CIROH-Snow/snow_sensing/hardware/README.md

### Snow Sensing Hardware

This folder contains hardware designs and specifications for building snow sensing stations, including sensors, dataloggers, communication peripherals, power, and deployment hardware.

Specific guidance on soldering, wiring, and constructing the station can be found in their respective guide files in this folder. Any programming and software instructions are found in the "code" folder of the repository.

We recommend that you begin with our [Getting Started Guide](../docs/getting_started.md).
