CIROH-Snow/snow_sensing/code/mayfly_datalogger/README.md

# Mayfly Datalogger Code

This folder contains the Arduino sketches that will ultimately be uploaded to the Mayfly datalogger that is used for making and recording snow measurements. There are two types of snow stations that you can deploy: 

1. Stand-alone stations that do not telemeter their data: These stations simply make measurements and record those measurements to a microSD card attached to the Mayfly datalogger board.
2. Stations that have telemetry via either cellular or 900 MHz spread spectrum radio modules: These stations likewise record measurements to an attached microSD card but also send that data either over 900 MHz spread spectrum radio to another data logger that is connected to a Hydrologic Information System (HIS) or directly posts that data to a HIS if it has cellular service at the station.

Further instruction is found in each sub-folder based on the approach you are planning on taking with your snow station. Regardless of which approach you choose, you need to follow the hardward configuration steps below to prepare your Mayfly datalogger and sensors for data collection.

## Hardware needed to successfully program the Mayfly datalogger and sensors 

The following hardware components are needed to successfuly configure and program your Mayfly datalogger and sensors:

* Mayfly datalogger: [EnviroDIY Link](https://www.envirodiy.org/product/envirodiy-mayfly-data-logger/)
* CR1220 battery: [DigiKey Link](https://www.digikey.com/en/products/detail/panasonic-bsg/CR1220/269740?s=N4IgTCBcDaIA4AYDMSC0A7AJiAugXyA)
* USB to USB-C cable (make sure it has a data line on it and that it isn't just a charging cable): [Amazon Link](https://www.amazon.com/Anker-2-Pack-Premium-Samsung-Galaxy/dp/B07DD5YHMH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)
* Sparkfun Bee explorer board: [SparkFun Link](https://www.sparkfun.com/products/11812)
* USB to mini USB cable (or whatever the Sparkfun Bee expolorer board USB port is; likewise make sure it isn't just a charging cable but that it has data transfer capabillities): [Amazon Link](https://www.amazon.com/Amazon-Basics-Charging-Transfer-Gold-Plated/dp/B00NH11N5A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)
* EnviroDIY grove to 3.5 mm stereo jack converter: [EnviroDIY Link](https://www.envirodiy.org/product/envirodiy-grove-to-3-5mm-stereo-jack-pack-of-2/) 
* Grove cable: [DigiKey Link](https://www.digikey.com/en/products/detail/seeed-technology-co-ltd/110990031/5482557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)
* MicroSD card: [Amazon Link](https://www.amazon.com/PNY-Elite-X-microSDXC-Memory-3-Pack/dp/B08T6QSBPJ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)
* EnviroDIY microSD vertical card adapter (optional and comes with Mayfly datalogger purchase): [EnviroDIY Link](https://www.envirodiy.org/product/envirodiy-vertical-microsd-card-adapter-pack-of-5/)

## Datalogger and Sensor Hardware Configuration Steps

**IMPORTANT: You need to complete the following steps to configure the datalogger and sensor hardware before you edit and upload the Arduino Mayfly sketch found in this folder for logging data.** This guide also assumes that you have already completed the required soldering, wiring, and construction steps for setting up a station. If you have not done so already, you should consult our [guide for getting started](../../docs/getting_started.md).

### 1. Set the real-time clock (RTC) on the Mayfly datalogger

1. Insert your coin battery with the positive side up into the battery slot found on the right side of the board below the two white LiPo connectors.
2. Open the Arduino IDE and connect your Mayfly to your laptop.
3. Under the "File" tab, navigate to the sketch needed for adjusting the RTC (note that you may have to scroll down a little in the Examples dropdown to the "Examples from custom libraries" subsection): Examples > EnviroDIY_DS3231 > adjust
4. Line 11 is where you adjust the datetime, following the parameters described in the comments above the line. Make sure you set this to the UTC time. The final sketch we upload to the Mayfly will have a parameter for adjusting to your timezone.
5. Once you have that ready, turn on your Mayfly and upload the sketch.
6. Check that you properly adjusted the RTC by turning on your serial monitor in the Arduino IDE (setting the baud rate to whatever was set in the setup function on line 16).
7. From here, **DO NOT POWER DOWN YOUR MAYFLY**. It will reset your Mayfly's RTC back to whatever you originally had in the program when you power it backup and the Mayfly runs the setup function again.
8. Upload a different example sketch while your Mayfly is still running just so you do not have to worry about it again.
9. Navigate to Examples > EnvrioDIY_DS3231 > now
10. Upload the sketch
11. You may now power off and disconnect the Mayfly without it reseting the RTC

### 2. Record pyranometer and pyrgeometer calibration factors

Make sure you have the pyranometer and pyrgeometer calibration factors on-hand. You will need them when you adjust the Arduino code on your Mayfly after these steps are complete. These should have been provided by the sensor manufacturer.

### 3. Measure the height of the Maxbotix snow sensor

If you are using the Maxbotix snow depth sensor to measure snow depth, you will need to measure the distance between the sensor and bare ground so that the datalogger program can determine zero snow depth.

1. You can manually measure this, or you can use the "test_maxbotix" file found in snow_sensing > code > utilities > test_sensors. When used after the sensor has been installed but before any snow has fallen, this program will read out the sensor height (distance from ground surface to the sensor). You should get a height in millimeters, and write it down so you can add it to your data logging sketch you'll upload upon final deployment.
2. It is suggested that you manually measure the height of the sensor, as it loses accuracy without a snow surface to measure.

### 4. Set SDI-12 addresses of meter Teros 12 soil sensors

If you are using the Meter Teros 12 soil sensors, you will need to set their SDI-12 addresses within the sensors themselves. They operate on SDI-12 protocol which requires unique addresses for each sensor since all of the sensors are connected to the same SDI-12 bus on the Mayfly datalogger. Use the following steps to set the SDI-12 addresses. 

1. Take one of your sensors and connect it to a stereo-jack to grove terminal converter, the same converter that you will use for your station deployment
2. Connect the grove end to one of the Mayfly's SDI-12 ports using a grove cable. There are two ports on the board. It does not matter which one you connect it to.
3. Open the Arduino IDE, and navigate through the examples: File > Examples > SDI-12 > b_address_change
4. Turn on your Mayfly and upload the b_address_change sketch
5. Open your serial monitor and adjust its baud rate to match what is defined for SERIAL_BAUD near the beginning of the sketch
6. Follow the serial monitor's prompts for changing the addresses, giving it a singular character for the address (it can be a number, uppercase letter, or lowercase letter) and pressing enter to send the character to the Mayfly
7. Take a Sharpie and identify the sensor itself with the address so you know which sensor is which when you go to install
8. You may consider having the following setup: sensor 'a' for a depth of 2", sensor 'b' for a depth of 8", and sensor 'c' for a depth of 20"

### 5. Set the switched power jumper headers on the Mayfly datalogger

These steps are described in the hardware wiring guide in the hardware section of this repository, but are included again here for double checking before final programming. Follow these steps to ensure that the switched power jumpers are set correctly on the Mayfly datalogger:

1. At the top of each grove port on the Mayfly, there is a little, black header with four pins that identifies how much voltage is supplied over the switched power to that grove terminal.
2. The voltage supplied to each terminal is set by moving the jumper that connects one of the three outer pins to each headers' center pin.
3. Using a very fine, sturdy point, such as a very small flathead screwdriver, carefully make the following adjustments:
   * Above the D5-6 grove terminal, move the jumper to 5v.
   * Above one of the SDI-12 grove terminals (it does not matter which), move the jumper to 12v.
   * Above the other SDI-12 grove terminal, move the jumper to 3v (it may already be there by default).
   * Above the D10-11 grove terminal, move the jumper to 5v.
   * Above the Aux Analog grove terminals, move the jumper to 3v (it may already be there by default).

### 6. Attach the MicroSD card

There are two options for attaching the MicroSD card. You may use the socket found on the left-hand side, or you may also use the adapter that likely came with your purchase of the Mayfly datalogger. Simply insert the 8 prongs of this adapter into the 8-pin header above the SD socket, matching the white outline on the Mayfly. Insert the MicroSD card into the slot and push down until it clicks.

### 7. Program XBee Radio Modules (OPTIONAL)

**NOTE: You need only follow these steps if you are adding telemetry to your snow sensing station.**

If you will be using the XBee S3B modules to develop a network of stations, you need to program those modules. Use the following steps:

1. Download the XCTU software for interfacing with the XBee modules
   * Click on the link: https://www.digi.com/products/embedded-systems/digi-xbee/digi-xbee-tools/xctu
   * Click on the button: "Visit Support to Download XCTU"
   * Scroll down to "Product Resources"
   * Under "Resources and Utilities" select the XCTU link for your operating system and follow the instructions
2. You will want an explorer board from sparkfun in order to easily interface with XCTU (https://www.sparkfun.com/products/11812)
   a. Note that there are other explorer boards you can get, but make sure you can obtain the necessary cables for powering and using serial communication
3. Attach your XBee S3B to the explorer making sure to match the board's geometry to the white outlines on the explorer
4. Attach the board to your computer. If you get a different explorer board, note that you may need to supply power externally, such as with a barrel jack and wall plug.
5. Open the XCTU software
6. In the top left, select the button showing a module with a magnifying glass over it to discover the radio module
7. Select the port the radio is connected to
8. Press Next
9. Make sure the following settings are set:
   * Baud Rate: 9600
   * Data Bits: 8
   * Parity: None
   * Stop Bits: 1
   * Flow Control: None
10. Press Finish
11. A list of discovered devices should appear. If this does not work, hit cancel and try to add the radio module in the home page by selecting the button with the + sign and using the same parameters
12. Select your device and press "Add selected devices"
13. You should be taken back to the home page where your device is listed on the left
14. Click on the module from that list (it should highlight orange when selecting it), avoiding the buttons on the right side
15. This will open up all the radio settings.
16. Under MAC/PHY settings, set Network ID (ID) to something significant to you that all radios will be on. Note that if two radios' network IDs do not match, they will not be able to communicate.
17. Under MAC/PHY settings, set Unicast Mac Retries (RR) to F
18. Under Network settings, set Mesh Unicast Retries (MR) to 5
19. Under Addressing settings, set the Node Identifier (NI) to something meaningful such as the name of the station the module will be placed on
20. Under Addressing settings, make sure that the Transmit Options (TO) is set to C0 (DigiMesh)
21. Under Serial Interfacing options, set API Enable (AP) to API Mode Without Escapes
22. Under Sleep Commands, set Sleep Mode (SM) to Async. Pin Sleep
23. Save these changes by pressing the "Write" button at the top
24. Your XBee is programmed, so clear it from the list on the left by clicking the module's "X" button
25. Unplug the cable from your computer or explorer before removing the XBee from the explorer

### Creating and uploading the final Mayfly sketch for logging data

Once your station is constructed and you have completed the above steps, you are ready to make adjustments to the Arduino sketch you would like to use. You will start with the Arduino sketches we have provided, make minor modifications to fit your deployed station, and then upload your final sketch to your Mayfly datalogger to collect data.

**NOTE:** We recommend getting the sketch for the snow sensing3 station with no telemetry working before you move on to the station with telemetry.

Follow the instructions for each sketch before uploading.

* [Snow sensing station with no telemetry](no-telemetry/README.md)
* [Snow sensing station with telemetry](telemetry/README.md)

**NOTE:** The datalogger sketches with telemertry contain all of the code for measuring and logging data along with the code for telemetring the data to a HIS.
