CIROH-Snow/snow_sensing/code/arduino_libraries/EnviroDIY_SoftwareSerial_PCINT12/README.md

# SoftwaterSerialMod
A modified version of the Arduino built-in SoftwareSerial library to work with other libraries using pin change interrupts.  This version only uses PCINT1 and PCINT2.
