CIROH-Snow/snow_sensing/code/base_station/base_figures/tgrs_example.png

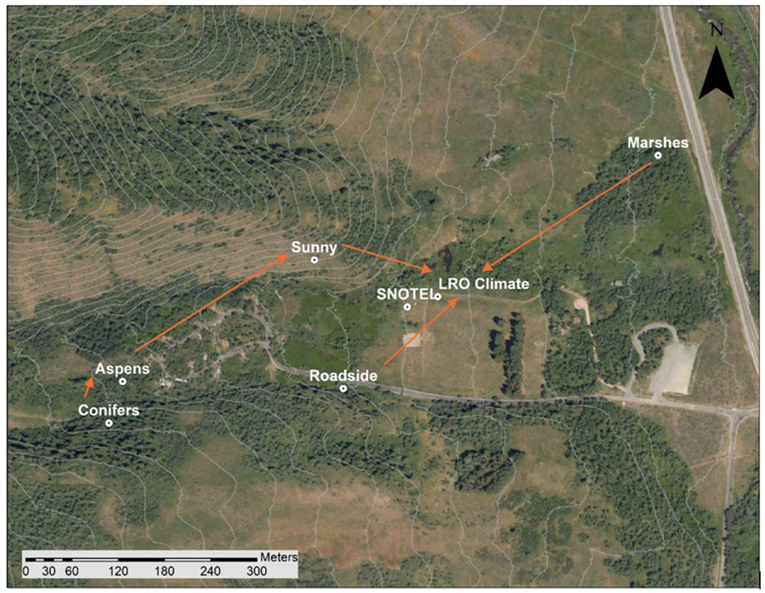
code/base_station/base_figures/tgrs_example.png
