CIROH-Snow/snow_sensing/hardware/hardware_spreadsheet_not_campbellsci.xlsx

Snow Sensing Node
Item | Number | Unit Cost | Total Cost |  | Notes
Datalogger and communication peripherals
EnviroDIY Mayfly data logger board | 1 | $120.00 | $120.00 | Link (https://www.envirodiy.org/product/envirodiy-mayfly-data-logger/)
CR1220 Coin cell battery | 1 | $1.12 | $1.12 | Link (https://www.digikey.com/en/products/detail/panasonic-bsg/CR1220/269740?s=N4IgTCBcDaIA4AYDMSC0A7AJiAugXyA) | For the real time clock on the Mayfly board
Grove cable connectors for connecting sensors (5 pack) | 2 | $3.50 | $7.00 | Link (https://www.digikey.com/en/products/detail/seeed-technology-co-ltd/110990031/5482557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) | Connectors for sensors. Four cables will be cut and splayed for conneting the Meter sensors
Grove screw terminal | 4 | $1.70 | $6.80 | Link (https://www.seeedstudio.com/Grove-Screw-Terminal.html) | Connect sensors to grove cables
Xbee Radio for datalogger communications | 1 | $79.00 | $79.00 | Link (https://www.amazon.com/gp/product/B07G1XQ1BS/ref=ppx_yo_dt_b_search_asin_title?ie=UTF8&psc=1) | 900 MHz - but other options available
Omnidirectional 900 MHz antenna | 1 | $3.99 | $3.99 | Link (https://www.data-alliance.net/antenna-824-960mhz-1710-1990mhz-3dbi-omnidirectional-dipole-w-sma-rp-sma-or-fme/) | These could be inadequate for distance/vegetation
3-port lever wire connectors (pack of 10) | 1 | $7.98 | $7.98 | Link (https://www.lowes.com/pd/IDEAL-Lever-Wire-Connectors-3-Ports-Clear-10-Pack/5014013101) | Sold in pack of 10
MicroSD card (pack of 2) | 1 | $6.23 | $6.23 | Link (https://www.amazon.com/SanDisk-2-Pack-microSDHC-Memory-2x32GB/dp/B08J4HJ98L?s=electronics) | 32 GB (Link is to a pack of 2 for $12.47)
EnvrioDIY grove to 3.5mm stereo jack | 3 | $7.00 | $21.00 | Link (https://www.envirodiy.org/product/envirodiy-grove-to-3-5mm-stereo-jack-pack-of-5/) | Provides stereo sensor connectors (Sold in packs of 5 for $35.00)
Compact wire splice connector quick terminal block | 2 | $2.87 | $5.74 | Link (https://www.amazon.com/GKEEMARS-Electrical-Connectors-Compact-Terminal/dp/B08Y5TGZR3) | Sold in packs of 8 for $22.98. Connects SDI-12 Meter sensors to singular port on Mayfly
Prototype PCB solderable breadboard | 1 | $1.70 | $1.70 | Link (https://www.amazon.com/gp/product/B07ZYNWJ1S/ref=ppx_yo_dt_b_asin_title_o02_s00?ie=UTF8&th=1) | For securing and connecting peripheral ADCs. Sold in packs of 5 for $8.49
Adafruit ADS1115 ADC | 2 | $14.95 | $29.90 | Link (https://www.adafruit.com/product/1085) | Necessary to expand Mayfly datalogger for taking differential measurements from all radiation sensors
6-pin PCB screw terminal block connector | 4 | $0.81 | $3.24 | Link (https://www.amazon.com/Augiimor-15PCS-2-54mm-Terminal-Connector/dp/B08B3SY1PG) | Terminal block to connect sensor wires to ADCs on PCB sold in pack of 15 for $12.99
Jumper cables (male-to-male) (pack of 120) | 1 | $6.88 | $6.88 | Link (https://www.amazon.com/Elegoo-EL-CP-004-Multicolored-Breadboard-arduino/dp/B01EV70C78)
I2C Qwiic cable pack | 1 | $9.99 | $9.99 | Link (https://www.amazon.com/gp/product/B08HQ1VSVL/ref=ppx_yo_dt_b_asin_title_o09_s00?ie=UTF8&psc=1) | Connects extra ADCs to Mayfly
PVC Jacketed 22 Gauge 5 conductor wire - cabling for MaxBotix sensor | 10 | $0.59 | $5.90 | Link (https://www.superbrightleds.com/pvc-jacketed-5-conductor-22-awg-power-wire-pp-frpvc-gray-wp22-5cmr) | Cable for Maxbotix snow depth sensor (Price is per foot. Length depends on deployment platform).
Data logger and communications total |  |  | $316.47
Instrumentation Enclosure and Mounts
Weather proof handgun case | 2 | $54.99 | $109.98 | Link (https://www.sportsmans.com/shooting-gear-gun-supplies/gun-cases-locks/handgun-cases/sportsmans-warehouse-16in-pistol-case/p/1873059) | One enclosure for the data logger and one for the battery. If you decide to go with a small enough battery to fit in the same enclosure as the data logger then you don't need two of these
U-bolts | 4 | $2.08 | $8.32 | Link (https://www.lowes.com/pd/National-Hardware-N222-182-U-Bolts-in-Zinc-Plated/5003643211) | For fastening the enclosure to the mast and for the solar panel. For the solar panel, you may want to get a u-bolt with a plate. These are zinc plated. Stainless would be better but more expensive. You may also have better luck finding them at Lowes or Campbell Scientific.
AM-130 Albedometer Mounting Fixture with 12" Rod | 2 | $42.00 | $84.00 | Link (https://www.apogeeinstruments.com/am-130-albedometer-mounting-fixture-with-12-rod/) | For mounting pyranometers and pyrgeometers
AM-240: Rod-based Mounting Fixture | 2 | $84.00 | $168.00 | Link (https://www.apogeeinstruments.com/am-240-rod-based-mounting-fixture/)
Nuts and bolts for solar panel | 1 | $1.48 | $1.48 | Link (https://www.lowes.com/pd/Hillman-1-4-in-20-x-3-4-in-Slotted-Drive-Machine-Screws-4-Count/3035943) | For improving the solar panel mount's rigidity
Mast padding for solar panel | 1 | $5.95 | $5.95 | Link (https://www.amazon.com/dp/B099QPW1SS?ref=fed_asin_title&th=1) | Holds solar panel against main mast. Sold in packs of 2 for $11.89
MaxBotix MB7950 Mounting Hardware | 1 | $3.43 | $3.43 | Link (https://www.digikey.com/en/products/detail/maxbotix-inc./MB7950-000/10279125?gad_source=1) | Seals and fixes MaxBotix sonar in sensor enclosure (sensor is not sealed so needs a separate enclosure)
Command strips package | 1 | $9.98 | $9.98 | Link (https://www.lowes.com/pd/Command-Medium-Picture-Hanging-Strips-Value-Pack/1000028619) | Sold in packs of 12 pairs. Used for mounting hardware inside enclosure (housekeeping essentially)
Polycase HD-22F NEMA Polycarbonate Enclosure | 1 | $7.40 | $7.40 | Link (https://www.polycase.com/hd-22f) | Waterproof enclosure for MaxBotix sonar (must drill enclosure lid to fix threaded end of sensor inside enclosure)
Cable glands package | 1 | $8.49 | $8.49 | Link (https://www.amazon.com/eBoot-Plastic-Waterproof-Adjustable-3-5-13mm/dp/B01GJ03AUQ?hvadid=194019628201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) | Running MaxBotix cable through enclosure sold in packs of 20 for $9.99 (must drill enclosure for cable gland)
Radiation shield | 1 | $54.99 | $54.99 | Link (https://www.amazon.com/dp/B003EB3GE4?ref=fed_asin_title) | For the Apogee ST-110 air temperature sensor
UV-resistant zip ties pack | 1 | $7.49 | $7.49 | Link (https://www.amazon.com/TR-Industrial-TR88302-Multi-Purpose-Cable/dp/B01018DC96) | For fixing cables to mast
Duct seal (16 oz.) | 1 | $4.68 | $4.68 | Link (https://www.lowes.com/pd/Gardner-Bender-16-oz-Duct-Seal/4595233) | For plugging the aluminum conduit - keeps out the critters
Southwire 3/4" aluminum conduit | 4 | $1.03 | $4.12 | Link (https://www.lowes.com/pd/Southwire/5003368089) | Sold in 100ft length for $103. Used for protecting soil moisture sensor cables from critters. 4 feet needed.
Enclosure total |  |  | $478.31
Power |  |  |  |  | Power system needs to power a 12V battery - 12V power is needed to run internal heaters on Apogee sensors
2-coil latching relay | 1 | $7.60 | $7.60 | Link (https://www.seeedstudio.com/Grove-2-Coil-Latching-Relay.html) | seeed studio module that can help control power to the apogee radiometer heaters
30 W solar panel and 12 V solar charger | 1 | $74.99 | $74.99 | Link (https://www.amazon.com/dp/B08GX2TLSF?ref=fed_asin_title&th=1) | These are really good, you'll just need to make the mounting a little more robust
Primary wire (black) | 1 | $7.54 | $7.54 | Link (https://www.lowes.com/pd/Southwire-24-ft-16-AWG-Stranded-Black-GPT-Primary-Wire/1001833882) | I would recommend just having extra wire, and you'll need a little bit anyways for splitting connections. I would have extra red and extra black
Primary wire (red) | 1 | $6.63 | $6.63 | Link (https://www.lowes.com/pd/Southwire-24-ft-16-AWG-Stranded-Red-GPT-Primary-Wire/1001833938) | I would recommend just having extra wire, and you'll need a little bit anyways for splitting connections. I would have extra red and extra black
12V 35Ah sealed lead acid battery | 1 | $86.99 | $86.99 | Link (https://www.amazon.com/Interstate-Batteries-battery-Terminal-SLA1155/dp/B000BPAGYY?s=automotive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) | This is just a basic size suggestion if you don't want to worry about sizing for a smaller battery. This should do if you get halfway-decent solar recharge
12V DC to 5V USB-C female DC step-down converter | 1 | $8.99 | $8.99 | Link (https://www.amazon.com/dp/B09DGDQ48H?ref=fed_asin_title) | Takes 12 volts down to what the Mayfly can handle
16 AWG extension cable for solar panel (25-ft length) | 1 | $15.50 | $15.50 | Link (https://www.amazon.com/POWISER-Extension-Disconnect-Connector-Automotive/dp/B07Z7T494M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) | Only necessary if locating solar panel away from station, in which case you will need to measure out how much you need.
Alligator Clips | 2 | $0.67 | $1.34 | Link (https://www.amazon.com/dp/B0BG7RCC11?sp_csd=d2lkZ2V0TmFtZT1zcF9kZXRhaWw) | These are needed to make a connection to the battery. Sold in packs of 6 for $3.99
Power Total |  |  | $209.58
Sensors
METER Teros 12 soil moisture, temperature, electrical cond., 3 depths | 3 | $258.00 | $774.00 | Link (https://www.metergroup.com/en/meter-environment/products/teros-12-soil-moisture-sensor) | SDI-12 output - 4 measurements
MaxBotix MB7374 snow depth analog voltage or pulse width output | 1 | $134.00 | $134.00 | Link (https://www.digikey.com/en/products/detail/maxbotix-inc/MB7374-100/7896824) | Pulse width or single ended voltage output
SL-510-SS Apogee upward pyrgeometer | 1 | $599.00 | $599.00 | Link (https://www.apogeeinstruments.com/sl-510-ss-pyrgeometer-upward-looking/) | Analog differential voltage output
SL-610-SS Apogee downward pyrgeometer | 1 | $599.00 | $599.00 | Link (https://www.apogeeinstruments.com/sl-610-ss-pyrgeometer-downward-looking/) | Analog differential voltage output
SP-710-SS Apogee upward and downward pyranometer | 1 | $663.00 | $663.00 | Link (https://www.apogeeinstruments.com/sp-710-ss-albedometer-sensor-package/) | Analog differential voltage output
ST-110-SS Apogee thermistor temperature sensor | 1 | $85.00 | $85.00 | Link (https://www.apogeeinstruments.com/st-110-ss-thermistor-temperature-sensor/?gad_source=1) | For air temperature. Analog bridge measurement
Sensors Total |  |  | $2854.00
Platform
Down guy wire kit | 1 | $52.00 | $52.00 | Link (https://www.amazon.com/gp/product/B011AEQVNY/ref=ppx_yo_dt_b_search_asin_title?ie=UTF8&psc=1) | Tripod includes guy wire kit, anchors, lightning rod, and grounding kit.
Galvanized steel fence post | 1 | $28.77 | $28.77 | Link (https://www.lowes.com/pd/Common-1-5-8-in-x-1-5-8-in-x-8-ft-Actual-1-66-in-x-1-66-in-x-8-ft-Silver-Galvanized-Steel-Chain-Link-Fence-Line-Post/999990212) | This will be the center mast. You can find taller ones if you have really deep snow packs
U-post | 1 | $5.98 | $5.98 | Link (https://www.lowes.com/pd/Blue-Hawk-Common-3-1-2-in-x-4-ft-Actual-0-6-in-x-3-5-in-x-4-ft-Powder-Coated-Steel-Garden-Fence-U-post-Post/4780963) | You don't need anything crazy here, just something to hold the bottom in place and that can be driven into the ground a fair distance
Grounding cable | 4 | $1.98 | $7.92 | Link (https://www.lowes.com/pd/Southwire-SIMpull-4-AWG-Stranded-Black-Copper-THHN-Wire-By-the-Foot/50101584) | Sold by the foot. You really just need to reach the mast, as you can connect the wire to the mast at any point
Grounding rod and wire clamp | 1 | $19.70 | $19.70 | Link (https://www.amazon.com/GOUNENGNAIL-Copper-Grounding-Rod-Satellite/dp/B08PKZYVLV)
Grounding clamp | 1 | $8.98 | $8.98 | Link (https://www.lowes.com/pd/Sigma-ProConnex-1-1-4-in-Bronze-Grounding-Clamp-Conduit-Fittings/1099109) | Connects grounding wire to mast
Rebar stakes | 1 | $20.49 | $20.49 | Link (https://www.amazon.com/Fercery-Diameter%EF%BC%8CBaking-Process-Paint%EF%BC%8CSteel-Landscpe/dp/B0CM5CCT2T) | Three stakes needed
CM206 6' Campbell Scientific instrumentation crossarm with mounting bracket | 1 | $162.24 | $162.24 | Link (https://www.campbellsci.com/cm206) | Instrumentation crossarm includes right angle mounting bracket for vertical mast.
Mounting Total |  |  | $306.08
Snow Monitoring Station Total: |  |  | $4164.44
