CIROH-Snow/snow_sensing/docs/getting_started.md

# Getting Started 

This document provides a step-by-step overview of the process required to build and program a snow sensing station. The following are links to each of the steps you must complete to create a working station.

1. [Determine a deployment platform](../hardware/deployment_platform.md)
2. [Purchase required hardware components](../hardware/hardware_purchase.md)
3. [Solder necessary components](../hardware/soldering_guide.md)
4. [Construct your station](../hardware/construction_guide.md)
5. [Wire your station and datalogger](../hardware/wiring_guide.md)
6. [Program your station for field data collection](../code/README.md)

**NOTE:** We recommend that you run through all of these steps prior to taking all of the components to the field for deployment. This will enable you to test your station prior to field deployement and will also make it much easier to troubleshoot any issues before going to the field.
