CIROH-Snow/snow_sensing/code/mayfly_datalogger/mayfly_datalogger_figures/hydroserver_setup.png

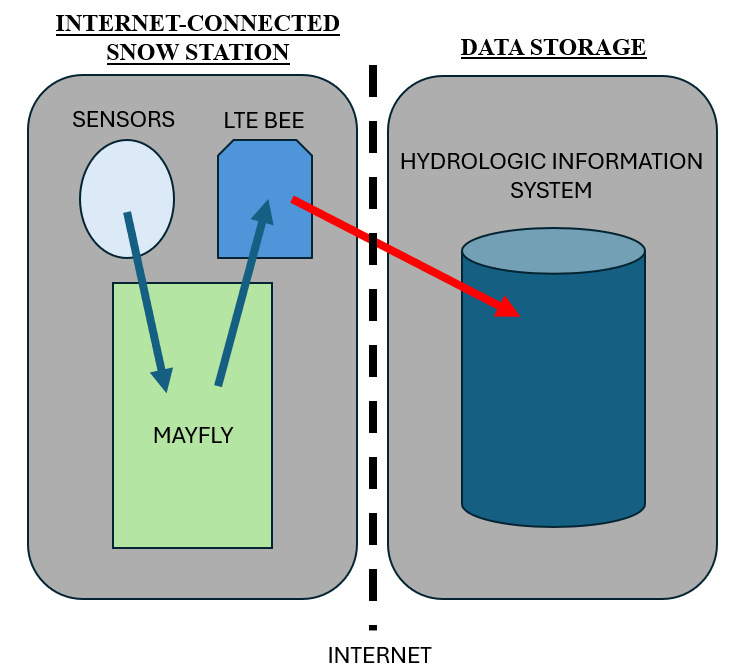
code/mayfly_datalogger/mayfly_datalogger_figures/hydroserver_setup.png
