CIROH-Snow/snow_sensing/hardware/construction_images/IMG_9145.JPG

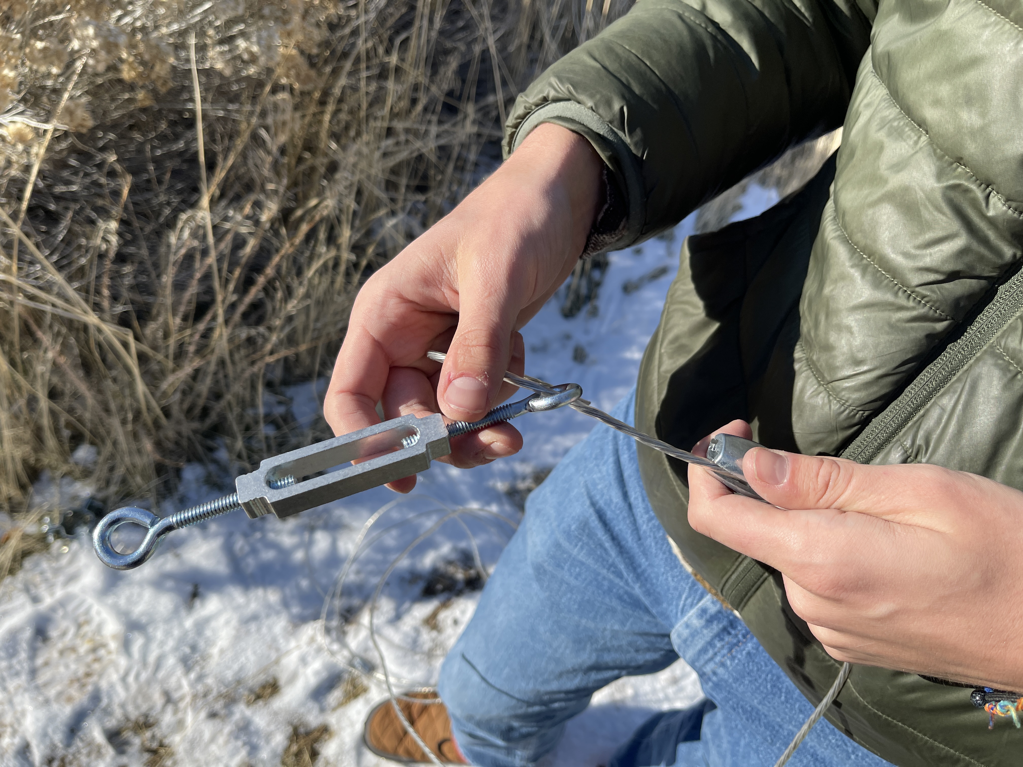
hardware/construction_images/IMG_9145.JPG
