CIROH-Snow/snow_sensing/hardware/construction_images/IMG_9151.JPG

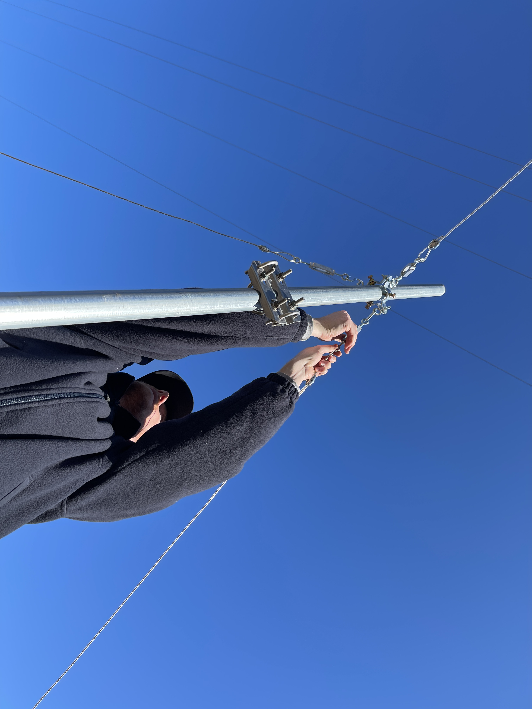
hardware/construction_images/IMG_9151.JPG
