CIROH-Snow/snow_sensing/hardware/construction_images/IMG_9152.JPG

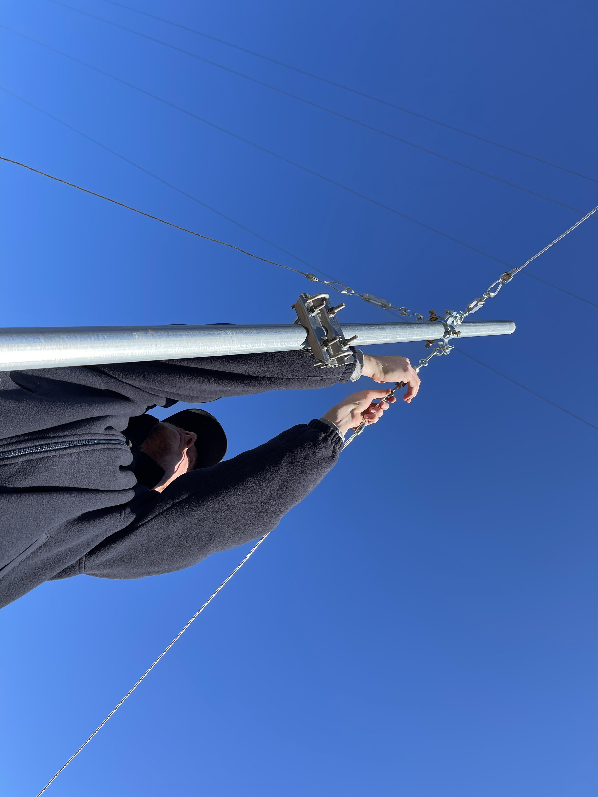
hardware/construction_images/IMG_9152.JPG
