CIROH-Snow/snow_sensing/hardware/construction_images/IMG_9164.JPG

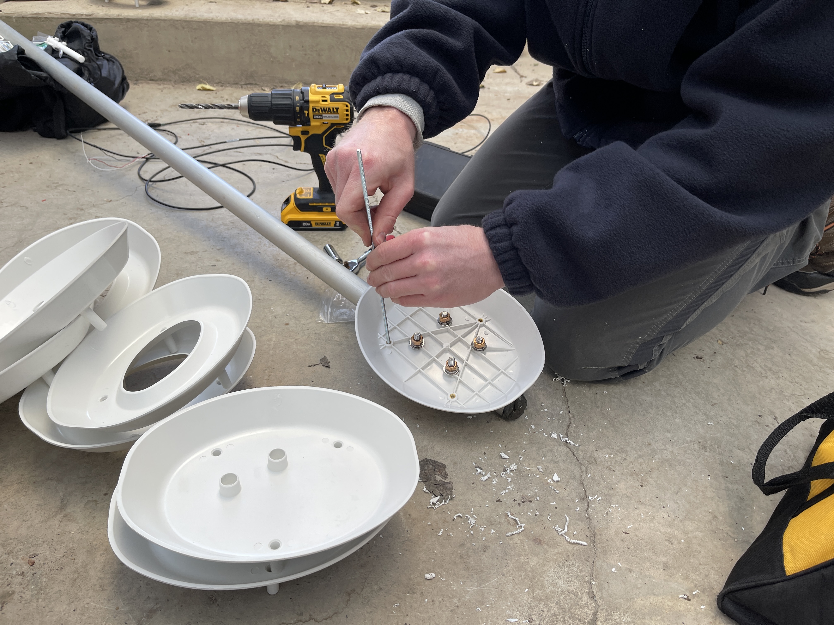
hardware/construction_images/IMG_9164.JPG
