CIROH-Snow/snow_sensing/hardware/construction_images/IMG_9165.JPG

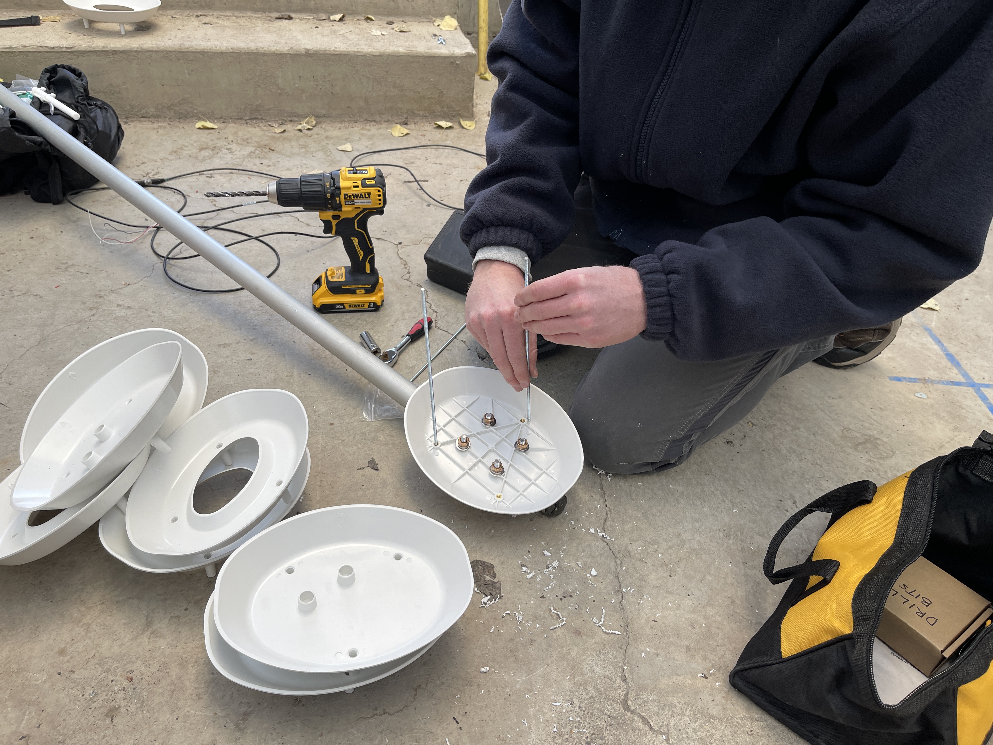
hardware/construction_images/IMG_9165.JPG
