CIROH-Snow/snow_sensing/hardware/construction_images/IMG_9166.JPG

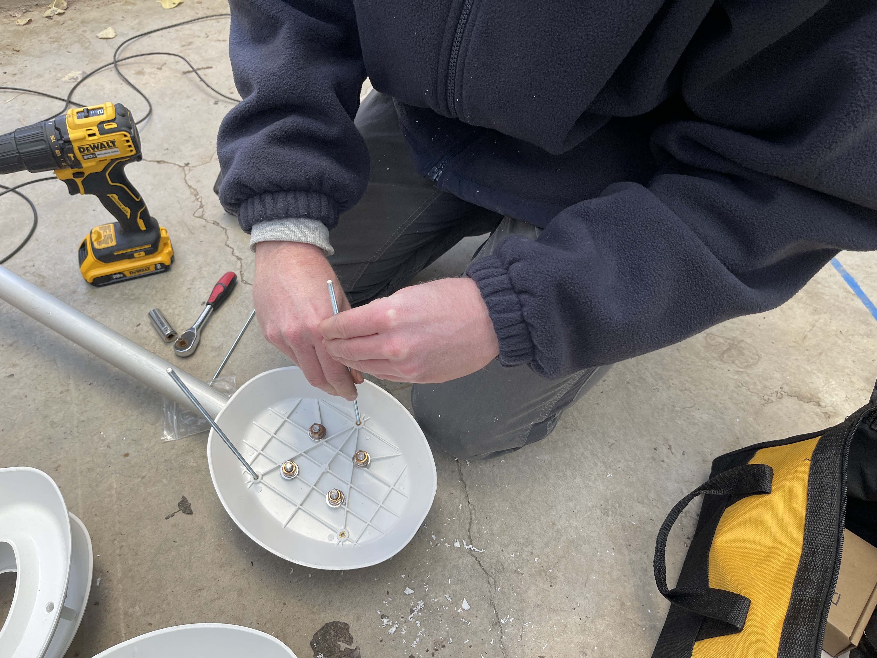
hardware/construction_images/IMG_9166.JPG
