CIROH-Snow/snow_sensing/hardware/construction_images/IMG_9168.JPG

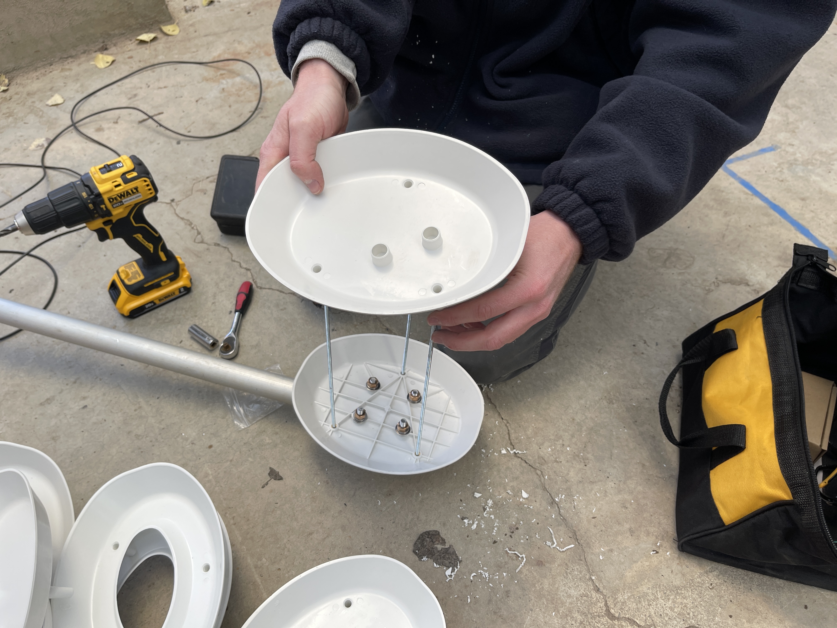
hardware/construction_images/IMG_9168.JPG
