CIROH-Snow/snow_sensing/hardware/construction_images/IMG_9172.JPG

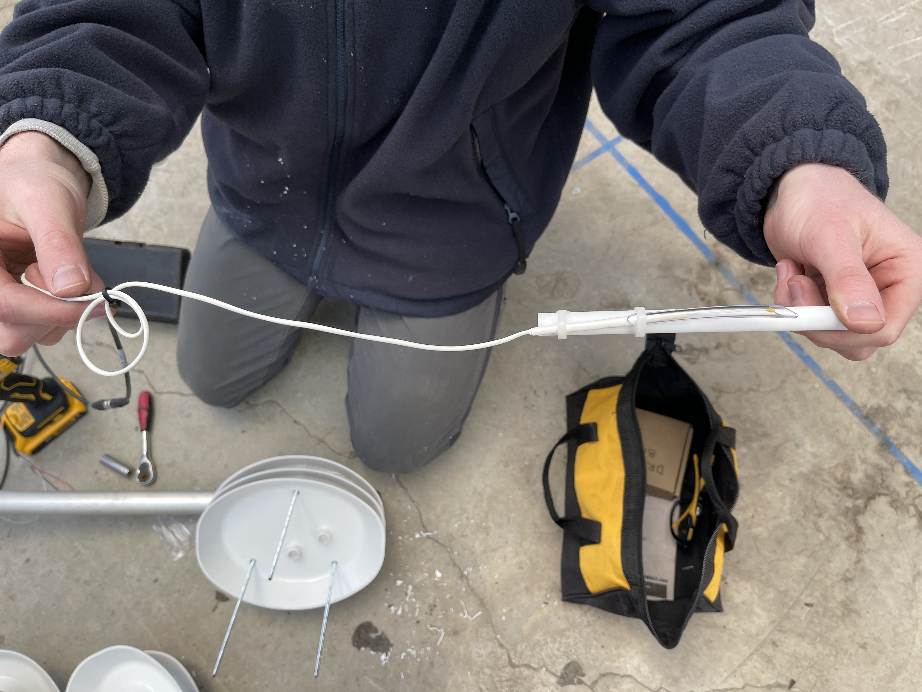
hardware/construction_images/IMG_9172.JPG
