CIROH-Snow/snow_sensing/hardware/construction_images/IMG_9173.JPG

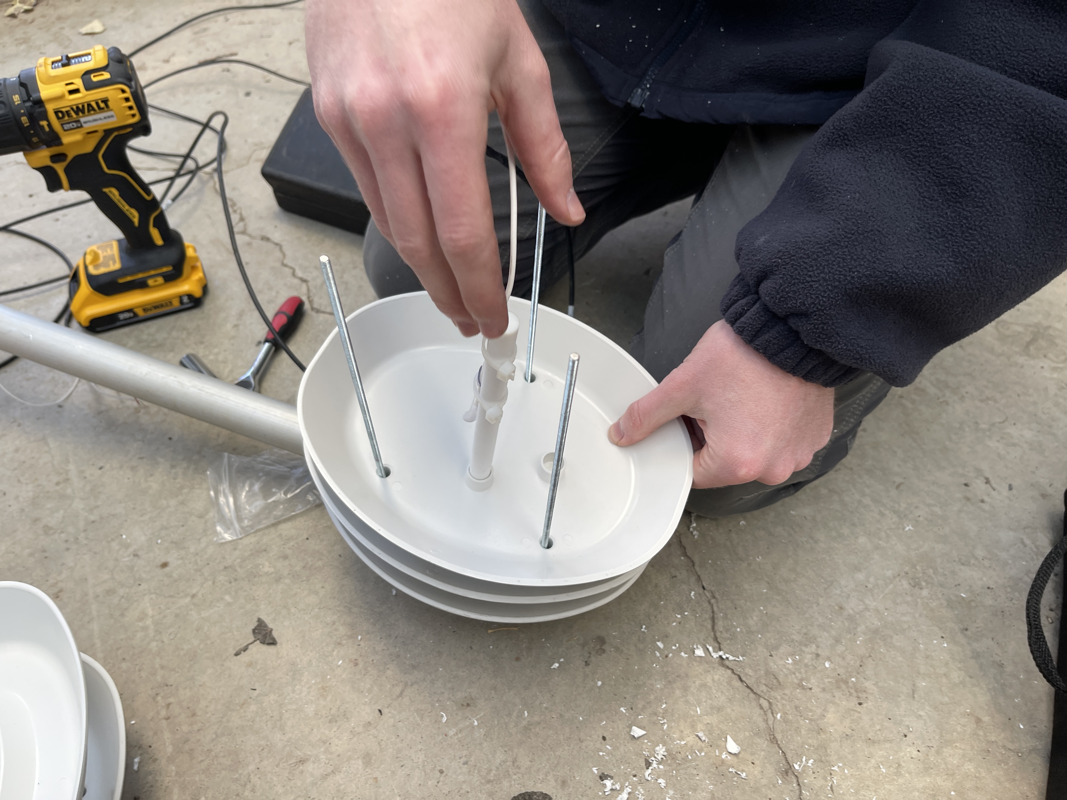
hardware/construction_images/IMG_9173.JPG
