CIROH-Snow/snow_sensing/hardware/construction_images/IMG_9177.JPG

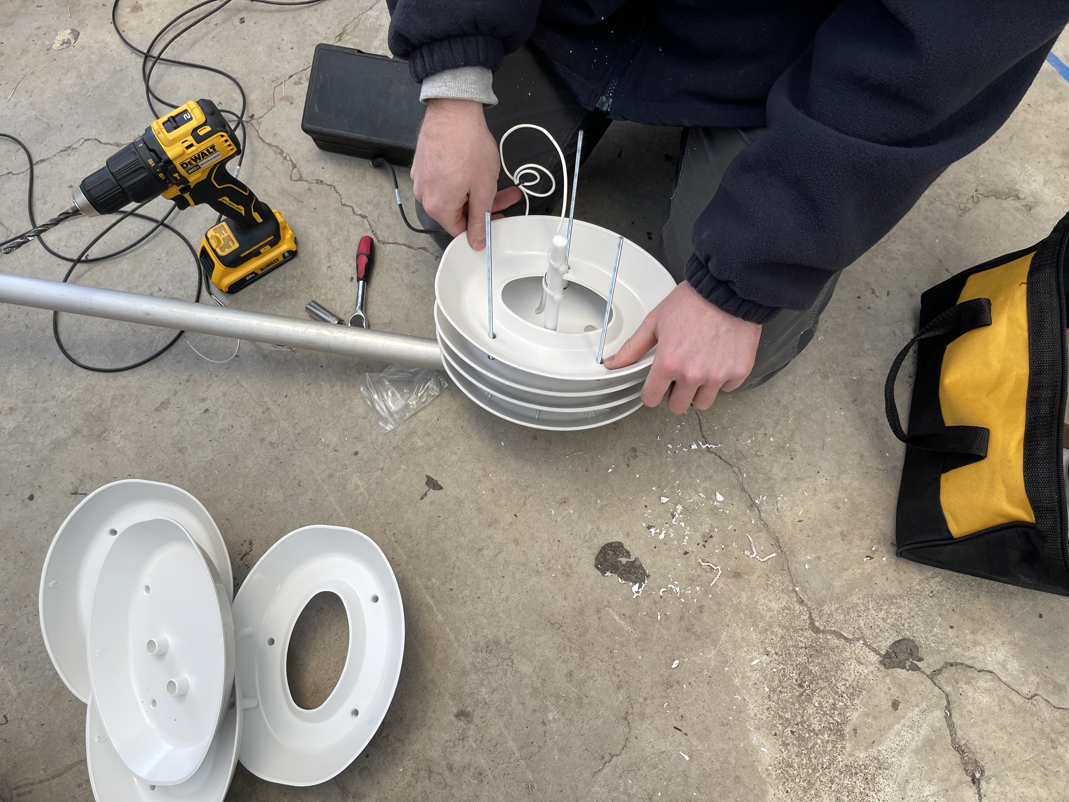
hardware/construction_images/IMG_9177.JPG
