CIROH-Snow/snow_sensing/hardware/construction_images/IMG_9178.JPG

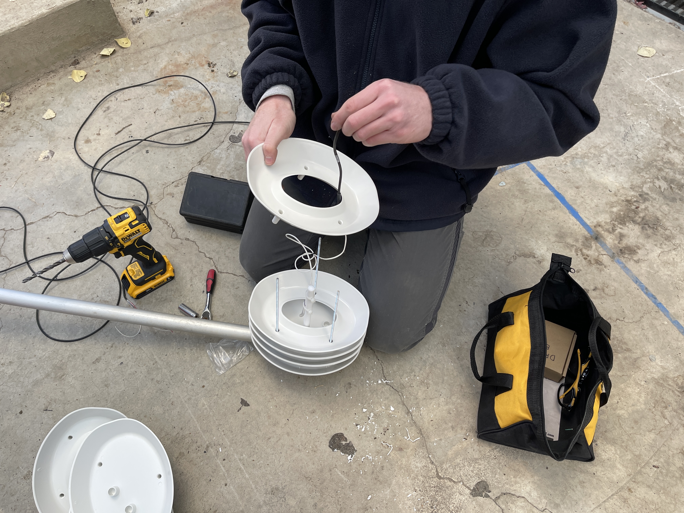
hardware/construction_images/IMG_9178.JPG
