CIROH-Snow/snow_sensing/hardware/construction_images/IMG_9179.JPG

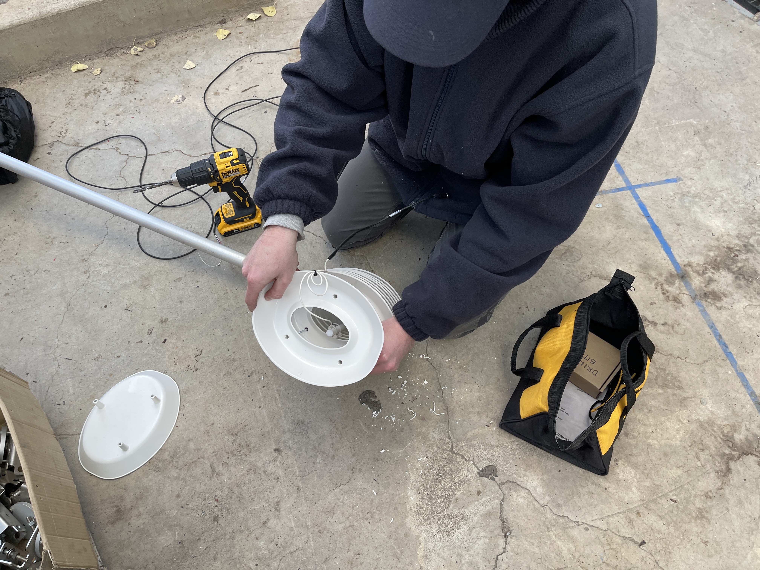
hardware/construction_images/IMG_9179.JPG
