CIROH-Snow/snow_sensing/hardware/construction_images/IMG_9181.JPG

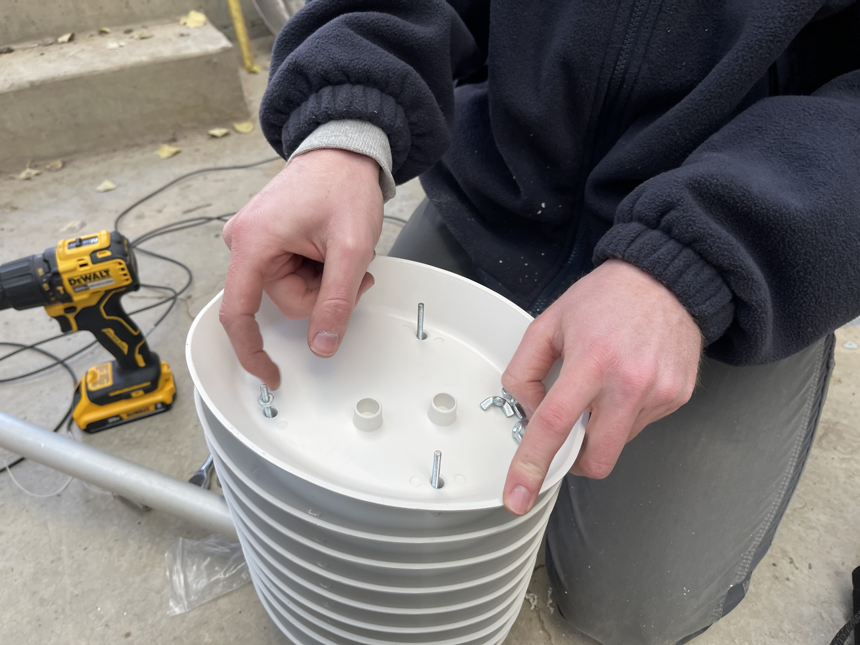
hardware/construction_images/IMG_9181.JPG
