CIROH-Snow/snow_sensing/hardware/construction_images/IMG_9182.JPG

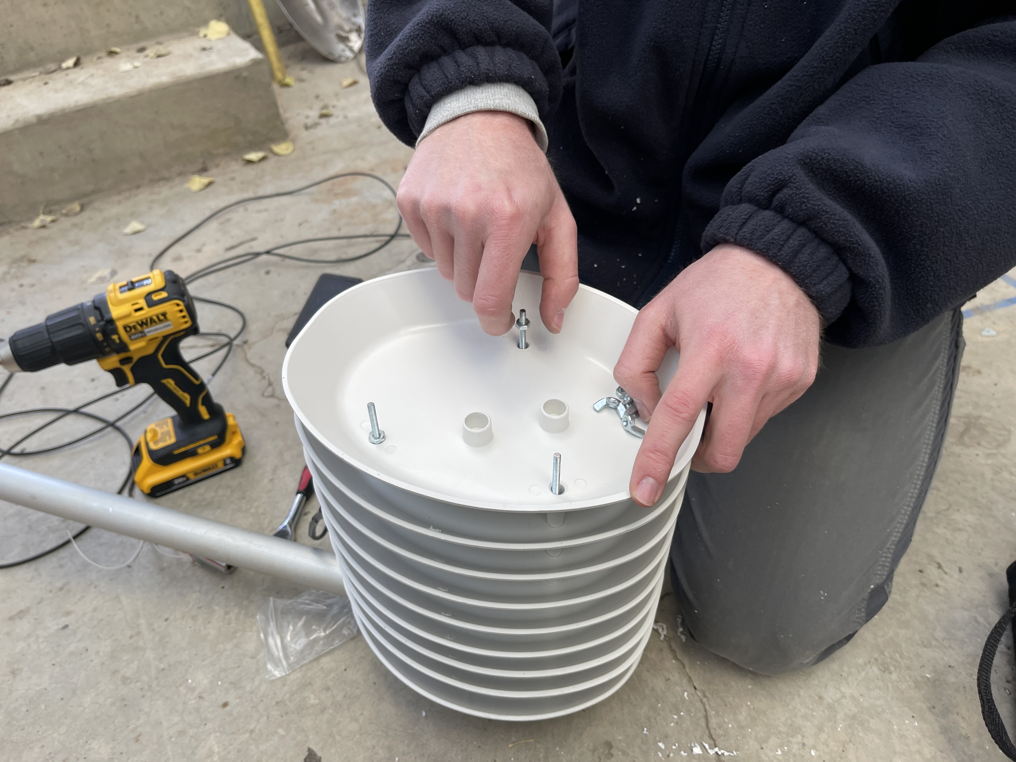
hardware/construction_images/IMG_9182.JPG
