CIROH-Snow/snow_sensing/hardware/construction_images/IMG_9183.JPG

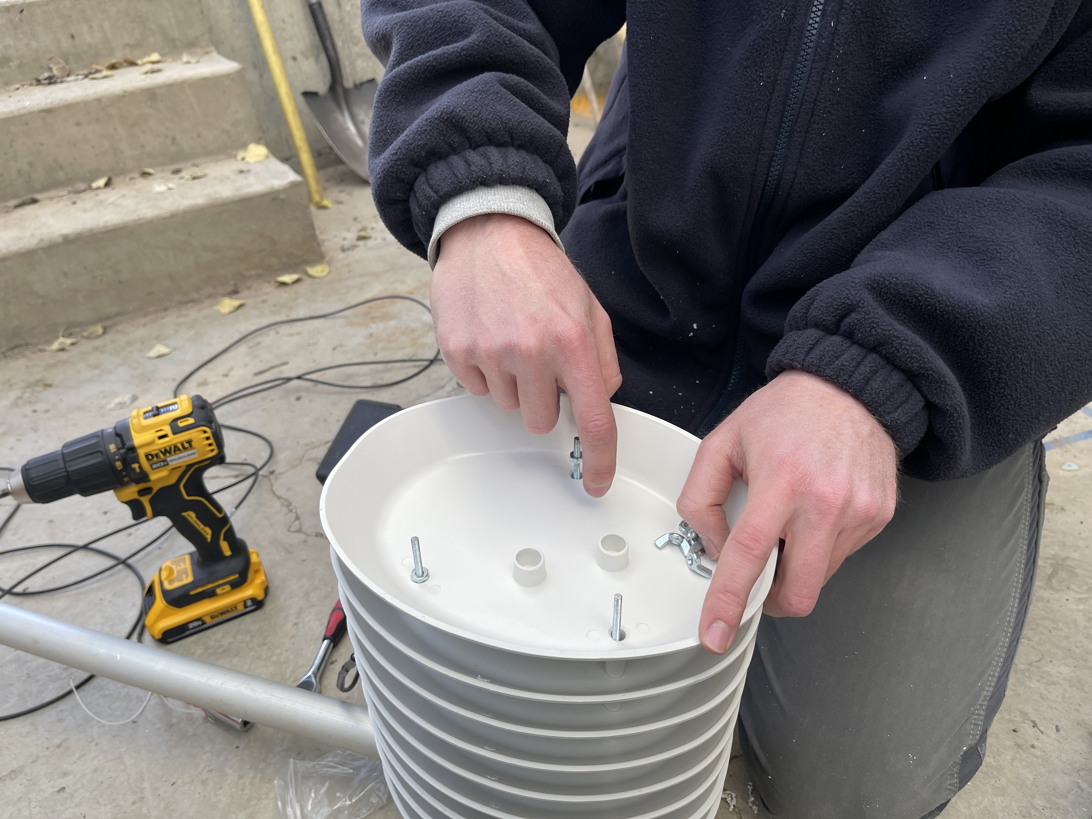
hardware/construction_images/IMG_9183.JPG
