CIROH-Snow/snow_sensing/hardware/construction_images/IMG_9185.JPG

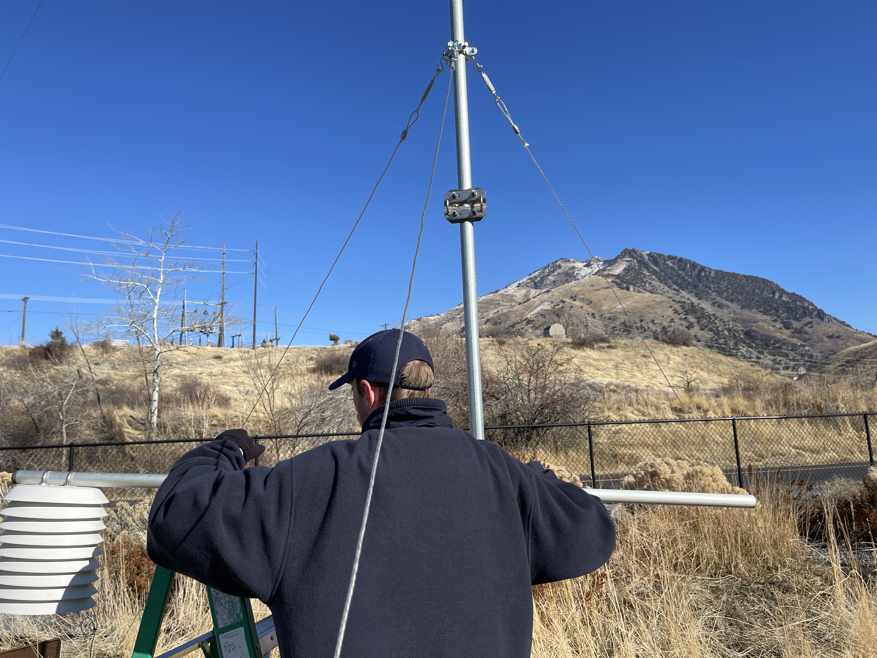
hardware/construction_images/IMG_9185.JPG
