CIROH-Snow/snow_sensing/hardware/construction_images/IMG_9187.JPG

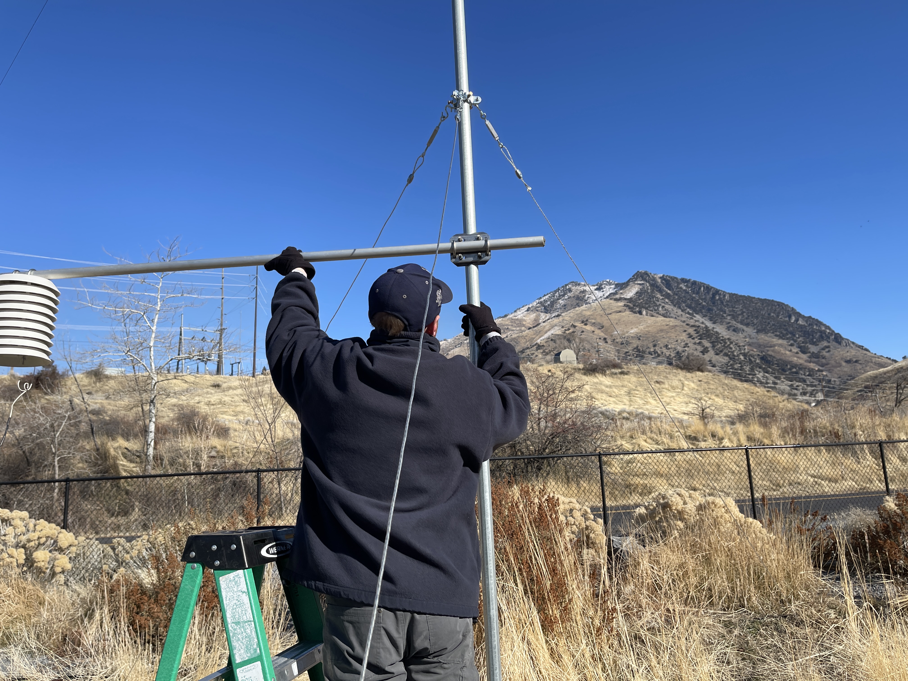
hardware/construction_images/IMG_9187.JPG
