CIROH-Snow/snow_sensing/hardware/construction_images/IMG_9188.JPG

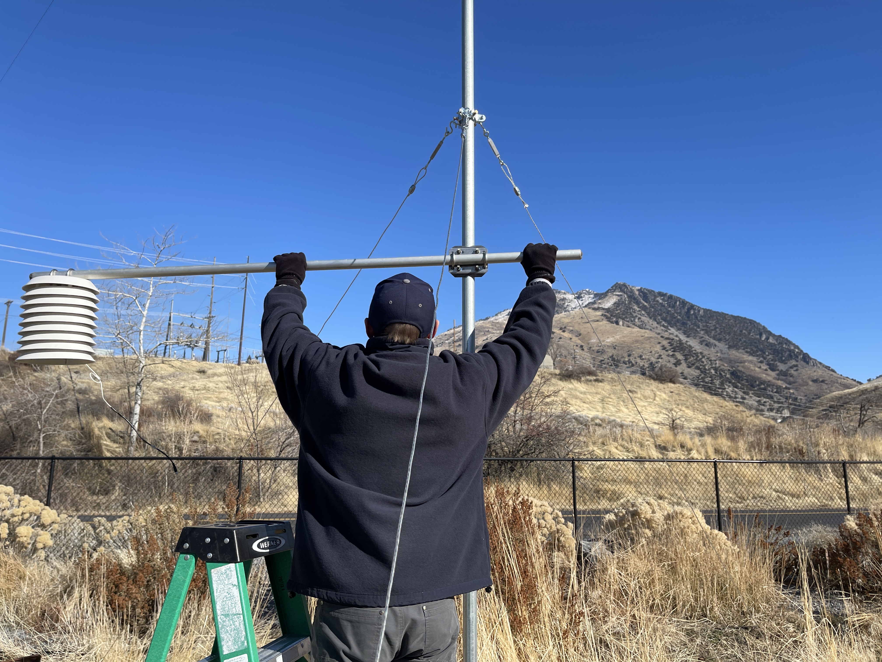
hardware/construction_images/IMG_9188.JPG
