CIROH-Snow/snow_sensing/hardware/construction_images/IMG_9197.JPG

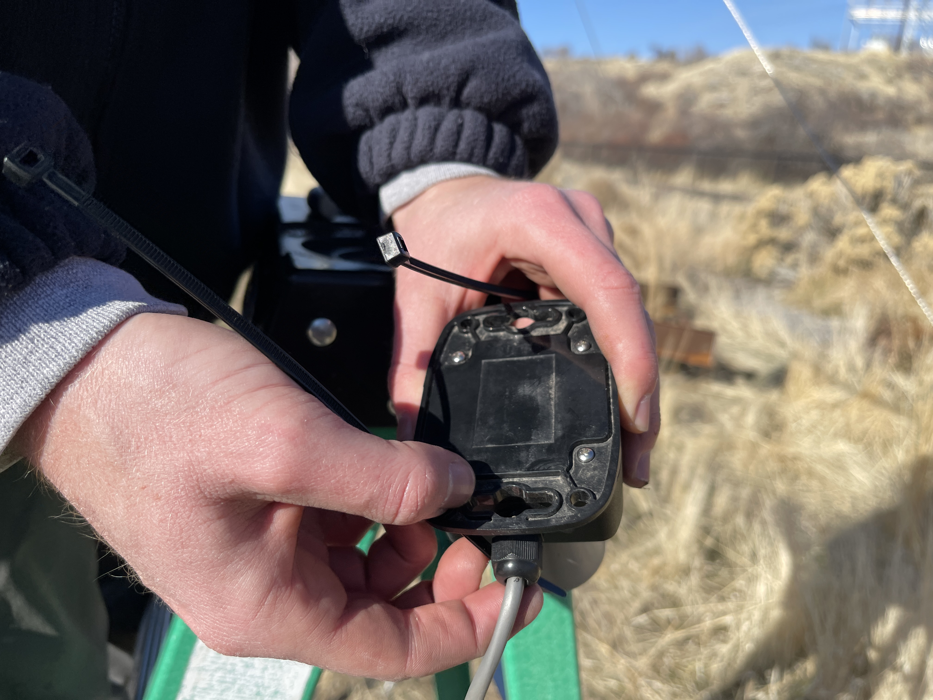
hardware/construction_images/IMG_9197.JPG
