CIROH-Snow/snow_sensing/hardware/construction_images/IMG_9198.JPG

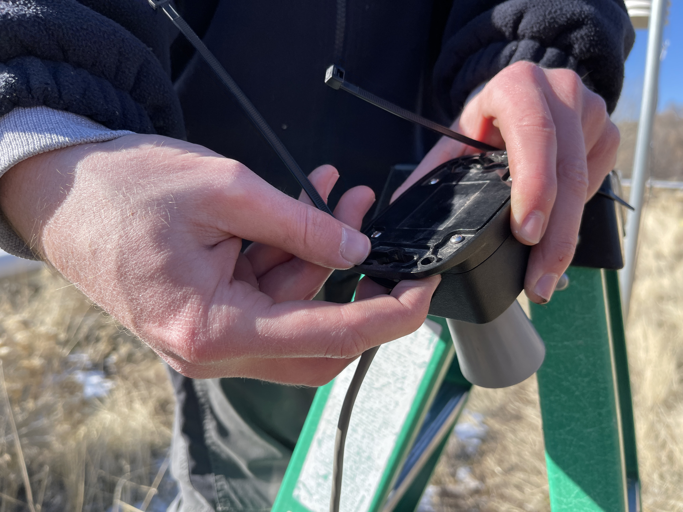
hardware/construction_images/IMG_9198.JPG
