CIROH-Snow/snow_sensing/hardware/construction_images/IMG_9199.JPG

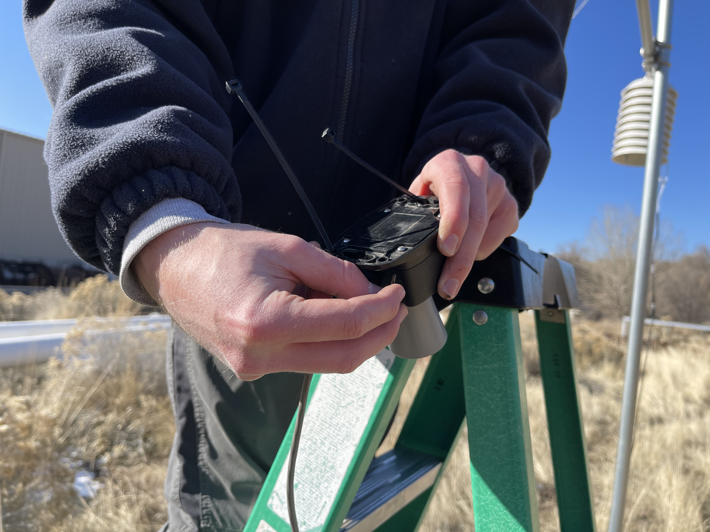
hardware/construction_images/IMG_9199.JPG
