CIROH-Snow/snow_sensing/hardware/construction_images/IMG_9200.JPG

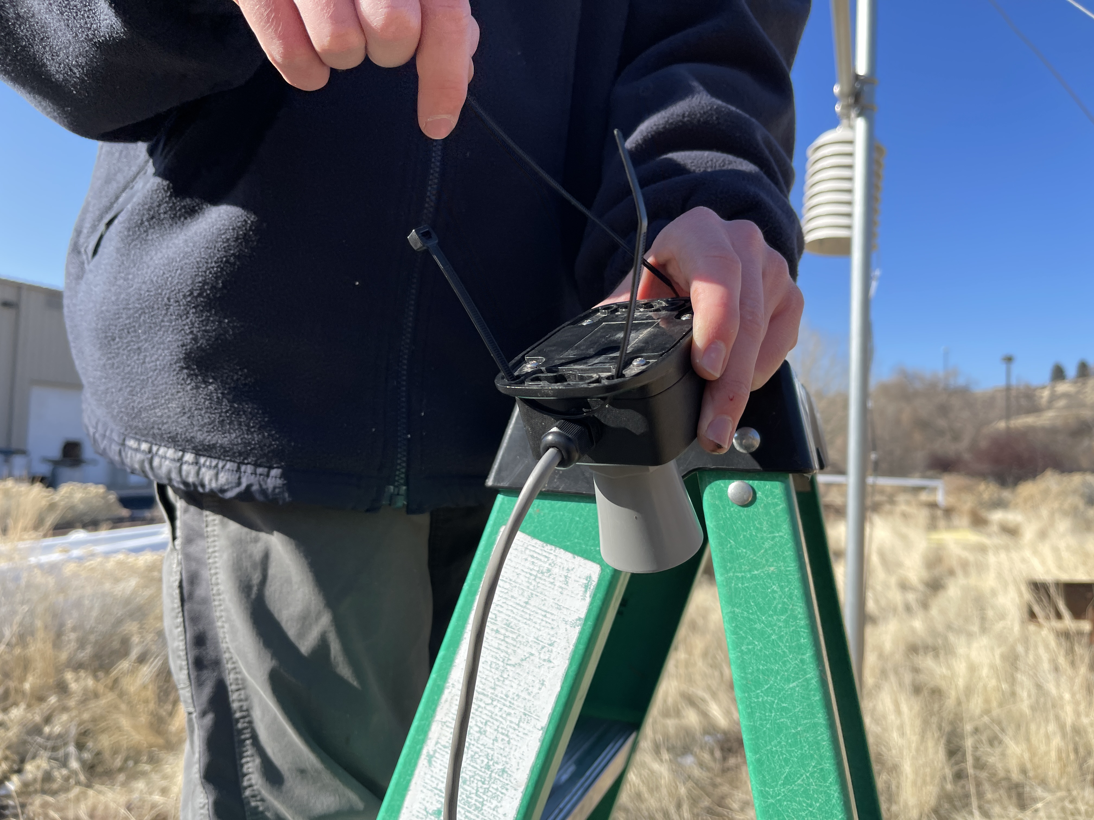
hardware/construction_images/IMG_9200.JPG
