CIROH-Snow/snow_sensing/hardware/construction_images/IMG_9201.JPG

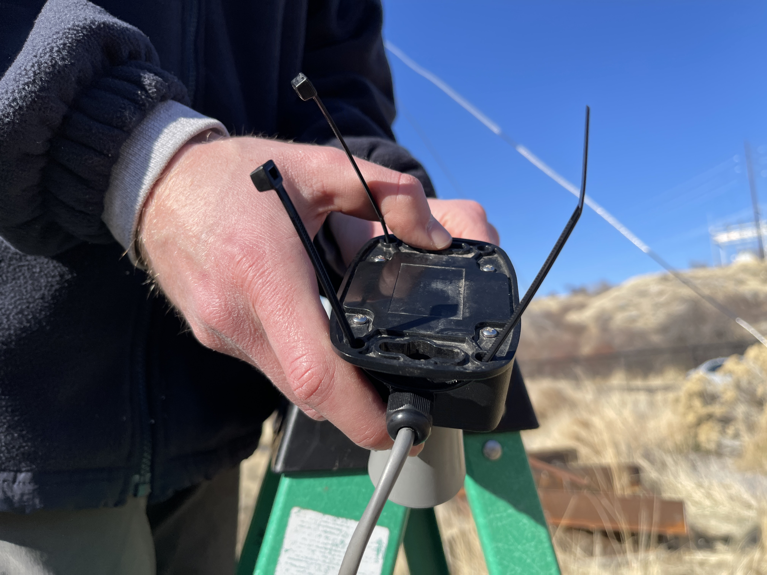
hardware/construction_images/IMG_9201.JPG
