CIROH-Snow/snow_sensing/hardware/construction_images/IMG_9203.JPG

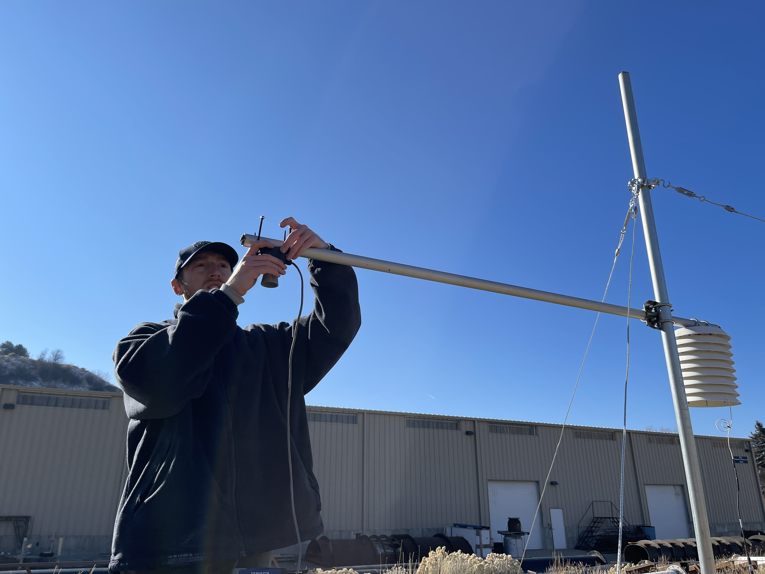
hardware/construction_images/IMG_9203.JPG
