CIROH-Snow/snow_sensing/hardware/construction_images/IMG_9206.JPG

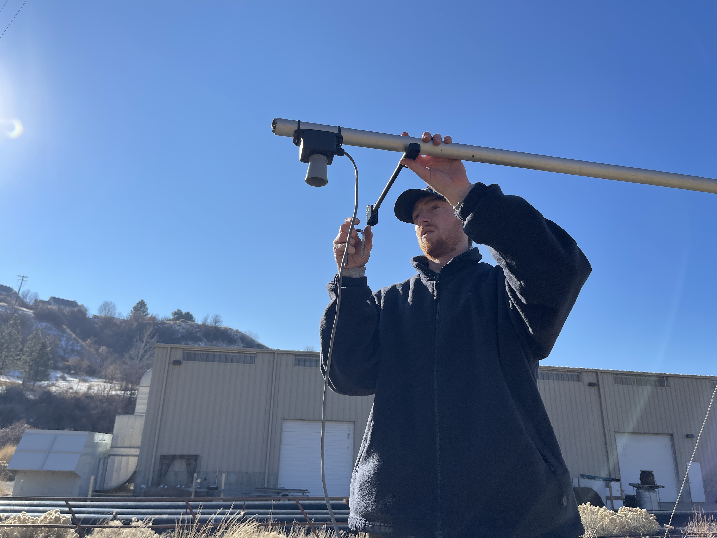
hardware/construction_images/IMG_9206.JPG
