CIROH-Snow/snow_sensing/hardware/construction_images/IMG_9207.JPG

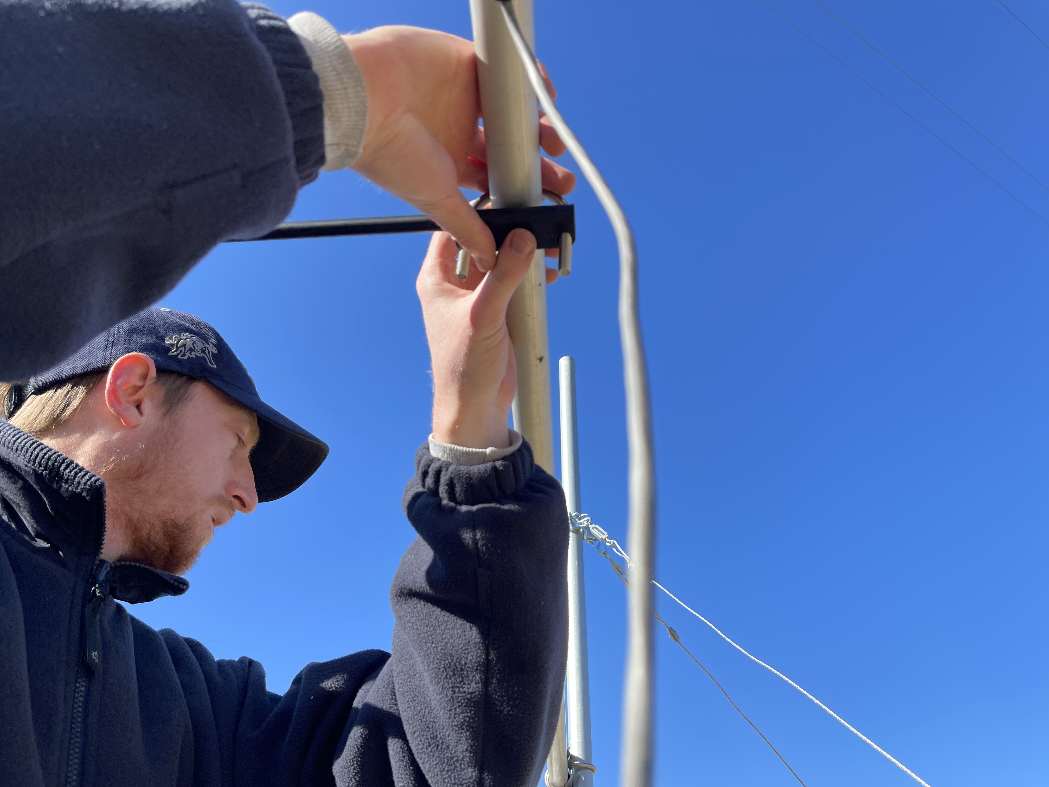
hardware/construction_images/IMG_9207.JPG
