CIROH-Snow/snow_sensing/hardware/construction_images/IMG_9208.JPG

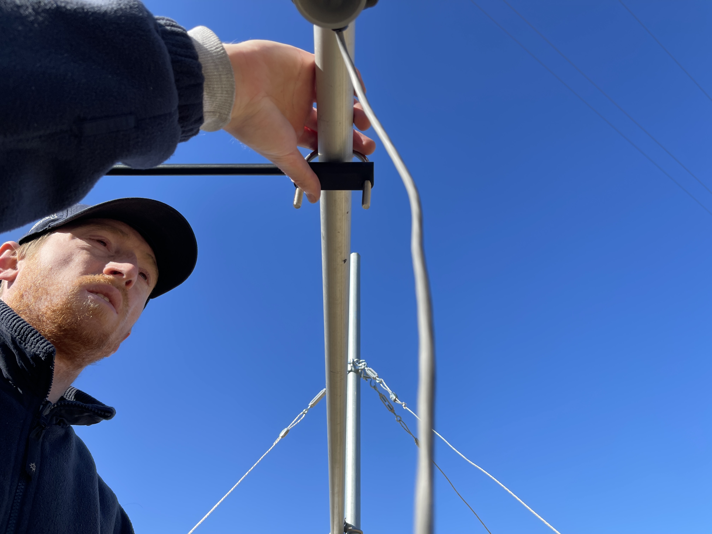
hardware/construction_images/IMG_9208.JPG
