CIROH-Snow/snow_sensing/hardware/construction_images/IMG_9209.JPG

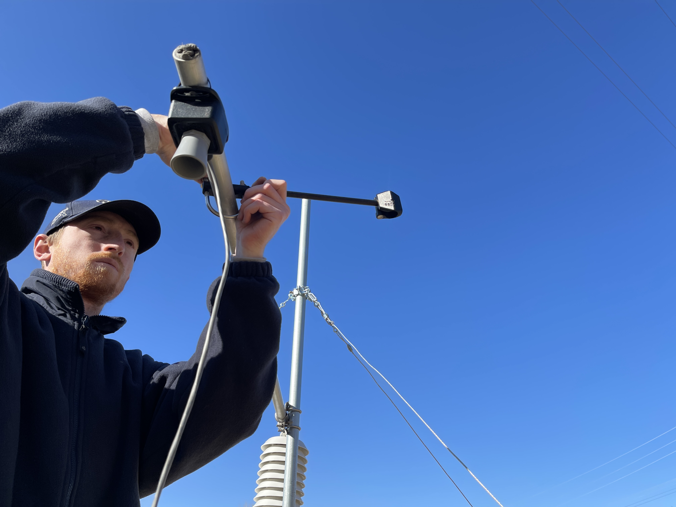
hardware/construction_images/IMG_9209.JPG
