CIROH-Snow/snow_sensing/hardware/construction_images/IMG_9211.JPG

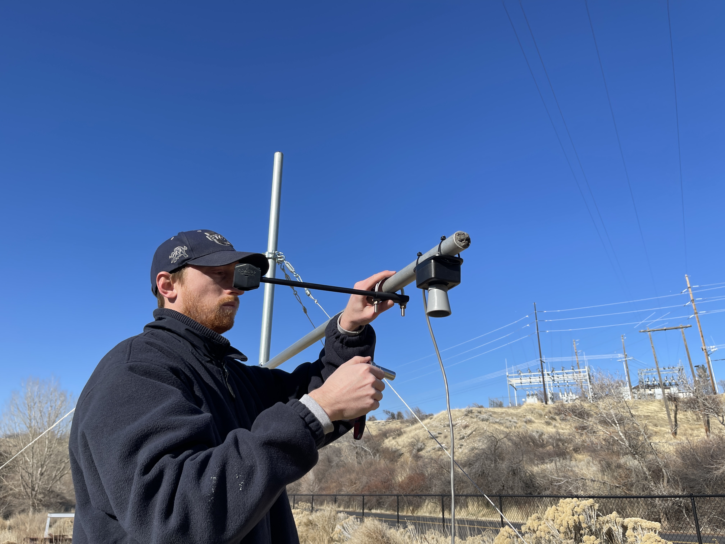
hardware/construction_images/IMG_9211.JPG
