CIROH-Snow/snow_sensing/hardware/construction_images/IMG_9215.JPG

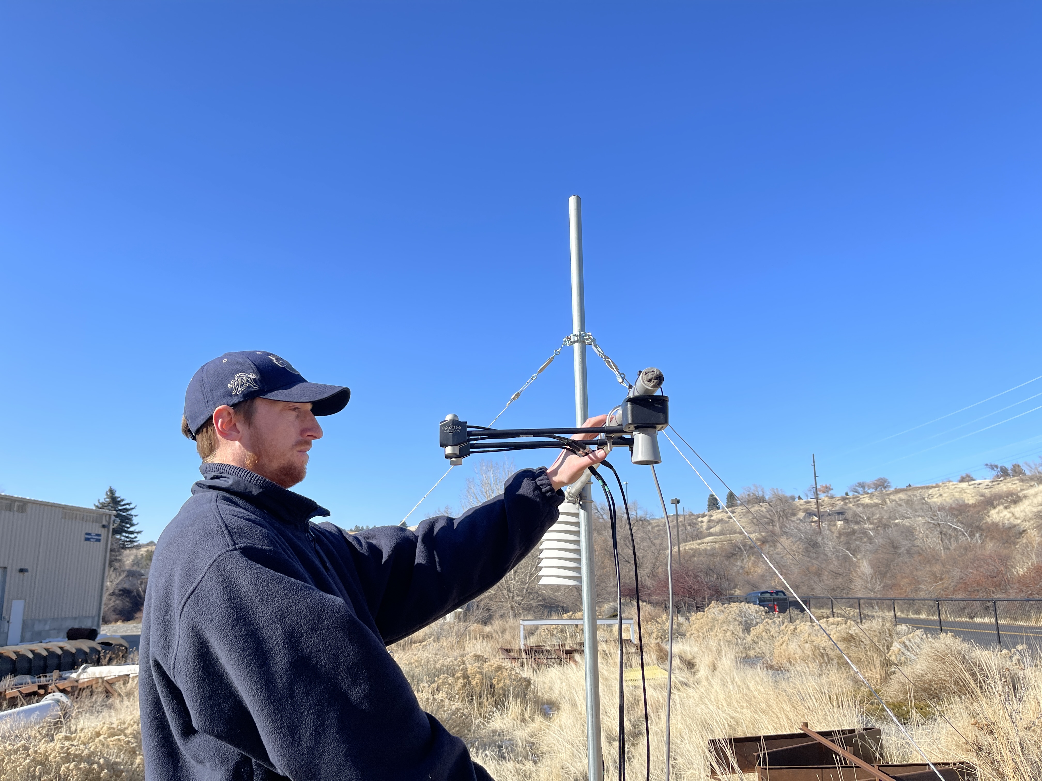
hardware/construction_images/IMG_9215.JPG
