CIROH-Snow/snow_sensing/hardware/construction_images/IMG_9222.JPG

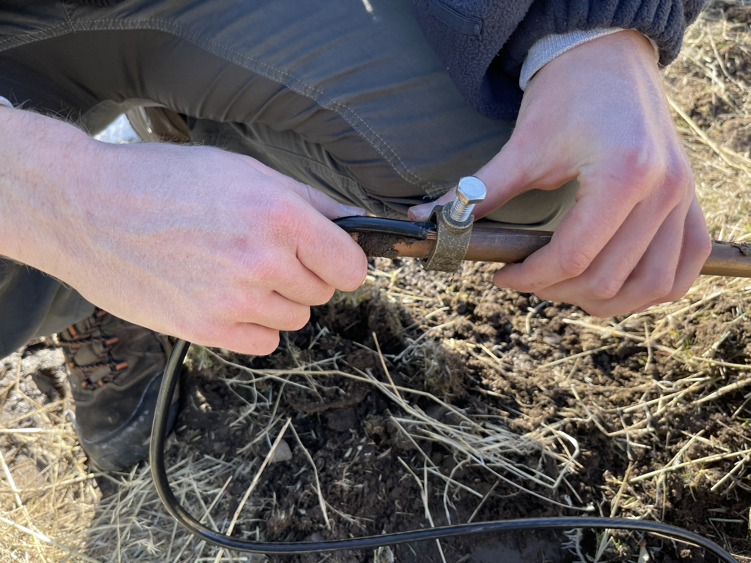
hardware/construction_images/IMG_9222.JPG
