CIROH-Snow/snow_sensing/hardware/construction_images/IMG_9223.JPG

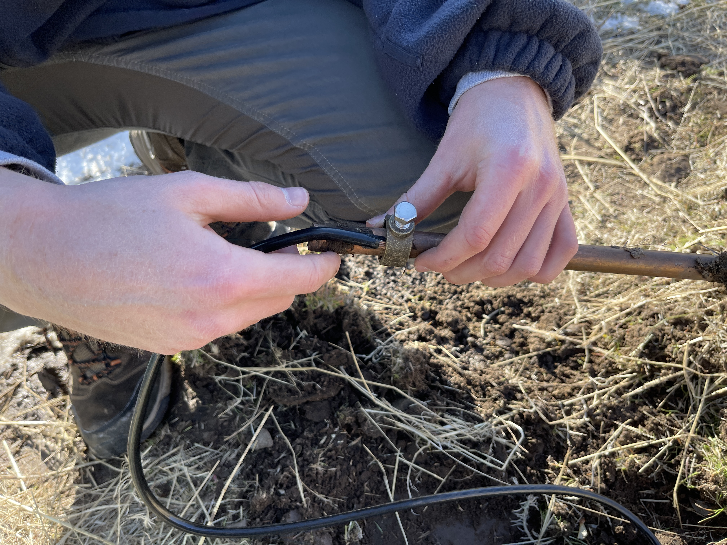
hardware/construction_images/IMG_9223.JPG
