CIROH-Snow/snow_sensing/hardware/construction_images/IMG_9224.JPG

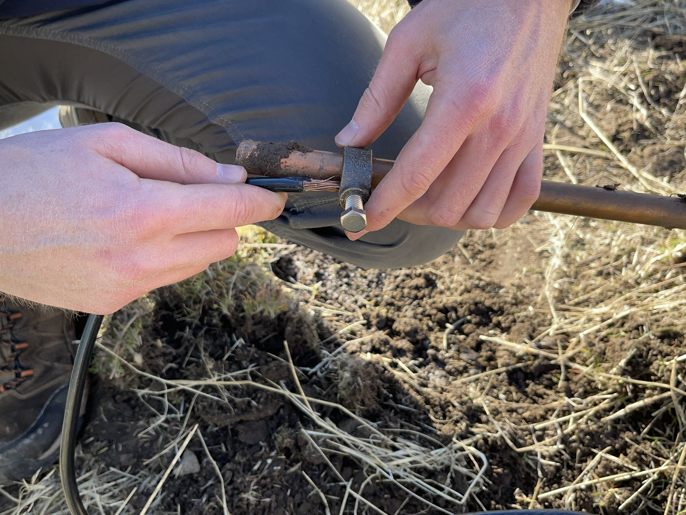
hardware/construction_images/IMG_9224.JPG
