CIROH-Snow/snow_sensing/hardware/construction_images/IMG_9226.JPG

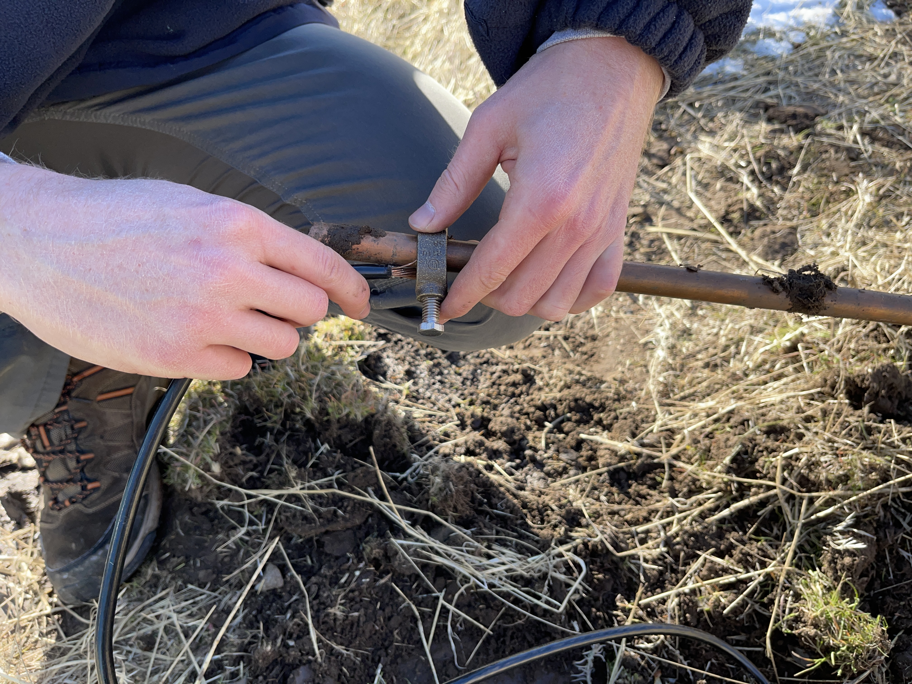
hardware/construction_images/IMG_9226.JPG
