CIROH-Snow/snow_sensing/hardware/construction_images/IMG_9237.JPG

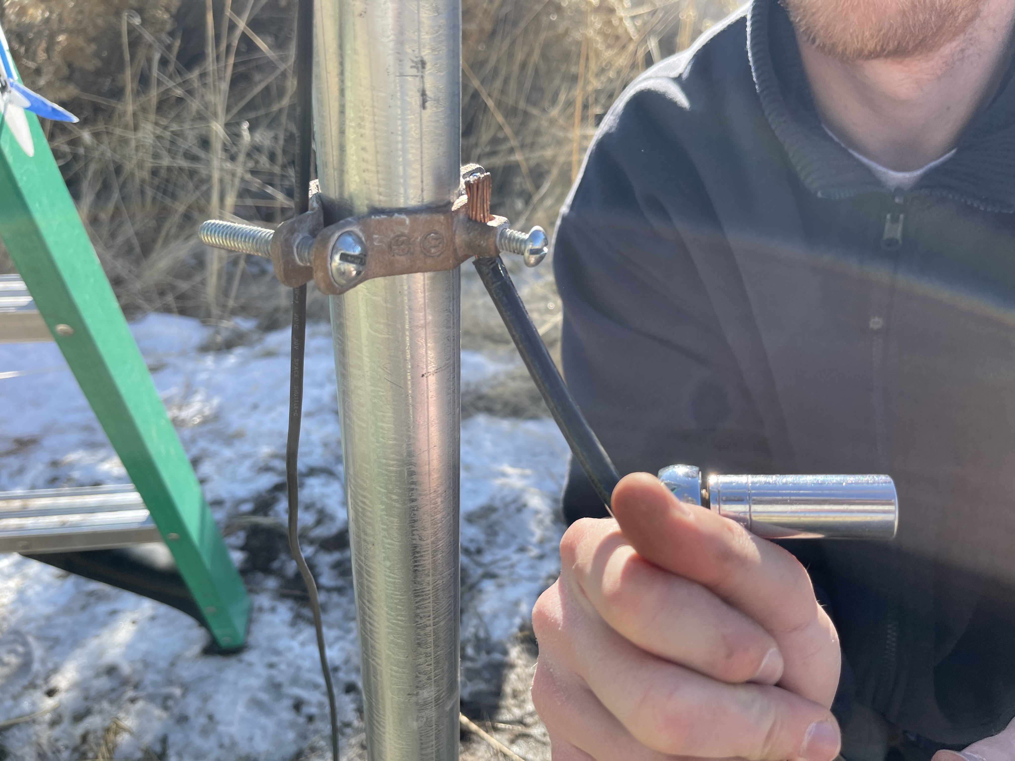
hardware/construction_images/IMG_9237.JPG
