CIROH-Snow/snow_sensing/hardware/construction_images/IMG_9243.JPG

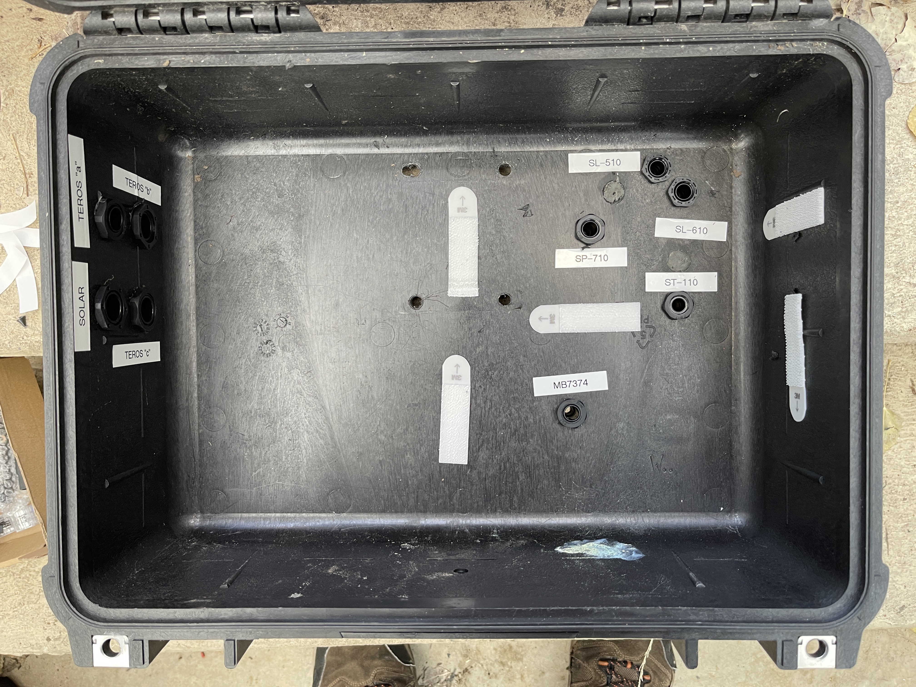
hardware/construction_images/IMG_9243.JPG
