CIROH-Snow/snow_sensing/hardware/construction_images/IMG_9244.JPG

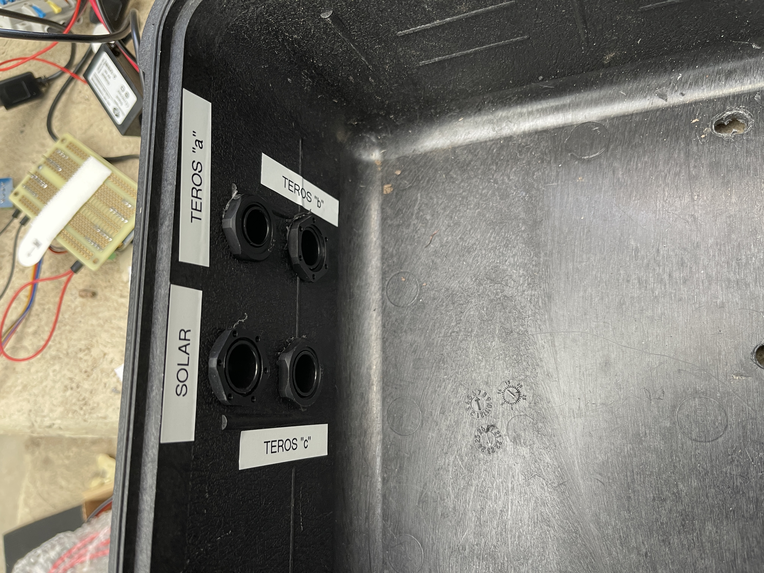
hardware/construction_images/IMG_9244.JPG
