CIROH-Snow/snow_sensing/hardware/construction_images/IMG_9245.JPG

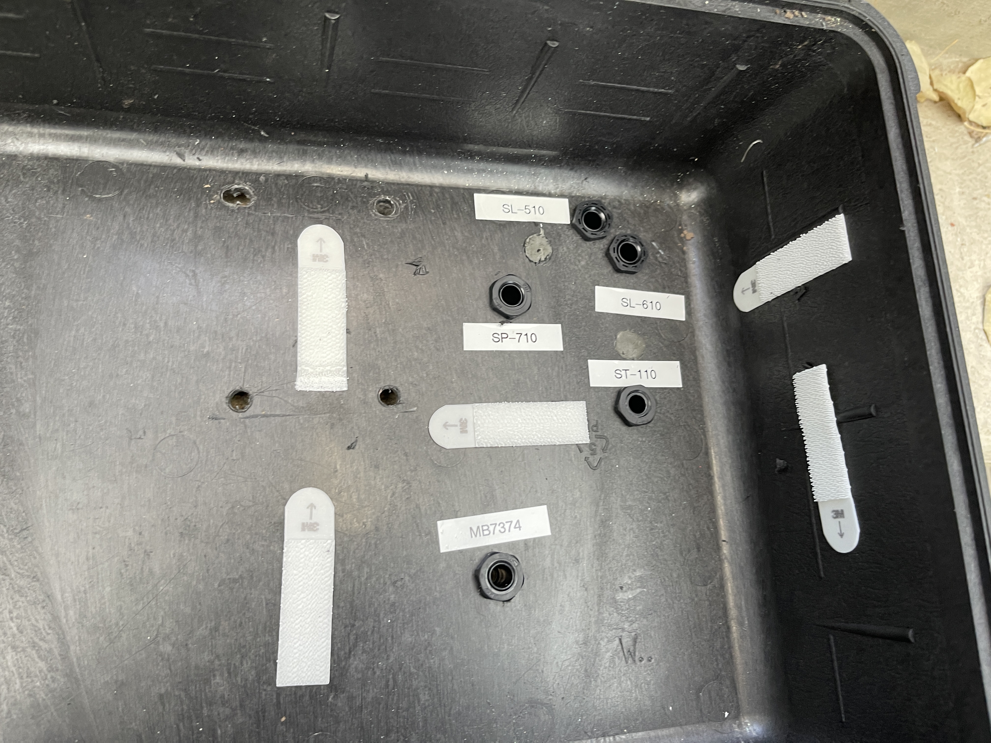
hardware/construction_images/IMG_9245.JPG
