CIROH-Snow/snow_sensing/hardware/construction_images/IMG_9246.JPG

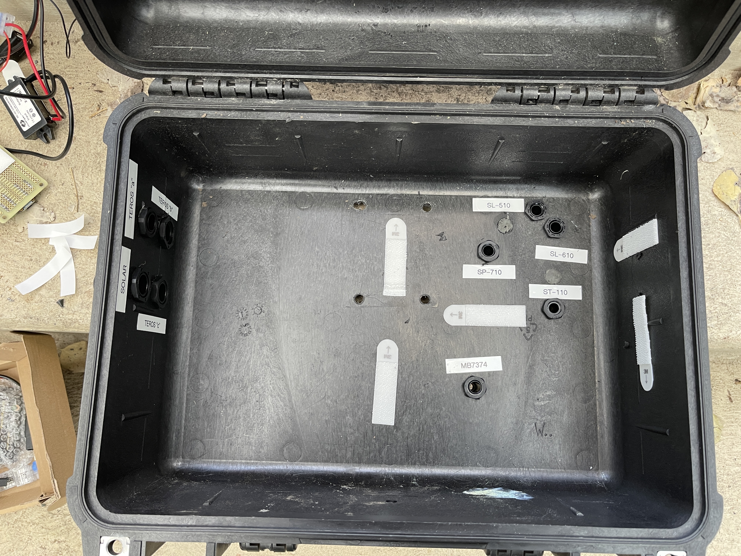
hardware/construction_images/IMG_9246.JPG
