CIROH-Snow/snow_sensing/hardware/construction_images/IMG_9247.JPG

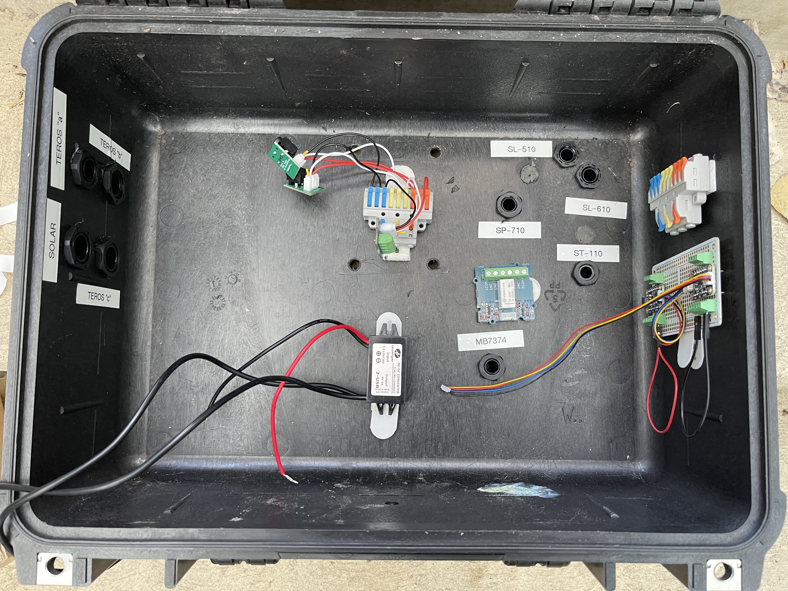
hardware/construction_images/IMG_9247.JPG
