CIROH-Snow/snow_sensing/hardware/construction_images/IMG_9248.JPG

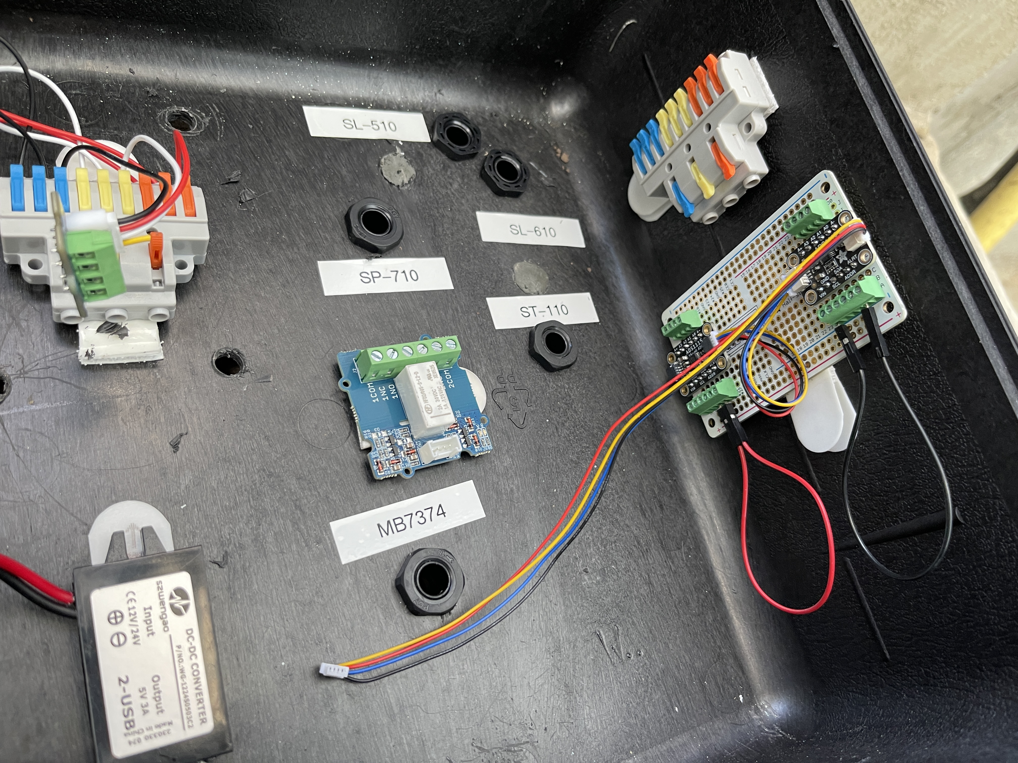
hardware/construction_images/IMG_9248.JPG
