CIROH-Snow/snow_sensing/hardware/construction_images/IMG_9253.JPG

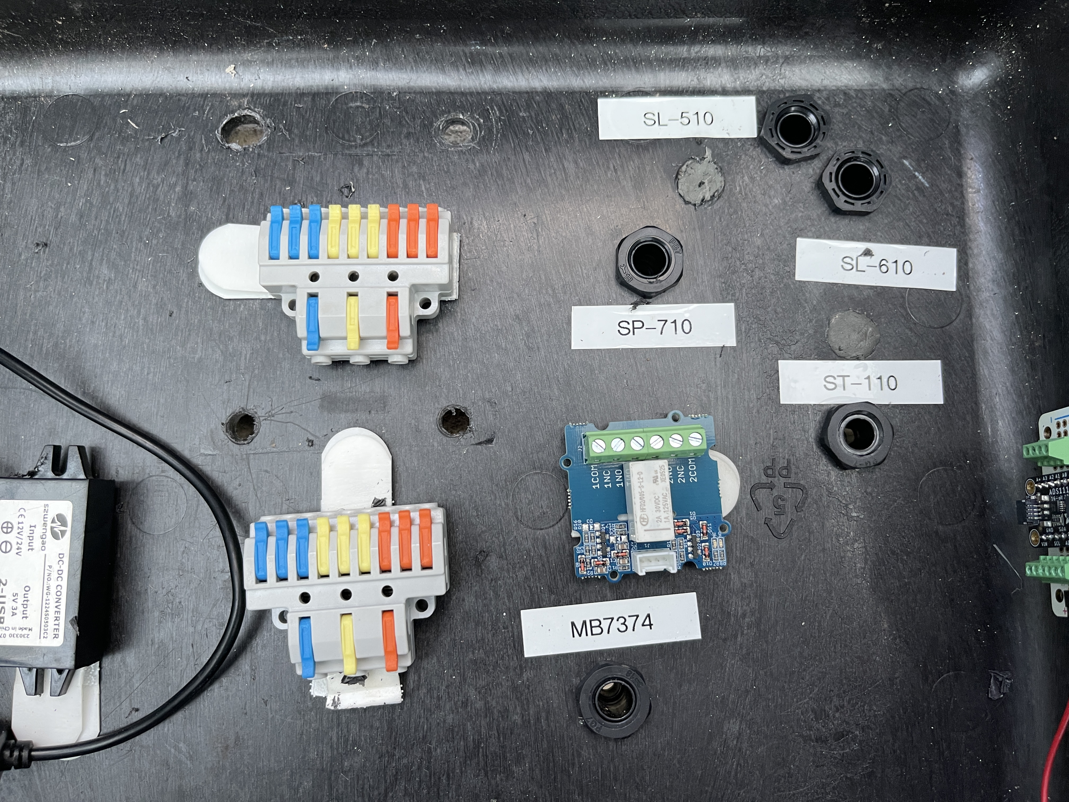
hardware/construction_images/IMG_9253.JPG
