CIROH-Snow/snow_sensing/hardware/construction_images/IMG_9254.JPG

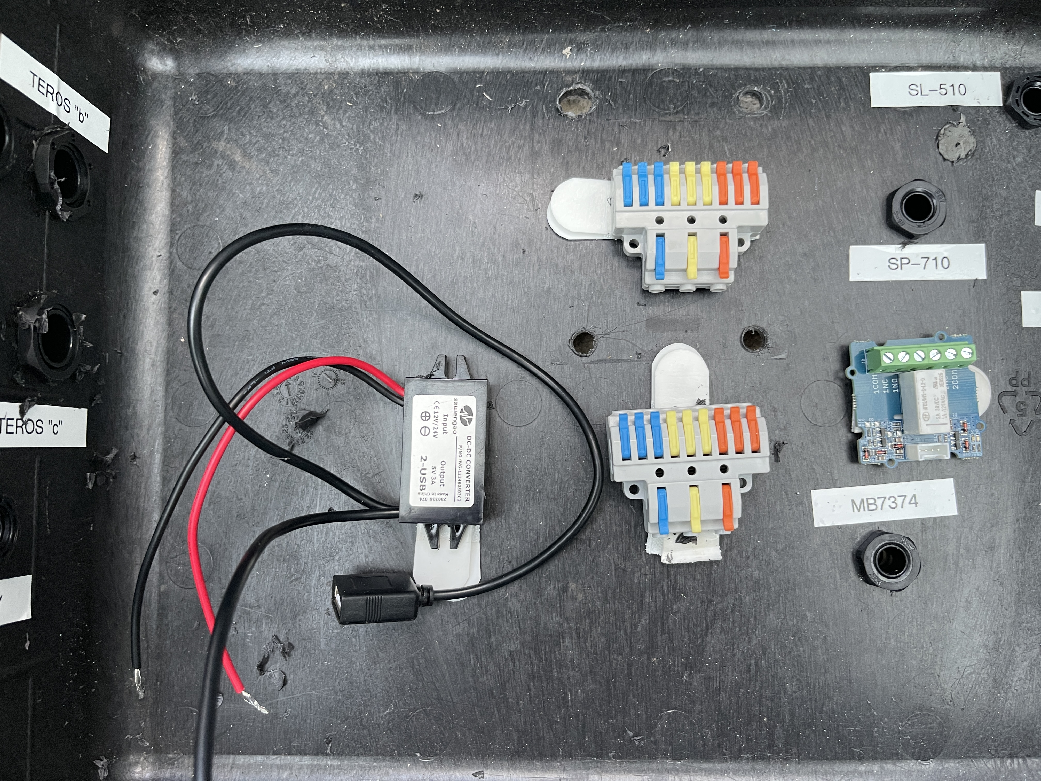
hardware/construction_images/IMG_9254.JPG
