CIROH-Snow/snow_sensing/hardware/construction_images/IMG_9255.JPG

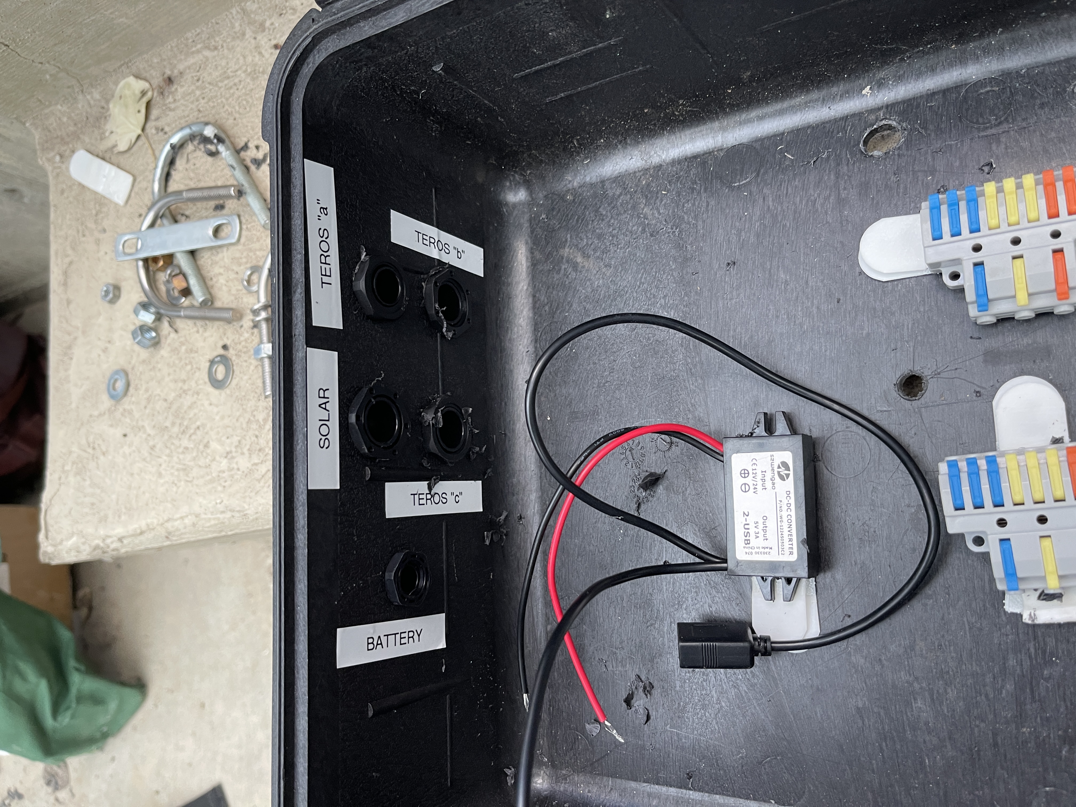
hardware/construction_images/IMG_9255.JPG
