CIROH-Snow/snow_sensing/hardware/construction_images/IMG_9257.JPG

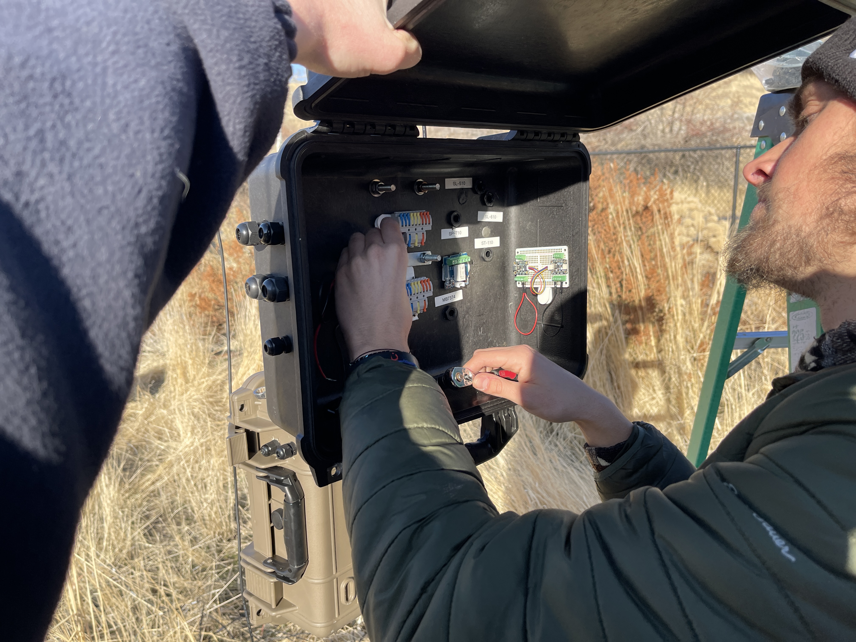
hardware/construction_images/IMG_9257.JPG
