CIROH-Snow/snow_sensing/hardware/wiring_images/IMG_9269.JPG

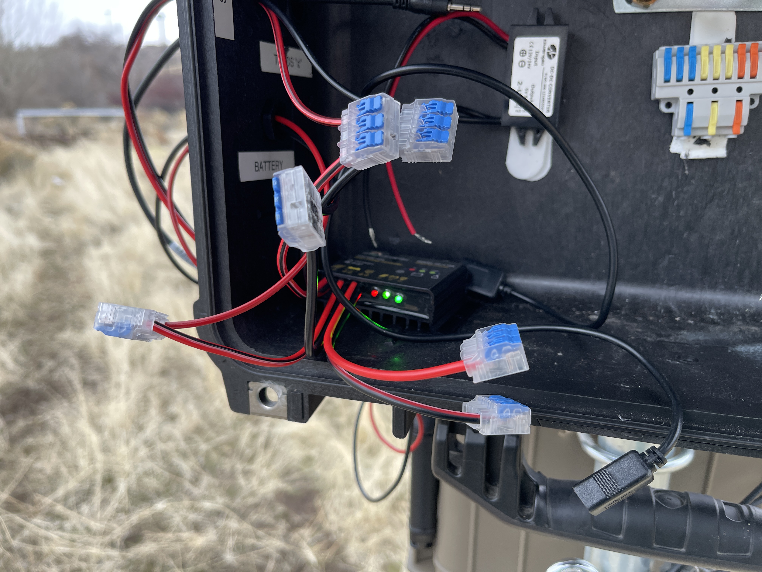
hardware/wiring_images/IMG_9269.JPG
