CIROH-Snow/snow_sensing/hardware/wiring_images/IMG_9270.JPG

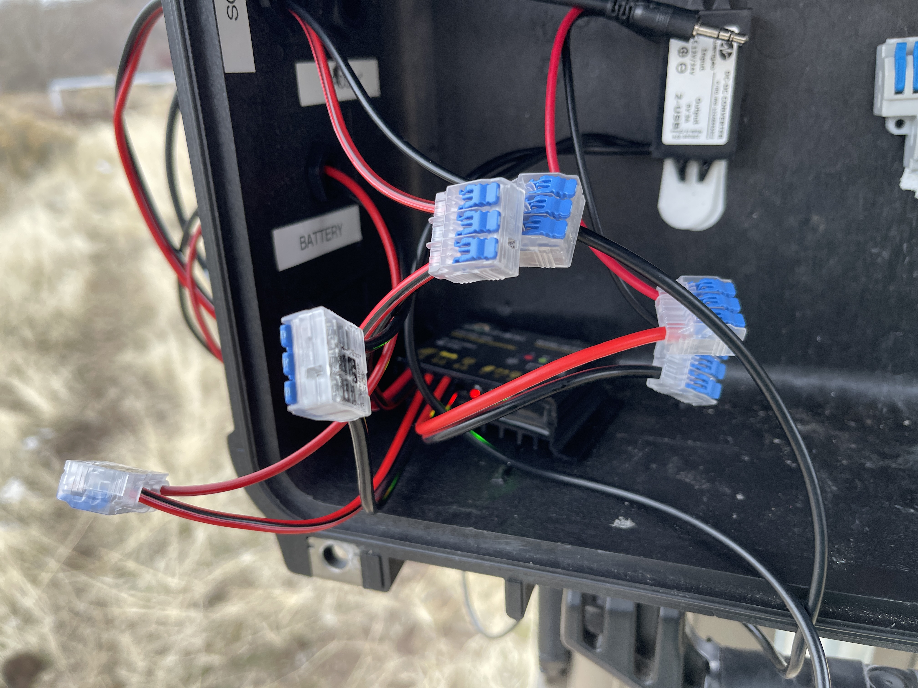
hardware/wiring_images/IMG_9270.JPG
