CIROH-Snow/snow_sensing/hardware/wiring_images/IMG_9273.JPG

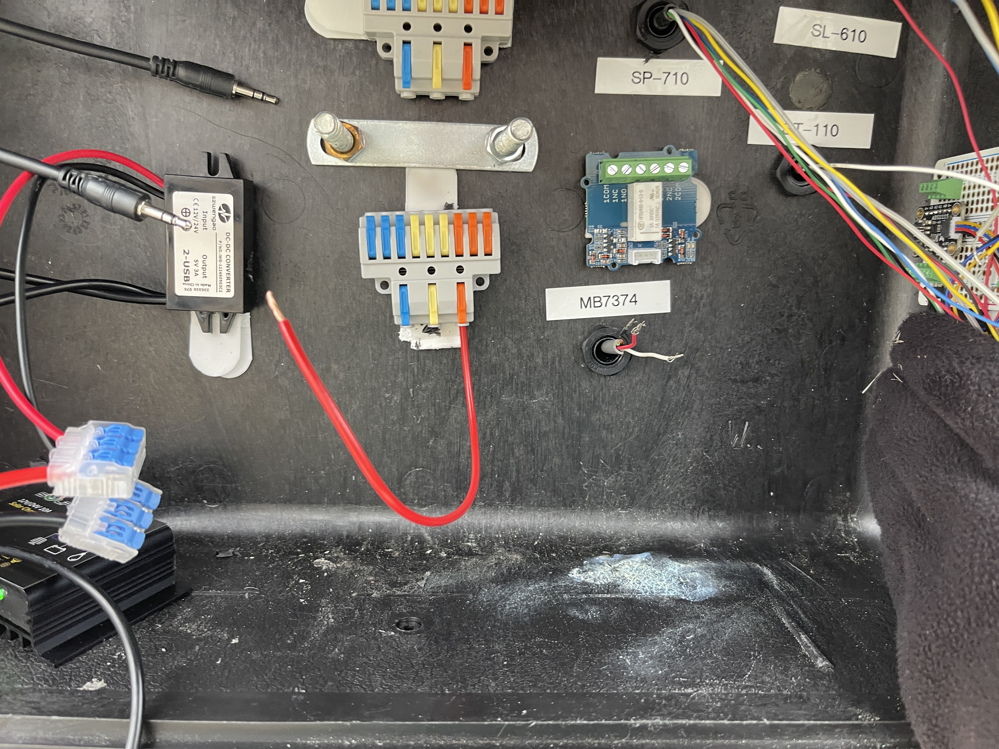
hardware/wiring_images/IMG_9273.JPG
