CIROH-Snow/snow_sensing/hardware/wiring_images/IMG_9276.JPG

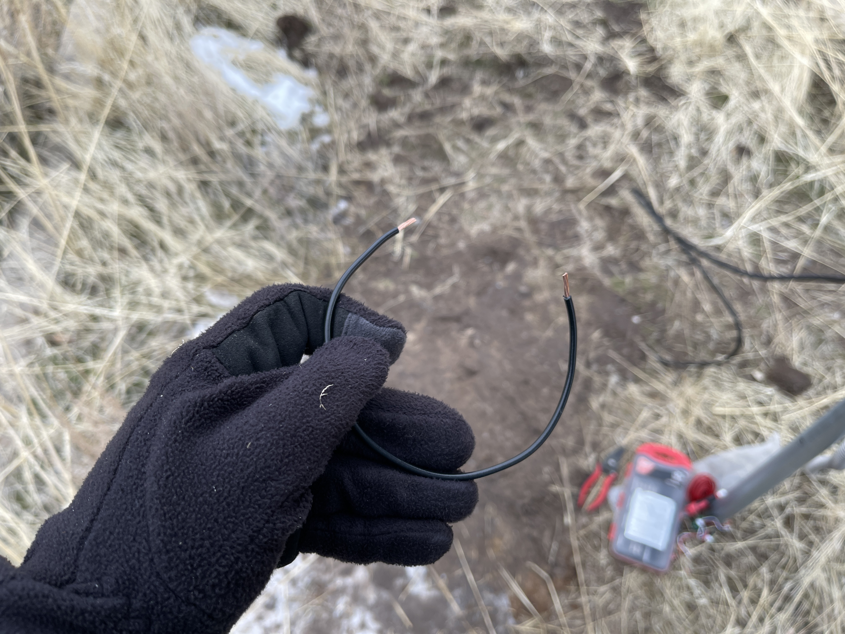
hardware/wiring_images/IMG_9276.JPG
