CIROH-Snow/snow_sensing/hardware/wiring_images/IMG_9356.JPG

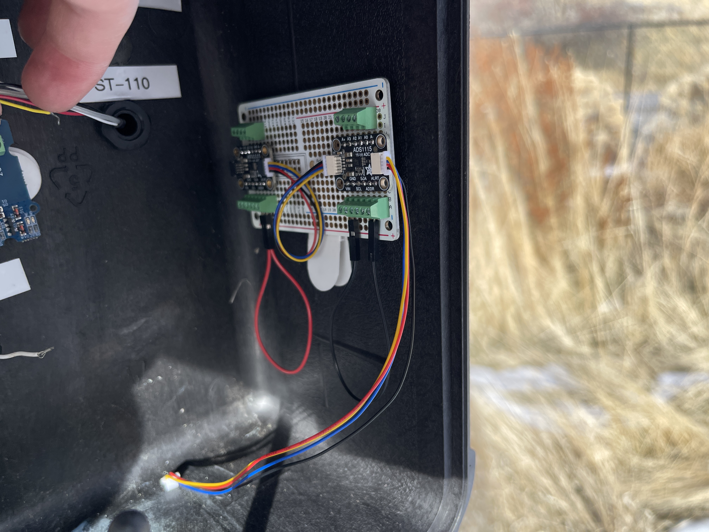
hardware/wiring_images/IMG_9356.JPG
