CIROH-Snow/snow_sensing/hardware/wiring_images/IMG_9357.JPG

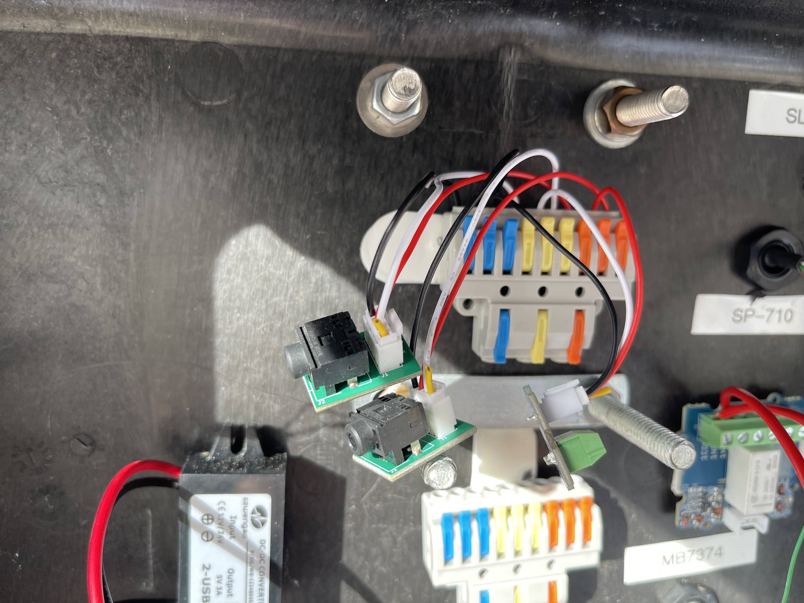
hardware/wiring_images/IMG_9357.JPG
