CIROH-Snow/snow_sensing/hardware/wiring_images/IMG_9376.JPG

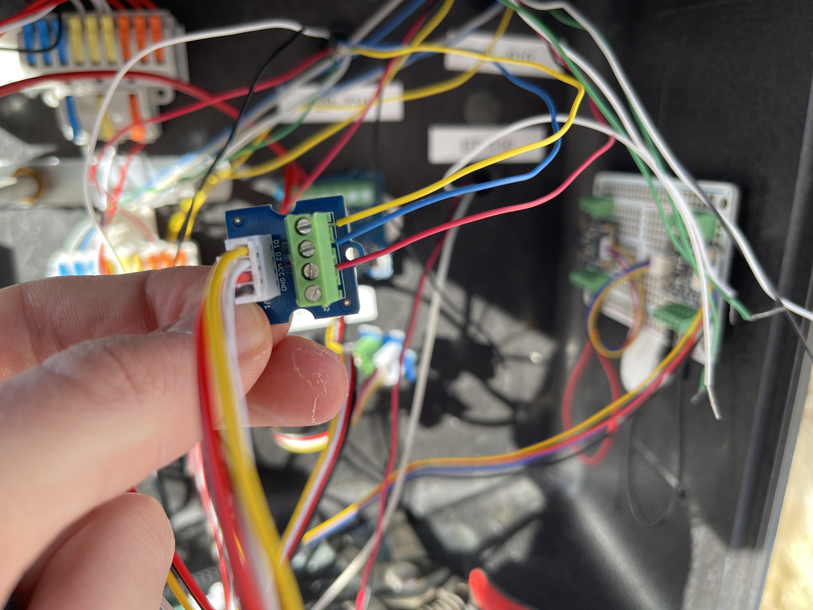
hardware/wiring_images/IMG_9376.JPG
