CIROH-Snow/snow_sensing/hardware/wiring_images/wiring1.jpg

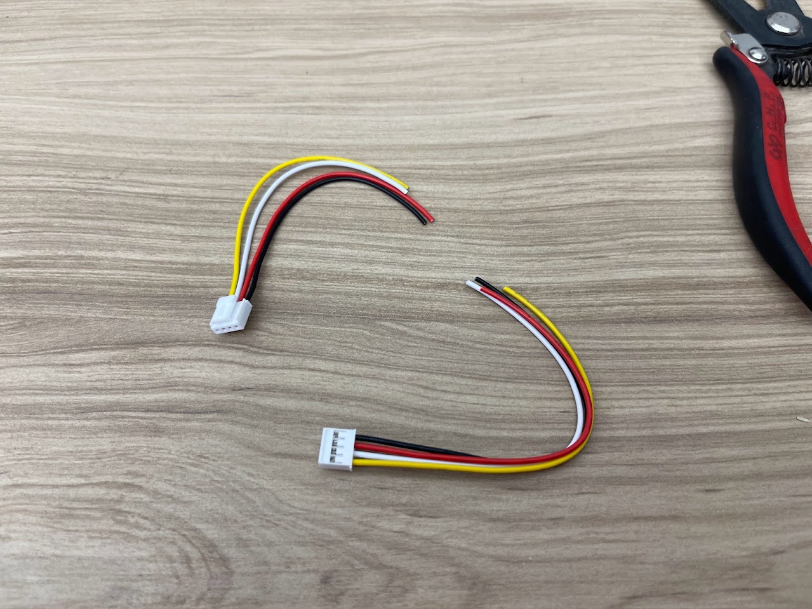
hardware/wiring_images/wiring1.jpg
