CIROH-Snow/snow_sensing/hardware/wiring_images/wiring2.jpg

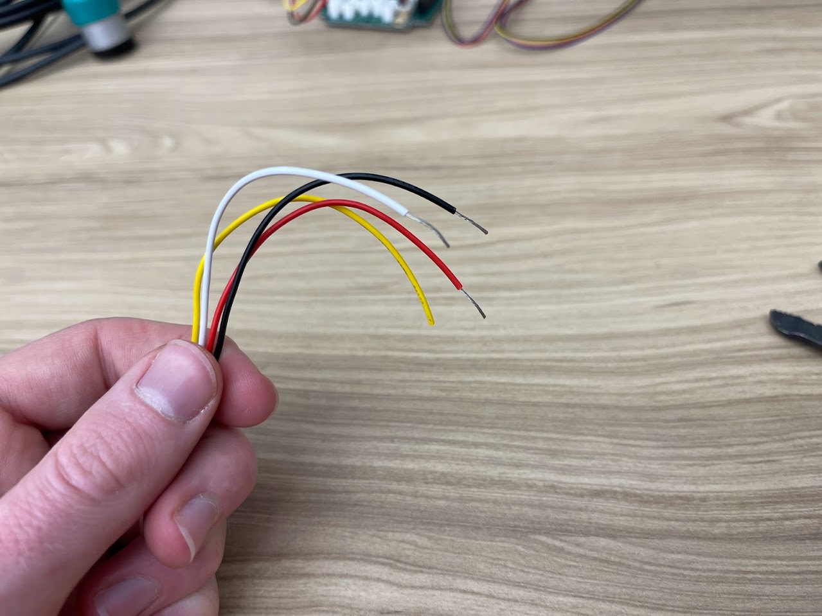
hardware/wiring_images/wiring2.jpg
