CIROH-Snow/snow_sensing/hardware/wiring_images/wiring3.jpg

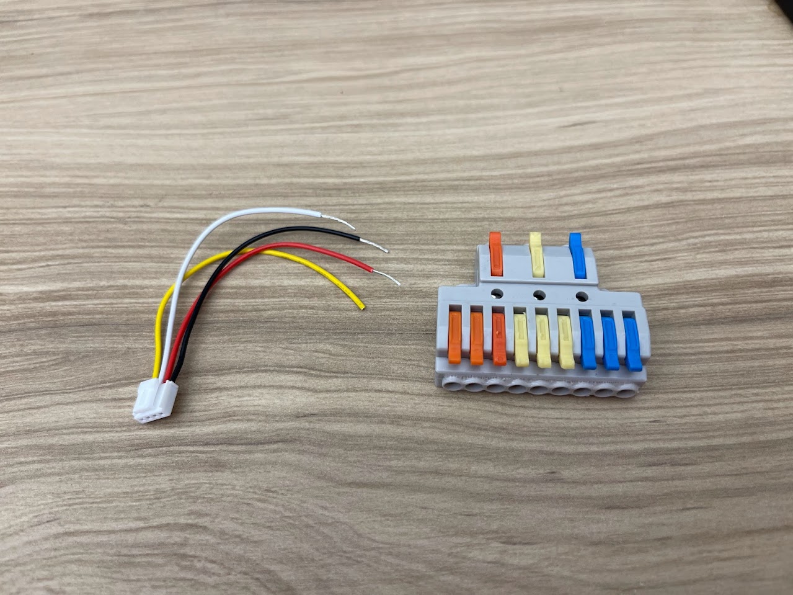
hardware/wiring_images/wiring3.jpg
