CIROH-Snow/snow_sensing/hardware/wiring_images/wiring4.jpg

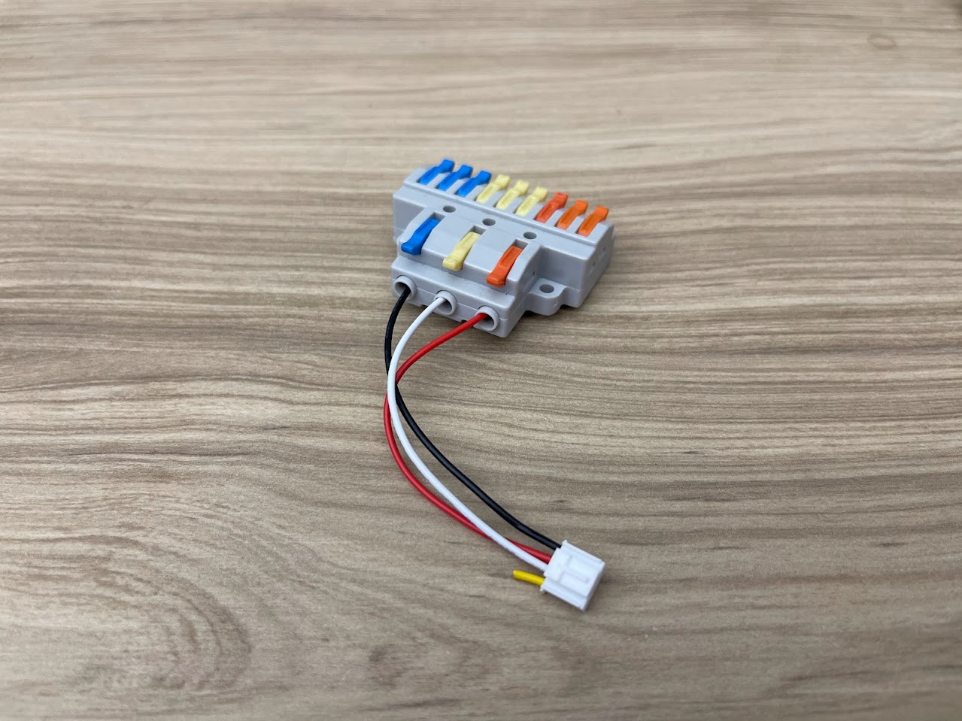
hardware/wiring_images/wiring4.jpg
