CIROH-Snow/snow_sensing/hardware/wiring_images/wiring5.jpg

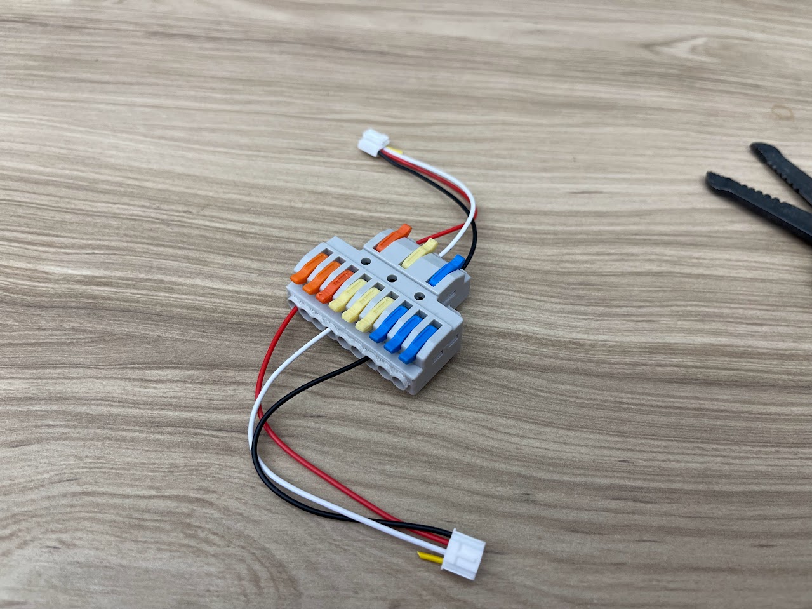
hardware/wiring_images/wiring5.jpg
