CIROH-Snow/snow_sensing/hardware/wiring_images/wiring6.jpg

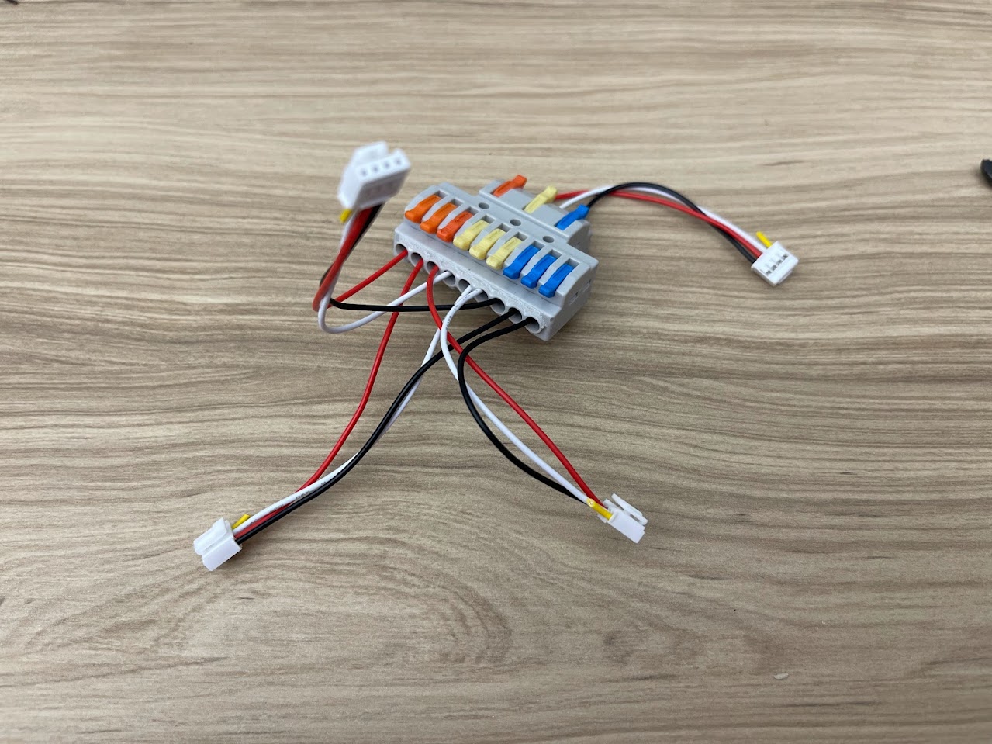
hardware/wiring_images/wiring6.jpg
