CIROH-Snow/snow_sensing/hardware/wiring_images/wiring9.jpg

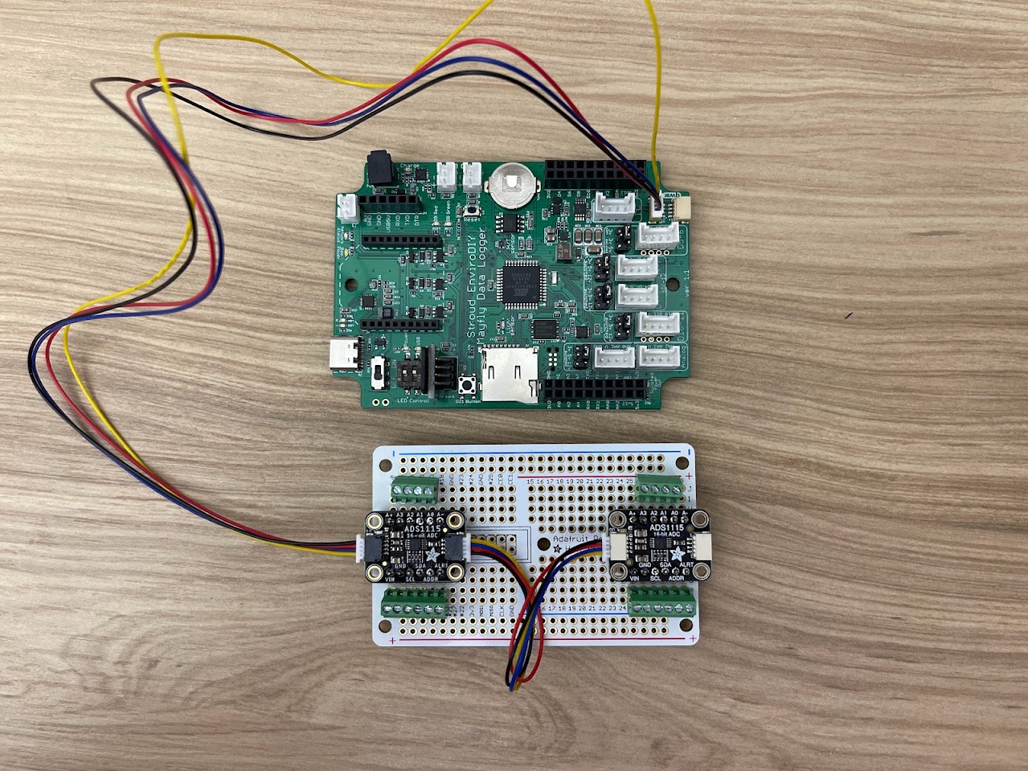
hardware/wiring_images/wiring9.jpg
