CIROH-Snow/snow_sensing/hardware/wiring_images/wiring10.jpg

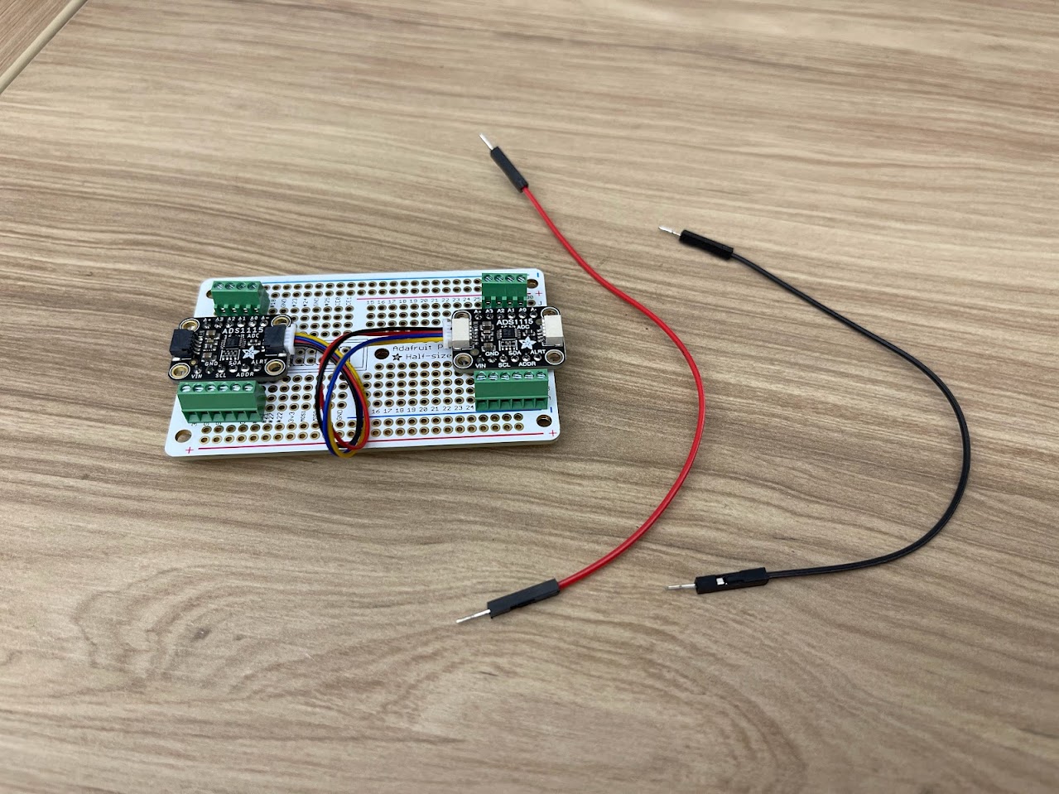
hardware/wiring_images/wiring10.jpg
