CIROH-Snow/snow_sensing/hardware/wiring_images/wiring.jpg

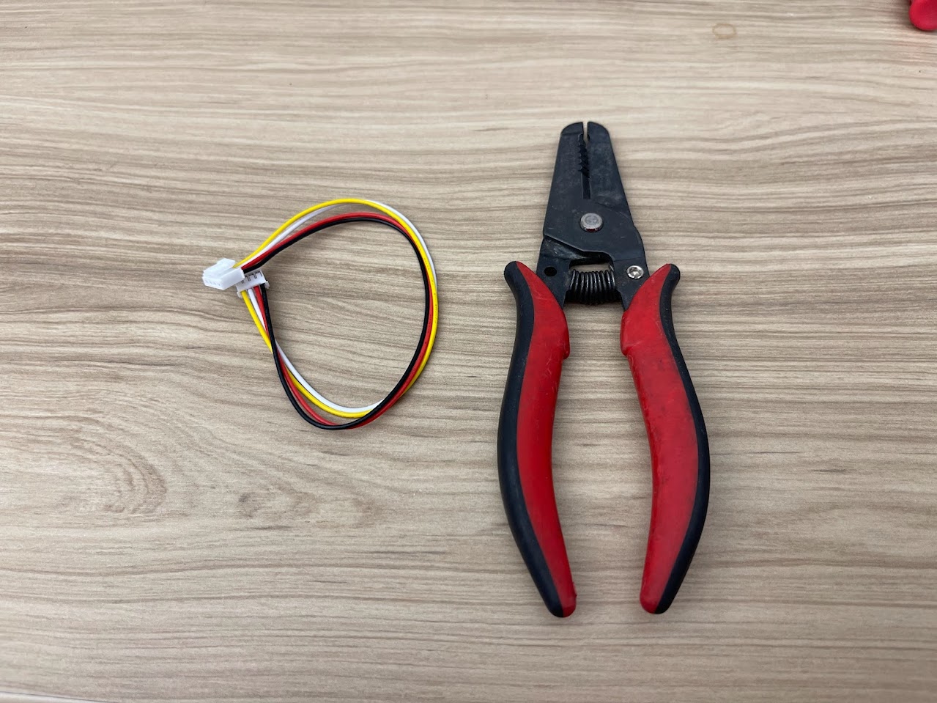
hardware/wiring_images/wiring.jpg
