CIROH-Snow/snow_sensing/code/arduino_libraries/YosemitechModbus/extras/calibrator_spreadsheets/Y511-Turbidity-Calibrator.xlsx

Y511 Turbidity Calibrator
v0.2.1: 2020-09-10 |  |  |  |  |  |  | Calibration Standards: Known Values
Anthony Aufdenkampe <aaufdenkampe@limno.com> |  |  | Reference Standards |  | µS/cm |  |  | NTU |  | NTU |  | NTU |  | NTU
 |  |  |  | Not used in calibration |  |  | Calibration Standards: Measured Values (with default K=1 & B=0)
Instructions |  |  |  | NTU | °C |  | NTU | °C | NTU | °C | NTU | °C | NTU | °C
Calibration Date:
1. GET & paste sensor info from Modbus Runner software.
SN:
Version:
Probe: | User Coefficients (previous)
K: |  | (slope)
B: |  | (intercept)
2. Re-SET "User Coefficients" to defaults.
K: | 1.000000
B: | 0.000000 |  | Average | #DIV/0! | #DIV/0! |  | #DIV/0! | #DIV/0! | #DIV/0! | #DIV/0! | #DIV/0! | #DIV/0! | #DIV/0! | #DIV/0!
 |  |  | Std | #DIV/0! | #DIV/0! |  | #DIV/0! | #DIV/0! | #DIV/0! | #DIV/0! | #DIV/0! | #DIV/0! | #DIV/0! | #DIV/0!
3. Fill in reference standard known values. |  |  | %CV | #DIV/0! | #DIV/0! |  | #DIV/0! | #DIV/0! | #DIV/0! | #DIV/0! | #DIV/0! | #DIV/0! | #DIV/0! | #DIV/0!
Type into pale yellow cells G3, J3, M3, P3
4."GET Turb" & paste measured values for each standard. |  |  |  | Calibration Curve
Measure 3-10 "Times" to get best values. |  |  |  | X | Y |  |  |  |  |  |  |  |  |  | X | Y
Paste into pale yellow cells. |  |  |  | Measured | Reference |  | predicted Y | residual Y | calibrated X |  |  |  |  |  | Measured | Reference
 |  |  |  | #DIV/0! | 0.00 |  |  | #VALUE! | #DIV/0! |  |  |  |  |  | #DIV/0! | 0.00
5. Delete calibration X:Y pairs that are not valid. |  |  |  | #DIV/0! | 0.00 |  |  | #VALUE! | #DIV/0! |  |  |  |  |  | #DIV/0! | 0.00
Delete green values in pale yellow cells D25:E28 |  |  |  | #DIV/0! | 0.00 |  |  | #VALUE! | #DIV/0! |  |  |  |  |  | #DIV/0! | 0.00
 |  |  |  | #DIV/0! | 0.00 |  |  | #VALUE! | #DIV/0! |  |  |  |  |  | #DIV/0! | 0.00
6. Re-SET "User Coefficients" to new calibration values.
Paste these blue values into Modbus Runner and hit "SET". |  |  |  |  |  |  |  |  |  |  |  |  |  |  | NOTE:
K: | #DIV/0! | slope |  | slope | #DIV/0! |  |  |  |  |  |  |  |  |  | Standard practice is for calibration curves to have the known reference values on the X-axis, because they are the "independent" variable.
B: | #DIV/0! | intercept in NTU or FTU |  | intercept | #DIV/0! | NTU or FTU |  |  |  |  |  |  |  |  | YosemiTech puts the measured values on the X-axis, despite it being the "independent variable".
 |  |  |  |  |  |  |  |  |  |  |  |  |  |  | Many other well-known sensor companies also follow this practice, even though it does not technically follow statistical best practice.
7. Save this sheet for your records.
Rename tab with serial number and date, or keep a workbook for each serial number.
