CIROH-Snow/snow_sensing/code/arduino_libraries/YosemitechModbus/extras/calibrator_spreadsheets/Y520-Conductivity-Calibrator.xlsx

Sheet: YL09-example
Y520 Conductivity Calibrator
v0.2.1: 2020-09-10 |  |  |  |  |  |  | Calibration Standards: Known Values
Anthony Aufdenkampe <aaufdenkampe@limno.com> |  |  | Reference Standards | Distilled water | µS/cm |  | 125 | µS/cm | 250 | µS/cm | 500 | µS/cm | 1000 | µS/cm
 |  |  |  | Not used in calibration |  |  | Calibration Standards: Measured Values (with default K=1 & B=0)
Instructions |  |  |  | mS/cm | °C |  | mS/cm | °C | mS/cm | °C | mS/cm | °C | mS/cm | °C
Calibration Date: | 2020-09-10 |  |  |  |  |  | 0.137397 | 23.14749 | 0.258345 | 23.32175 | 0.498859 | 22.73395 | 0.986937 | 22.75186
 |  |  |  |  |  |  | 0.136182 | 23.1618 | 0.258114 | 23.32831 | 0.499751 | 22.73651 | 0.986775 | 22.75439
1. GET & paste sensor info from Modbus Runner software. |  |  |  |  |  |  | 0.136934 | 23.17474 | 0.258244 | 23.33218 | 0.499751 | 22.73773 | 0.986775 | 22.75696
SN: | YL0918031414 |  |  |  |  |  | 0.136934 | 23.18512 | 0.258244 | 23.3374 | 0.499389 | 22.74033 | 0.986435 | 22.75696
Version: | hw 1.2,sw 1.8 |  |  |  |  |  | 0.136214 | 23.19421 | 0.257009 | 23.34134 | 0.496529 | 22.74545 | 0.986435 | 22.75824
Probe: | User Coefficients (previous) |  |  |  |  |  | 0.136214 | 23.20462 | 0.257431 | 23.34393 | 0.497669 | 22.74673 | 0.986123 | 22.76212
K: | 1.000000 | (slope) |  |  |  |  | 0.136672 | 23.21371 | 0.257431 | 23.34653 | 0.499716 | 22.74802 | 0.986123 | 22.7634
B: | -0.002100 | (intercept) |  |  |  |  | 0.136654 | 23.2215 | 0.25714 | 23.34787 | 0.4993 | 22.75058 | 0.986318 | 22.76465
2. Re-SET "User Coefficients" to defaults.
K: | 1.000000
B: | 0.000000 |  | Average | #DIV/0! | #DIV/0! |  | 0.136650 | 23.18790 | 0.257745 | 23.33741 | 0.498870 | 22.74241 | 0.986490 | 22.75857
 |  |  | Std | #DIV/0! | #DIV/0! |  | 0.000434 | 0.02566 | 0.000548 | 0.00930 | 0.001174 | 0.00608 | 0.000309 | 0.00448
3. Fill in reference standard known values. |  |  | %CV | #DIV/0! | #DIV/0! |  | 0.32% | 0.11% | 0.21% | 0.04% | 0.24% | 0.03% | 0.03% | 0.02%
Type into pale yellow cells G3, J3, M3, P3 |  |  | Converted units: | #DIV/0! | µS/cm |  | 136.65 | µS/cm | 257.74 | µS/cm | 498.87 | µS/cm | 986.49 | µS/cm
4."GET Cond" & paste measured values for each standard. |  |  |  | Calibration Curve
Measure 3-10 "Times" to get best values. |  |  |  | X | Y |  |  |  |  |  |  |  |  |  | X | Y
Paste into pale yellow cells. |  |  |  | Measured | Reference |  | predicted Y | residual Y | calibrated X |  |  |  |  |  | Measured | Reference
 |  |  |  | 136.65 | 125.00 |  | 125.60 | -0.60 | 125.60 |  |  |  |  |  | 136.65 | 125.00
5. Delete calibration X:Y pairs that are not valid. |  |  |  | 257.74 | 250.00 |  | 250.28 | -0.28 | 250.28 |  |  |  |  |  | 257.74 | 250.00
Delete green values in pale yellow cells D25:E28 |  |  |  | 498.87 | 500.00 |  | 498.54 | 1.46 | 498.54 |  |  |  |  |  | 498.87 | 500.00
 |  |  |  | 986.49 | 1000.00 |  | 1000.58 | -0.58 | 1000.58 |  |  |  |  |  | 986.49 | 1000.00
6. Re-SET "User Coefficients" to new calibration values.
Paste these blue values into Modbus Runner and hit "SET". |  |  |  |  |  |  |  |  |  |  |  |  |  |  | NOTE:
K: | 1.029586 | slope |  | slope | 1.029586 |  |  |  |  |  |  |  |  |  | Standard practice is for calibration curves to have the known reference values on the X-axis, because they are the "independent" variable.
B: | -0.015092 | intercept in mS/cm |  | intercept | -15.092275 | µS/cm |  |  |  |  |  |  |  |  | YosemiTech puts the measured values on the X-axis, despite it being the "independent variable".
 |  |  |  |  |  |  |  |  |  |  |  |  |  |  | Many other well-known sensor companies also follow this practice, even though it does not technically follow statistical best practice.
 |  |  |  | intercept | -0.015092 | mS/cm
7. Save this sheet for your records.
Rename tab with serial number and date, or keep a workbook for each serial number.

Sheet: YL09-blank
Y520 Conductivity Calibrator
v0.2.1: 2020-09-10 |  |  |  |  |  |  | Calibration Standards: Known Values
Anthony Aufdenkampe <aaufdenkampe@limno.com> |  |  | Reference Standards |  | µS/cm |  |  | µS/cm |  | µS/cm |  | µS/cm |  | µS/cm
 |  |  |  | Not used in calibration |  |  | Calibration Standards: Measured Values (with default K=1 & B=0)
Instructions |  |  |  | mS/cm | °C |  | mS/cm | °C | mS/cm | °C | mS/cm | °C | mS/cm | °C
Calibration Date:
1. GET & paste sensor info from Modbus Runner software.
SN:
Version:
Probe: | User Coefficients (previous)
K: |  | (slope)
B: |  | (intercept)
2. Re-SET "User Coefficients" to defaults.
K: | 1.000000
B: | 0.000000 |  | Average | #DIV/0! | #DIV/0! |  | #DIV/0! | #DIV/0! | #DIV/0! | #DIV/0! | #DIV/0! | #DIV/0! | #DIV/0! | #DIV/0!
 |  |  | Std | #DIV/0! | #DIV/0! |  | #DIV/0! | #DIV/0! | #DIV/0! | #DIV/0! | #DIV/0! | #DIV/0! | #DIV/0! | #DIV/0!
3. Fill in reference standard known values. |  |  | %CV | #DIV/0! | #DIV/0! |  | #DIV/0! | #DIV/0! | #DIV/0! | #DIV/0! | #DIV/0! | #DIV/0! | #DIV/0! | #DIV/0!
Type into pale yellow cells G3, J3, M3, P3 |  |  | Converted units: | #DIV/0! | µS/cm |  | #DIV/0! | µS/cm | #DIV/0! | µS/cm | #DIV/0! | µS/cm | #DIV/0! | µS/cm
4."GET Cond" & paste measured values for each standard. |  |  |  | Calibration Curve
Measure 3-10 "Times" to get best values. |  |  |  | X | Y |  |  |  |  |  |  |  |  |  | X | Y
Paste into pale yellow cells. |  |  |  | Measured | Reference |  | predicted Y | residual Y | calibrated X |  |  |  |  |  | Measured | Reference
 |  |  |  | #DIV/0! | 0.00 |  |  | #VALUE! | #DIV/0! |  |  |  |  |  | #DIV/0! | 0.00
5. Delete calibration X:Y pairs that are not valid. |  |  |  | #DIV/0! | 0.00 |  |  | #VALUE! | #DIV/0! |  |  |  |  |  | #DIV/0! | 0.00
Delete green values in pale yellow cells D25:E28 |  |  |  | #DIV/0! | 0.00 |  |  | #VALUE! | #DIV/0! |  |  |  |  |  | #DIV/0! | 0.00
 |  |  |  | #DIV/0! | 0.00 |  |  | #VALUE! | #DIV/0! |  |  |  |  |  | #DIV/0! | 0.00
6. Re-SET "User Coefficients" to new calibration values.
Paste these blue values into Modbus Runner and hit "SET". |  |  |  |  |  |  |  |  |  |  |  |  |  |  | NOTE:
K: | #DIV/0! | slope |  | slope | #DIV/0! |  |  |  |  |  |  |  |  |  | Standard practice is for calibration curves to have the known reference values on the X-axis, because they are the "independent" variable.
B: | #DIV/0! | intercept in mS/cm |  | intercept | #DIV/0! | µS/cm |  |  |  |  |  |  |  |  | YosemiTech puts the measured values on the X-axis, despite it being the "independent variable". Many other well-known sensor companies also follow this practice, even though it does not technically follow statistical best practice.
 |  |  |  | intercept | #DIV/0! | mS/cm
7. Save this sheet for your records.
Rename tab with serial number and date, or keep a workbook for each serial number.
