CIROH-Snow/snow_sensing/code/arduino_libraries/YosemitechModbus/extras/calibrator_spreadsheets/Y532-pH-Calibrator.xlsx

Y532 pH Calibrator
v0.2.1: 2020-09-10 |  |  |  |  |  |  | Calibration Standards: Known Values
Anthony Aufdenkampe <aaufdenkampe@limno.com> |  |  | Reference Standards | tap water | pH | at 25°C | 4.00 | pH | @ 25°C | 6.86 | pH | at 25°C | 9.18 | pH | at 25°C
 |  |  |  | Not used in calibration |  |  | Calibration Standards: Measured Values
Instructions |  |  |  | pH | E (mV) | T (°C) | pH | E (mV) | T (°C) | pH | E (mV) | T (°C) | pH | E (mV) | T (°C)
Calibration Date: | 2020-09-10 |  |  |  |  |  | 3.851003 | 280.7963 | 20.5838 | 6.500841 | 124.1004 | 20.6961 | 8.81648 | -11.54686 | 20.92318
 |  |  |  |  |  |  | 3.850221 | 280.8424 | 20.58349 | 6.542035 | 121.6635 | 20.69729 | 8.816212 | -11.53149 | 20.9241
1. GET & paste sensor info from Modbus Runner software. |  |  |  |  |  |  | 3.85114 | 280.7886 | 20.58438 | 6.565166 | 120.2951 | 20.69787 | 8.814243 | -11.41617 | 20.92349
SN: | YL4318052603 |  |  |  |  |  | 3.85063 | 280.8194 | 20.58529 | 6.580762 | 119.3726 | 20.70001 | 8.815689 | -11.50073 | 20.92349
Version: | hw 1.2,sw 2.0 |  |  |  |  |  | 3.850243 | 280.8424 | 20.5856 | 6.590508 | 118.796 | 20.70028 | 8.816342 | -11.53916 | 20.9241
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
