CIROH-Snow/snow_sensing/code/mayfly_datalogger/telemetry/lte_hydroserver/lte_hydroserver.ino

/** =========================================================================
 * Example: satellite_station.ino
 * Description: This is the Mayfly sketch for the deployment of a snow sensing
 *              station with telemetry of data to an instance of HydroServer.
 *
 * Author: Braedon Dority <braedon.dority@usu.edu>
 * Author: Jeff Horsburgh <jeff.horsburgh@usu.edu>
 * 
 * Copyright (c) 2017-2022 Utah Water Research Laboratory (UWRL)
 *            
 * License: This example is published under the BSD-3 license.
 *
 * Build Environment: Arduino IDE Version 1.8.19
 * Hardware Platform: EnviroDIY Mayfly Arduino Datalogger V1.1
 *
 * DISCLAIMER: THIS CODE IS PROVIDED "AS IS" - NO WARRANTY IS GIVEN.
 *
 * ACKNOWLEDGEMENTS:Thank you to the Stroud Water Research Center for 
 * developing the foundation to this code. This sketch is based on the 
 * examples made from their modular sensors library. The work of Sarah 
 * Damiano and Shannon Hicks made this possible.
 * 
 * NOTE ABOUT UUIDs IN THIS CODE: This example code uses a modified 
 * version of the EnviroDIY Modular Sensors library. We added a 
 * HydroServer publisher to the Modular Sensors library to enable this
 * sketch to automatically publish data collected by a snow sensing
 * station to be sent to an instance of HydroServer using HTTP POST 
 * requests. A playground version of HydroServer is available for 
 * development and testing at https://playground.hydroserver.org. 
 * HydroServer uses UUIDs to identify specific datastreams so that Mayfly 
 * dataloggers can send data directly to HydroServer using telemetry.  
 * Each observed variable uses a unique UUID that is assigned by HydroServer 
 * to identify its datastream (the time series of data for that variable).
 * To use this sketch, you need to create a monitoring site in HydroServer
 * and add a datastream to the monitoring site for each variable measured
 * by the snow sensing station. HydroServer will assign UUIDs for each 
 * observed variable datastream. You need to copy those UUIDs into this
 * sketch. This example sketch uses a placeholder UUID wherever a UUID from
 * HydroServer is required. You need to change those UUIDs to use the 
 * ones assigned by HydroServer for your datastreams.
 * ======================================================================= */

// ==========================================================================
// Defines for TinyGSM
// ==========================================================================
#ifndef TINY_GSM_RX_BUFFER
#define TINY_GSM_RX_BUFFER 64
#endif
#ifndef TINY_GSM_YIELD_MS
#define TINY_GSM_YIELD_MS 2
#endif


// ==========================================================================
// Include the libraries required for the data logger
// ==========================================================================
// The Arduino library is needed for every Arduino program.
#include <Arduino.h>

// EnableInterrupt is used by ModularSensors for external and pin change
// interrupts and must be explicitly included in the main program.
#include <EnableInterrupt.h>

// Include the main header for ModularSensors
#include <ModularSensors.h>

// This helps manage I2C functionality
#include <Wire.h>

// Hardware serial ports are limited or already designated for specific uses
// The MaxBotix sonar sensor requires serial communication to send data
// We can create a serial port on one of the digital pins using this software
#include <AltSoftSerial.h> 


// ==========================================================================
// Defines for the Arduino IDE
// ==========================================================================
// This pin will interface the Adafruit power relay for the Apogee sensors' heaters with the Mayfly
// Make sure your power relay's grove port is connected to the Mayfly's grove port that includes the
// digital pin defined here
#define powerRelayPin 10


// ==========================================================================
// Data Logging Options
// ==========================================================================
// The name of this program file
const char* sketchName = "lte_hydroserver.ino";

// Assign an ID for your data. This becomes the prefix for the name of the 
// data file on SD card. Normally use the name of the site at which the 
// datalogger is installed. Make sure it is a string (in double quotations).
const char* LoggerID = "UWRL";

// Set the frequency with which data will be logged (in minutes)
const uint8_t loggingInterval = 3;

// Set your datalogger's timezone as an integer offset from UTC time.
// NOTE:  Daylight savings time will not be applied!  Please use standard time! 
const int8_t timeZone = -7;  // Mountain Standard Time is -7

// Set the input and output pins for the logger
// NOTE:  Use -1 for pins that do not apply
// Baud rate for debugging (this is what you'll set your serial monitor's baud rate to)
const int32_t serialBaud = 57600;
// Pin for the green LED (don't change)
const int8_t  greenLED   = 8;
// Pin for the red LED (don't change)
const int8_t  redLED     = 9;
// Pin for debugging mode (ie, button pin, don't change)
const int8_t  buttonPin  = 21;
// MCU interrupt/alarm pin to wake from sleep (don't change)
const int8_t  wakePin    = 31;
// MCU SD card power pin (don't change)
const int8_t sdCardPwrPin   = -1;
// SD card chip select/slave select pin (don't change)
const int8_t sdCardSSPin    = 12; 
// MCU pin controlling main sensor power
const int8_t sensorPowerPin = 22;  
// Pin 22 is switched power, which can be 3.3V, 5V, or 12V depending on where 
// you connect your sensors on the board and if you adjust the jumper headers 
// (see wiring instructions in the GitHub repository in snow_sensing > hardware)


// ==========================================================================
// Wifi/Cellular Modem Options
// ==========================================================================
// For almost anything based on the SIMCom SIM7080G
#include <modems/SIMComSIM7080.h>

// Create a reference to the serial port for the modem
// Use hardware serial if possible
HardwareSerial& modemSerial = Serial1;
//  SIM7080 does auto-bauding by default, but for simplicity we set to 9600
const int32_t   modemBaud = 9600;  
                                   
// Modem Pins - Describe the physical pin connection of your modem to your board
// NOTE:  Use -1 for pins that do not apply
const int8_t modemVccPin = 18;
// MCU pin controlling modem power --- Pin 18 is the power enable pin for the
// bee socket on Mayfly v1.0, use -1 if using Mayfly 0.5b or if the bee socket
// is constantly powered (ie you changed SJ18 on Mayfly 1.x to 3.3v)
const int8_t modemStatusPin  = 19;  // MCU pin used to read modem status
const int8_t modemSleepRqPin = 23;  // MCU pin for modem sleep/wake request
const int8_t modemLEDPin = redLED;  // MCU pin connected an LED to show modem
                                    // status

// Network connection information
const char* apn =
    "hologram";  // APN connection name, typically Hologram unless you have a
                 // different provider's SIM card. Change as needed

// Create the modem object
SIMComSIM7080 modem7080(&modemSerial, modemVccPin, modemStatusPin,
                        modemSleepRqPin, apn);
// Create an extra reference to the modem by a generic name
SIMComSIM7080 modem = modem7080;


// ==========================================================================
// Using the Processor as a Sensor
// ==========================================================================
// Generally do not adjust this section unless you are not using version 1.1 
// of the Mayfly datalogger
#include <sensors/ProcessorStats.h>

// Create the main processor chip "sensor" - for general metadata
// If your Mayfly datalogger board is a different version, change this value
const char*    mcuBoardVersion = "v1.1";
ProcessorStats mcuBoard(mcuBoardVersion);


// ==========================================================================
// Maxim DS3231 RTC (Real Time Clock)
// ==========================================================================
// Do not change this section
#include <sensors/MaximDS3231.h>  // Includes wrapper functions for Maxim DS3231 RTC

// Create a DS3231 sensor object, using this constructor function:
MaximDS3231 ds3231(1);


// The next few sections contain the declarations for each sensor. Pay 
// attention to where edits need to be made. If there is a sensor you are not 
// using, you can simply delete the corresponding section, but make sure to 
// also delete its associated variables in the variable list found after these.


// ==========================================================================
// Battery voltage
// ==========================================================================
/*
 * This is for measuring battery voltage using the Adafruit ADS1115 16-bit
 * Analog-to-digital converters (ADCs). The ADCs can only read voltages 
 * within +/- 4.096 volts, so a voltage divider set up is needed. Please 
 * consult the wiring guide on the GitHub page before including this 
 * measurement; otherwise, it is best to remove it
*/
# include <Adafruit_ADS1015.h>

float calculateBatteryVoltage(void) {
  float res1 = 100;  // resistor value in kOhms that comes directly off the battery
  float res2 = 22;  // resistor value in kOhms that connects directly into ground
  uint8_t i2cAddress = 0x49;  // Hexidecimal address of ADC that is taking the measurement
  uint8_t posBatChannel = 3;  // Channel on ADC the battery is connected to
  float inputVar1 = -9999;
  float calculatedResult = -9999;
  Adafruit_ADS1115 ads(i2cAddress);
  ads.setGain(GAIN_ONE);
  ads.begin();
  inputVar1 = ads.readADC_SingleEnded_V(posBatChannel);
  if (inputVar1 < 4.096 && inputVar1 > 0) {
    calculatedResult = inputVar1 / (res2 / (res2 + res1));
  } else {
    inputVar1 = -9999;
  }
  return calculatedResult;
}

// Properties of the calculated battery voltage

// The number of digits after the decimal place
const uint8_t calculatedBatteryVoltageResolution = 2;
// Variable name (must be a value from http://vocabulary.odm2.org/variablename/)
const char* calculatedBatteryVoltageName = "BatteryVoltage";
// Variable units (must be a value from http://vocabulary.odm2.org/units/)
const char* calculatedBatteryVoltageUnit = "V";
// A short code for the variable
const char* calculatedBatteryVoltageCode = "MayflyBattVolt";
// The (optional) universallly unique identifier
const char* calculatedBatteryVoltageUUID = "12345678-abcd-1234-ef00-1234567890ab";

Variable* calculatedBatteryVoltage = new Variable(
    calculateBatteryVoltage, calculatedBatteryVoltageResolution, calculatedBatteryVoltageName,
    calculatedBatteryVoltageUnit, calculatedBatteryVoltageCode, calculatedBatteryVoltageUUID);


// ==========================================================================
// MaxBotix sonar sensor for snow depth
// ==========================================================================
#include <sensors/MaxBotixSonar.h>

// Tell the Mayfly what pin will have our homemade serial port on it
// We don't need to talk to the sensor, it just needs to talk to us through 
// a receiving pin [Rx] on the board, pin 6.
// The -1 indicates that no Tx wire is attached.
AltSoftSerial sonarSerial(6, -1);  

// Set the height of the sensor (in millimeters)
const int32_t sonarHeight = 2379;

// Set the slope angle in degrees
const double slopeAngleDeg = 0;
double slopeAngleRad = slopeAngleDeg * 3.14159 / 180;

// There is no need to continuously run this sensor when it isn't taking a 
// measurement, so set the sensor's power pin to the switched pin which we 
// already defined
const int8_t sonarPower = sensorPowerPin;

// Trigger should be a *unique* negative number if unconnected
const int8_t sonarTrigger = -1;

// Set the number of measurements you want to average in the final 
// recorded value 
const uint8_t sonarNumReadings = 3;

// Construct the sensor
MaxBotixSonar sonar(sonarSerial, sonarHeight, sonarPower, sonarTrigger, sonarNumReadings);

// Each variable that we want to report needs to be "constructed" as well.
// For this sensor it will include the range the sonar detected (in millimeters)
// and the snow depth (calculated based on the sonar height and the range measured).

// Sonar range variable construction
Variable* sonarRange =
    new MaxBotixSonar_Range(&sonar, "12345678-abcd-1234-ef00-1234567890ab");

// This function calculates the depth of snow
float calculateSnowDepth(void) {
    // Set a NoData value for reporting errors
    float calculatedResult = -9999;
    // The first variable input is the sonar height
    float inputVar1 = sonarHeight;
    // The second variable input is the sonar range measured
    float inputVar2 = sonarRange->getValue();
    // Make sure both inputs are good
    // A reading of 5000 is an error for the sensor as well
    // It may seem odd to check if the first input variable isn't -9999 because it is 
    // just the sonar height we entered, but for the sake of consistency it is included
    if (inputVar1 != -9999 && inputVar2 != -9999 && inputVar2 != 5000) {
      // The snow depth is the height of the sensor minus the sonar's range measurement
      calculatedResult = (inputVar1 - inputVar2) / cos(slopeAngleRad);
    }
    return calculatedResult;
}

// Properties of the calculated snow depth

// The number of digits after the decimal place
const uint8_t calculatedSnowDepthResolution = 0;
// Variable name (must be a value from http://vocabulary.odm2.org/variablename/)
const char* calculatedSnowDepthName = "Snow Depth";
// Variable units (must be a value from http://vocabulary.odm2.org/units/)
const char* calculatedSnowDepthUnit = "mm";
// A short code for the variable
const char* calculatedSnowDepthCode = "snowDepth";
// The (optional) universallly unique identifier
const char* calculatedSnowDepthUUID = "12345678-abcd-1234-ef00-1234567890ab";

Variable* calculatedSnowDepth = new Variable(
    calculateSnowDepth, calculatedSnowDepthResolution, calculatedSnowDepthName,
    calculatedSnowDepthUnit, calculatedSnowDepthCode, calculatedSnowDepthUUID);


/* ** IMPORTANT ** 
ApogeeSP510, ApogeeSP610, ApogeeSL510, and ApogeeSL610 modular sensors source codes
only function on certain pins and certain hardware. Make sure you follow the wiring,
or you may otherwise damage your sensors or hardware.

Very brief wiring instructions are included in the sketch for reference, but make sure
you wire according to the directions in the hardware folder of the GitHub repository.
In this sketch, the hexidecimal (0x...) listed in parenthesis after a wiring instruction is
the address of the ADC you need to connect to:
0x48 on the Mayfly: pins noted with two As (AA0, AA1, etc.)
0x49 ADDR jumpered to VIN
0x4A ADDR jumpered to SDA
*/


// ==========================================================================
// Apogee SP-510-SS for incoming shortwave radiation
// ==========================================================================
// There is wiring listed in this section for both an SP-710 implementation, 
// which has both the upward and downward pyranometers together, and the stand-
// alone SP-510-SS and SP-610-SS implementation. Just make sure you follow whichever
// one you are doing for your implementation. The coding itself will not change.
#include <sensors/ApogeeSP510.h>

/* WIRING FOR *SP-710-SS* SENSOR
  YELLOW  -> AA2  (0x48 ADDR -> GND)
  BLUE    -> AA3  (0x4B ADDR -> GND)
  RED     -> V12+ (POWER RELAY COM)
  GREEN   -> V12- (BATTERY GROUND)
  
  WIRING FOR *SP-510-SS* SENSOR
  WHITE	  -> AA2  (0x48 ADDR -> GND)
  BLACK   -> AA3  (0x48 ADDR -> GND)
  YELLOW  -> V12+ (POWER RELAY COM)
  BLUE    -> V12- (BATTERY GROUND)
  CLEAR   -> V12- (BATTERY GROUND)
*/

// Set the calibration factor for the SP-510
float sp510calibFactor = 24.07;

// Construct the Apogee SP-510-SS sensor object
// The -1 indicates that there is no powering up necessary for measurement 
ApogeeSP510 sp510(-1, sp510calibFactor, 0x48, 3);

// Construct the variable for the differential voltage measurement
Variable* sp510volts =
    new ApogeeSP510_Voltage(&sp510, "12345678-abcd-1234-ef00-1234567890ab");

// Construct the variable for the incoming shortwave radiation
Variable* sp510rad =
    new ApogeeSP510_ISWR(&sp510, "12345678-abcd-1234-ef00-1234567890ab");


// ==========================================================================
// Apogee SP-610-SS for outgoing shortwave radiation
// ==========================================================================
#include <sensors/ApogeeSP610.h>

/* WIRING FOR *SP-710-SS* SENSOR
  WHITE   -> AA0  (0x4B ADDR -> SCL)
  BLACK   -> AA1  (0x4B ADDR -> SCL)
  CLEAR   -> V12- (BATTERY GROUND)
  
  WIRING FOR *SP-610-SS* SENSOR
  WHITE	  -> AA0  (0x4B ADDR -> SCL)
  BLACK   -> AA1  (0x4B ADDR -> SCL)
  YELLOW  -> V12+ (POWER RELAY COM)
  BLUE    -> V12- (BATTERY GROUND)
  CLEAR   -> V12- (BATTERY GROUND)
*/

// Set the calibration factor for the SP-610
float sp610calibFactor = 31.59;

// Construct the Apogee SP-610-SS sensor object
ApogeeSP610 sp610(-1, sp610calibFactor, 0x48, 3);

// Construct the variable for the differential voltage measurement
Variable* sp610volts =
    new ApogeeSP610_Voltage(&sp610, "12345678-abcd-1234-ef00-1234567890ab");

// Construct the variable for the outgoing shortwave radiation
Variable* sp610rad =
    new ApogeeSP610_OSWR(&sp610, "12345678-abcd-1234-ef00-1234567890ab");


// ==========================================================================
// Apogee SL-510-SS for incoming longwave radiation
// ==========================================================================
#include <sensors/ApogeeSL510.h>

/* WIRING FOR *SL-510* UPWARD SENSOR
  WHITE   -> A0   (0x4A)
  BLACK   -> A1   (0x4A)
  GREEN   -> A1   (0x49)
  YELLOW  -> V12+ (POWER RELAY COM)
  BLUE    -> V12- (BATTERY GROUND)
  RED     -> SW3  (3.3V SWITCHED POWER PIN)
  CLEAR   -> V12- (BATTERY GROUND)
*/

// Set k1 and k2 factors for the SL-510
float sl510k1 = 9.007;
float sl510k2 = 1.026;

// Construct the Apogee SL-510-SS sensor object
// The only parameter you should adjust is how many measurements you 
// want to take (last parameter)
// Note that this sensor is not attached to the Mayfly's ADC pins (0x48)
ApogeeSL510 sl510(sensorPowerPin, sl510k1, sl510k2, 1, 0x49, 0x4A, 3);

// Construct the variable for the thermistor voltage
Variable* sl510thermistorVolts =
    new ApogeeSL510_Thermistor_Voltage(&sl510, "12345678-abcd-1234-ef00-1234567890ab");

// Construct the variable for the thermopile voltage
Variable* sl510thermopileVolts =
    new ApogeeSL510_Thermopile_Voltage(&sl510, "12345678-abcd-1234-ef00-1234567890ab");

// Construct the variable for incoming longwave radiation
Variable* sl510rad =
    new ApogeeSL510_ILWR(&sl510, "12345678-abcd-1234-ef00-1234567890ab");


// ==========================================================================
// Apogee SL-610-SS for incoming longwave radiation
// ==========================================================================
#include <sensors/ApogeeSL610.h>

/* WIRING FOR SL-610
  WHITE   -> A2   (0x4A)
  BLACK   -> A3   (0x4A)
  GREEN   -> A2   (0x49)
  YELLOW  -> V12+ (POWER RELAY COM)
  BLUE    -> V12- (BATTERY GROUND)
  RED     -> SW3  (3.3V SWITCHED POWER PIN)
  CLEAR   -> V12- (BATTERY GROUND)
*/

// Set the k1 and k2 factors for the SL-610
float sl610k1 = 9.021;
float sl610k2 = 1.031;

// Construct the Apogee SL-610-SS sensor object
// The only parameter you should adjust is how many measurements you 
// want to take (last parameter)
// Note that this sensor is not attached to the Mayfly's ADC pins (0x48)
ApogeeSL610 sl610(sensorPowerPin, sl610k1, sl610k2, 2, 0x49, 0x4A, 3);  

// Construct the variable for the thermistor voltage
Variable* sl610thermistorVolts =
    new ApogeeSL610_Thermistor_Voltage(&sl610, "12345678-abcd-1234-ef00-1234567890ab");

// Construct the variable for the thermopile voltage
Variable* sl610thermopileVolts =
    new ApogeeSL610_Thermopile_Voltage(&sl610, "12345678-abcd-1234-ef00-1234567890ab");

// Construct the variable for outgoing longwave radiation
Variable* sl610rad =
    new ApogeeSL610_OLWR(&sl610, "12345678-abcd-1234-ef00-1234567890ab");


// ==========================================================================
// METER Teros 12 Soil Moisture Sensors
// ==========================================================================
#include <sensors/MeterTeros12.h>

// Set the addresses of each of the sensors
// Make sure this matches what you programmed them to be
// Change the addresses given in the single quotes ('') if you did not follow 
// this same naming schema
char add1 = 'a';  // Address 1 at 2" depth
char add2 = 'b';  // Address 2 at 8" depth
char add3 = 'c';  // Address 3 at 20" depth

int8_t sdiPowerPin = sensorPowerPin;
int8_t sdiDataPin = 7;

// Construct each of the sensor objects
MeterTeros12 probe1(add1, sdiPowerPin, sdiDataPin);
MeterTeros12 probe2(add2, sdiPowerPin, sdiDataPin);
MeterTeros12 probe3(add3, sdiPowerPin, sdiDataPin);

// If you are using more than one soil sensor, make sure to differentiate between 
// the different depths using the third parameter of the variable declaration
Variable* rawVWCCounts1 = 
    new MeterTeros12_Count(&probe1, "12345678-abcd-1234-ef00-1234567890ab", "rawCounts_2in");
Variable* soilTemp1 =
    new MeterTeros12_Temp(&probe1, "12345678-abcd-1234-ef00-1234567890ab", "soilTemp_2in");
Variable* soilEa1 =
    new MeterTeros12_Ea(&probe1, "12345678-abcd-1234-ef00-1234567890ab", "soilEa_2in");
Variable* vwc1 =
    new MeterTeros12_VWC(&probe1, "12345678-abcd-1234-ef00-1234567890ab", "soilVWC_2in");
Variable* ec1 =
    new MeterTeros12_EC(&probe1, "12345678-abcd-1234-ef00-1234567890ab", "soilEC_2in");

Variable* rawVWCCounts2 = 
    new MeterTeros12_Count(&probe2, "12345678-abcd-1234-ef00-1234567890ab", "rawCounts_8in");
Variable* soilTemp2 =
    new MeterTeros12_Temp(&probe2, "12345678-abcd-1234-ef00-1234567890ab", "soilTemp_8in");
Variable* soilEa2 =
    new MeterTeros12_Ea(&probe2, "12345678-abcd-1234-ef00-1234567890ab", "soilEa_8in");
Variable* vwc2 =
    new MeterTeros12_VWC(&probe2, "12345678-abcd-1234-ef00-1234567890ab", "soilVWC_8in");
Variable* ec2 =
    new MeterTeros12_EC(&probe2, "12345678-abcd-1234-ef00-1234567890ab", "soilEC_8in");

Variable* rawVWCCounts3 = 
    new MeterTeros12_Count(&probe3, "12345678-abcd-1234-ef00-1234567890ab", "rawCounts_20in");
Variable* soilTemp3 =
    new MeterTeros12_Temp(&probe3, "12345678-abcd-1234-ef00-1234567890ab", "soilTemp_20in");
Variable* soilEa3 =
    new MeterTeros12_Ea(&probe3, "12345678-abcd-1234-ef00-1234567890ab", "soilEa_20in");
Variable* vwc3 =
    new MeterTeros12_VWC(&probe3, "12345678-abcd-1234-ef00-1234567890ab", "soilVWC_20in");
Variable* ec3 =
    new MeterTeros12_EC(&probe3, "12345678-abcd-1234-ef00-1234567890ab", "soilEC_20in");


// ==========================================================================
// Apogee ST-110-SS for Air Temperature
// ==========================================================================
#include <sensors/ApogeeST110.h>

/* WIRING FOR ST-110
  WHITE   -> A0  (0x49)
  BLACK   -> GND (Mayfly ground)
  RED     -> SW3 (3.3V SWITCHED POWER PIN)
  CLEAR   -> GND (Mayfly ground)
*/

// Create the air temperature sensor object
ApogeeST110 st110(sensorPowerPin, 0, 0x49, 50);

// Create the thermistor voltage variable
Variable* st110thermistorVolts =
    new ApogeeST110_Thermistor_Voltage(&st110, "12345678-abcd-1234-ef00-1234567890ab");

// Create the air temperature variable
Variable* st110airTemp =
    new ApogeeST110_AIRT(&st110, "12345678-abcd-1234-ef00-1234567890ab");


// ==========================================================================
// Variable List
// ==========================================================================
// This list of variables is what the program will cycle through when 
// determining what data to collect.

Variable* variableList[] = {
    new ProcessorStats_SampleNumber(&mcuBoard, "12345678-abcd-1234-ef00-1234567890ab"),
    new MaximDS3231_Temp(&ds3231, "12345678-abcd-1234-ef00-1234567890ab"),
    sp510volts,
    sp510rad,
    sp610volts,
    sp610rad,
    sl510thermistorVolts,
    sl510thermopileVolts,
    sl510rad,
    sl610thermistorVolts,
    sl610thermopileVolts,
    sl610rad,
    rawVWCCounts1,
    soilTemp1,
    soilEa1,
    vwc1,
    ec1,
    rawVWCCounts2,
    soilTemp2,
    soilEa2,
    vwc2,
    ec2,
    rawVWCCounts3,
    soilTemp3,
    soilEa3,
    vwc3,
    ec3,
    st110thermistorVolts,
    st110airTemp,
    sonarRange,
    calculatedSnowDepth
};

//  The number of UUID's must match the number of variables!
const char* UUIDs[] = {
    "12345678-abcd-1234-ef00-1234567890ab",  // sampNum
    "12345678-abcd-1234-ef00-1234567890ab",  // boardTemp
    "12345678-abcd-1234-ef00-1234567890ab",  // sp510volts
    "12345678-abcd-1234-ef00-1234567890ab",  // sp510rad
    "12345678-abcd-1234-ef00-1234567890ab",  // sp610volts
    "12345678-abcd-1234-ef00-1234567890ab",  // sp610rad
    "12345678-abcd-1234-ef00-1234567890ab",  // sl510thermistorVolts
    "12345678-abcd-1234-ef00-1234567890ab",  // sl510thermopileVolts
    "12345678-abcd-1234-ef00-1234567890ab",  // sl510rad
    "12345678-abcd-1234-ef00-1234567890ab",  // sl610thermistorVolts
    "12345678-abcd-1234-ef00-1234567890ab",  // sl610thermopileVolts
    "12345678-abcd-1234-ef00-1234567890ab",  // sl610rad
    "12345678-abcd-1234-ef00-1234567890ab",  // rawCountsVWC1
    "12345678-abcd-1234-ef00-1234567890ab",  // soilTemp1
    "12345678-abcd-1234-ef00-1234567890ab",  // soilEa1
    "12345678-abcd-1234-ef00-1234567890ab",  // vwc1
    "12345678-abcd-1234-ef00-1234567890ab",  // ec1
    "12345678-abcd-1234-ef00-1234567890ab",  // rawCountsVWC2
    "12345678-abcd-1234-ef00-1234567890ab",  // soilTemp2
    "12345678-abcd-1234-ef00-1234567890ab",  // soilEa2
    "12345678-abcd-1234-ef00-1234567890ab",  // vwc2
    "12345678-abcd-1234-ef00-1234567890ab",  // ec2
    "12345678-abcd-1234-ef00-1234567890ab",  // rawCountsVWC3
    "12345678-abcd-1234-ef00-1234567890ab",  // soilTemp3
    "12345678-abcd-1234-ef00-1234567890ab",  // soilEa3
    "12345678-abcd-1234-ef00-1234567890ab",  // vwc3
    "12345678-abcd-1234-ef00-1234567890ab",  // ec3
    "12345678-abcd-1234-ef00-1234567890ab",  // st110thermistorVolts
    "12345678-abcd-1234-ef00-1234567890ab",  // st110airTemp
    "12345678-abcd-1234-ef00-1234567890ab",  // sonarRange
    "12345678-abcd-1234-ef00-1234567890ab"   // calculatedSnowDepth
};

// Count up the number of pointers in the array
uint8_t variableCount = sizeof(variableList) / sizeof(variableList[0]);

// Create the VariableArray object
VariableArray varArray(variableCount, variableList);


// ==========================================================================
// The Logger Object[s]
// ==========================================================================
// Create a logger instance
Logger dataLogger;

// ==========================================================================
// Creating Data Publisher[s]
// ==========================================================================
// Create your authentication information for HydroServer. Pass in a string
// that is the Base64 encoding of your HydroServer account email and password
// separated by a colon - i.e., "email@email.com:Password"
// You can get this encoding at https://www.base64encode.org/
const char* base64Authorization = "YOUR_ENCODED_CREDENTIALS_HERE";  

// Create a data publisher for the HydroServer POST endpoint
#include <publishers/HydroServer.h>
HydroServerPublisher HydroServerPOST(dataLogger, &modem.gsmClient,
                                 base64Authorization);


// ==========================================================================
//  Working Functions
// ==========================================================================
// Flashes the LEDs on the primary board
// The EnviroDIY community created this function. It can be useful for 
// debugging, such as when you want to monitor the board while it runs, you 
// can stick this function in where you want to check if the datalogger ever 
// made it to that section of the program
void greenredflash(uint8_t numFlash = 4, uint8_t rate = 75) {
    for (uint8_t i = 0; i < numFlash; i++) {
        digitalWrite(greenLED, HIGH);
        digitalWrite(redLED, LOW);
        delay(rate);
        digitalWrite(greenLED, LOW);
        digitalWrite(redLED, HIGH);
        delay(rate);
    }
    digitalWrite(redLED, LOW);
}


// ==========================================================================
//  Arduino Setup Function
// ==========================================================================
// This function always runs first after the Mayfly/Arduino is powered up,
// and only runs once
void setup() {
  // Power relay setup
  pinMode(powerRelayPin, OUTPUT);
  digitalWrite(powerRelayPin, LOW);

 // Start the primary serial connection
  Serial.begin(serialBaud);

  // Print a start-up note to the first serial port
  Serial.print(F("Now running "));
  Serial.print(sketchName);
  Serial.print(F(" on Logger "));
  Serial.println(LoggerID);
  Serial.println();

  Serial.print(F("Using ModularSensors Library version "));
  Serial.println(MODULAR_SENSORS_VERSION);
  Serial.print(F("TinyGSM Library version "));
  Serial.println(TINYGSM_VERSION);
  Serial.println();

  // Start the serial connection with the modem
  modemSerial.begin(modemBaud);

  // Set up pins for the LEDs
  pinMode(greenLED, OUTPUT);
  digitalWrite(greenLED, LOW);
  pinMode(redLED, OUTPUT);
  digitalWrite(redLED, LOW);
  // Blink the LEDs to show the board is on and starting up
  greenredflash();

  pinMode(20, OUTPUT);  // for proper operation of the onboard flash memory
                        // chip's ChipSelect (Mayfly v1.0 and later)

  // Set the timezones for the logger/data and the RTC
  // Logging in the given time zone
  Logger::setLoggerTimeZone(timeZone);
  // It is STRONGLY RECOMMENDED that you set the RTC to be in UTC (UTC+0)
  Logger::setRTCTimeZone(0);

  // Attach the modem and information pins to the logger
  dataLogger.attachModem(modem);
  modem.setModemLED(modemLEDPin);
  dataLogger.setLoggerPins(wakePin, sdCardSSPin, sdCardPwrPin, buttonPin,
                            greenLED);

  // Begin the logger
  dataLogger.begin(LoggerID, loggingInterval, &varArray);

  // Set up the sensors, except at lowest battery level
  Serial.println(F("Setting up sensors..."));
  varArray.setupSensors();

  // Set up the cellular modem
  modem.setModemWakeLevel(HIGH);   // ModuleFun Bee inverts the signal
  modem.setModemResetLevel(HIGH);  // ModuleFun Bee inverts the signal
  Serial.println(F("Waking modem and setting Cellular Carrier Options..."));
  modem.modemWake();  // NOTE:  This will also set up the modem
  modem.gsmModem.setBaud(modemBaud);   // Make sure we're *NOT* auto-bauding!
  modem.gsmModem.setNetworkMode(38);   // set to LTE only
                                       // 2 Automatic
                                       // 13 GSM only
                                       // 38 LTE only
                                       // 51 GSM and LTE only
  modem.gsmModem.setPreferredMode(1);  // set to CAT-M
                                       // 1 CAT-M
                                       // 2 NB-IoT
                                       // 3 CAT-M and NB-IoT

  // Synchronize the RTC with NIST
  // This will also set up the modem
  dataLogger.syncRTC();

  // Create the log file, adding the default header to it
  // Do this last so we have the best chance of getting the time correct and
  // all sensor names correct
  // Writing to the SD card can be power intensive, so if we're skipping
  // the sensor setup we'll skip this too.
  Serial.println(F("Setting up file on SD card"));
  dataLogger.turnOnSDcard(
      true);  // true = wait for card to settle after power up
  dataLogger.createLogFile(true);  // true = write a new header
  dataLogger.turnOffSDcard(
      true);  // true = wait for internal housekeeping after write

  // Call the processor sleep
  Serial.println(F("Putting processor to sleep\n"));
  dataLogger.systemSleep();

  // Begin the MaxBotix's serial communication
  sonarSerial.begin(9600);
}


// ==========================================================================
//  Arduino Loop Function
// ==========================================================================
// This function continuously runs until the Arduino/Mayfly is no longer powered
void loop() {
  /*
  Check if it is time to power up the Apogee radiometer heaters
  You can change how long before the logging interval you turn them on by changing
  what the expression needs to be equal to. If you want it to turn on at the 45-minute
  mark (15 minutes before logging if you are logging on the hour), it needs equal 2700 
  (45 min * 60 sec/min). If you want them to turn on at the 15-minute mark, for example,
  set it equal to 15 min * 60 sec/min = 900
  */
  // Check if we are on the 45th minute (2700 seconds into the interval)
  if (dataLogger.getNowLocalEpoch() % (loggingInterval * 60) == 2400) {  
    digitalWrite(22, HIGH);  // Power up the power relay (pin 22 is the Mayfly's switched power output)
    delay(1000);
    // Set the signal pin high (to close the circuit, the relay is waiting for a signal drop)
    digitalWrite(powerRelayPin, HIGH);
    delay(1000);
    // Let the relay know it is good to close the circuit by dropping the pin to low
    digitalWrite(powerRelayPin, LOW);
    digitalWrite(22, LOW);  // Turn off switched power
  }
  // During logData, the marked time will update when a new measurement is taken
  dataLogger.logDataAndPublish(); 
}
