CIROH-Snow/snow_sensing/code/arduino_libraries/EnviroDIY_ModularSensors/src/dataPublisherBase.h

/**
 * @file dataPublisherBase.h
 * @copyright 2017-2022 Stroud Water Research Center
 * Part of the EnviroDIY ModularSensors library for Arduino
 * @author Sara Geleskie Damiano <sdamiano@stroudcenter.org>
 *
 * @brief Contains the dataPublisher class - a virtual class used by other
 * publishers to distribute data online.
 *
 * @copydetails dataPublisher
 */
/**
 * @defgroup the_publishers Supported Data Endpoints
 * All implemented data endpoint (publisher) classes
 *
 * @copydetails dataPublisher
 */

// Header Guards
#ifndef SRC_DATAPUBLISHERBASE_H_
#define SRC_DATAPUBLISHERBASE_H_

// Debugging Statement
#define MS_DATAPUBLISHERBASE_DEBUG

#ifdef MS_DATAPUBLISHERBASE_DEBUG
#define MS_DEBUGGING_STD "dataPublisherBase"
#endif


/**
 * @def MS_SEND_BUFFER_SIZE
 * @brief Send Buffer
 *
 * This determines how many characters to set out at once over the TCP/UDP
 * connection.  Increasing this may decrease data use by a loger, while
 * decreasing it will save memory.  Do not make it smaller than 47 (to keep all
 * variable values with their UUID's) or bigger than 1500 (a typical TCP/UDP
 * Maximum Transmission Unit).
 *
 * This can be changed by setting the build flag MS_SEND_BUFFER_SIZE when
 * compiling.
 *
 * @ingroup the_publishers
 */
#ifndef MS_SEND_BUFFER_SIZE
#define MS_SEND_BUFFER_SIZE 750
#endif

// Included Dependencies
#include "ModSensorDebugger.h"
#undef MS_DEBUGGING_STD
#include "LoggerBase.h"
#include "Client.h"

/**
 * @brief The dataPublisher class is a virtual class used by other publishers to
 * distribute data online.
 *
 * A dataPublisher is a abstract concept.  It is something that "watches" the
 * logger for new data and correctly formats and sends that data to some online
 * web service.
 *
 * @ingroup base_classes
 */
class dataPublisher {
 public:
    /**
     * @brief Construct a new data Publisher object untied to any logger or
     * client.
     *
     * @note Using the default empty constructor requires you to use a the
     * begin(Logger& baseLogger, Client* inClient) function to initialize
     * the logger and client values.  If a client is never specified, the
     * publisher will attempt to create and use a client on a LoggerModem
     * instance tied to the attached logger.  If a logger is never specified the
     * publisher will not function.
     */
    dataPublisher();
    /**
     * @brief Construct a new data Publisher object using a single client
     * created on the TinyGSM based logger modem.
     *
     * @note If a client is never specified, the publisher will attempt to
     * create and use a client on a LoggerModem instance tied to the attached
     * logger.
     *
     * @param baseLogger The logger supplying the data to be published
     * @param sendEveryX Currently unimplemented, intended for future use to
     * enable caching and bulk publishing
     * @param sendOffset Currently unimplemented, intended for future use to
     * enable publishing data at a time slightly delayed from when it is
     * collected
     *
     * @note It is possible (though very unlikey) that using this constructor
     * could cause errors if the compiler attempts to initialize the publisher
     * instance before the logger instance.  If you suspect you are seeing that
     * issue, use the null constructor and a populated begin(...) within your
     * set-up function.
     */
    explicit dataPublisher(Logger& baseLogger, uint8_t sendEveryX = 1,
                           uint8_t sendOffset = 0);
    /**
     * @brief Construct a new data Publisher object.
     *
     * @param baseLogger The logger supplying the data to be published
     * @param inClient An Arduino client instance to use to print data to.
     * Allows the use of any type of client and multiple clients tied to a
     * single TinyGSM modem instance
     * @param sendEveryX Currently unimplemented, intended for future use to
     * enable caching and bulk publishing
     * @param sendOffset Currently unimplemented, intended for future use to
     * enable publishing data at a time slightly delayed from when it is
     * collected
     *
     * @note It is possible (though very unlikey) that using this constructor
     * could cause errors if the compiler attempts to initialize the publisher
     * instance before the logger instance.  If you suspect you are seeing that
     * issue, use the null constructor and a populated begin(...) within your
     * set-up function.
     */
    dataPublisher(Logger& baseLogger, Client* inClient, uint8_t sendEveryX = 1,
                  uint8_t sendOffset = 0);
    /**
     * @brief Destroy the data Publisher object - no action is taken.
     */
    virtual ~dataPublisher();

    /**
     * @brief Set the Client object.
     *
     * Gives the publisher a client instance to use to "print" data.
     *
     * @param inClient A pointer to an Arduino client instance
     */
    void setClient(Client* inClient);

    /**
     * @brief Attach the publisher to a logger.
     *
     * The publisher must be tied to a data loger to provide it with the data to
     * be published.
     *
     * @param baseLogger A reference to the ModularSensors logger instance
     */
    void attachToLogger(Logger& baseLogger);
    /**
     * @brief Set the parameters for frequency of sending and any offset, if
     * needed.
     *
     * @param sendEveryX Currently unimplemented, intended for future use to
     * enable caching and bulk publishing
     * @param sendOffset Currently unimplemented, intended for future use to
     * enable publishing data at a time slightly delayed from when it is
     * collected
     *
     * @note These parameters are not currently used!
     */
    void setSendFrequency(uint8_t sendEveryX, uint8_t sendOffset);

    /**
     * @brief Begin the publisher - linking it to the client and logger.
     *
     * This can be used as an alternative to adding the logger and client in the
     * constructor.  This is slightly "safer" because we expect the publishers
     * to be created in the "global scope" and we cannot control the order in
     * which objects in that global scope will be created.  That is, we cannot
     * guarantee that the logger will actually be created before the publisher
     * that wants to attach to it unless we wait to attach the publisher until
     * in the setup or loop function of the main program.  In reality, it is
     * very unlikely that this is necessary.
     *
     * @param baseLogger The logger supplying the data to be published
     * @param inClient An Arduino client instance to use to print data to.
     * Allows the use of any type of client and multiple clients tied to a
     * single TinyGSM modem instance
     */
    void begin(Logger& baseLogger, Client* inClient);

    /**
     * @brief Begin the publisher - linking it to the logger but not
     * attaching a client.
     *
     * @note If a client is never specified, the publisher will attempt to
     * create and use a client on a LoggerModem instance tied to the attached
     * logger.
     *
     * This can be used as an alternative to adding the logger and client in the
     * constructor.  This is slightly "safer" because we expect the publishers
     * to be created in the "global scope" and we cannot control the order in
     * which objects in that global scope will be created.  That is, we cannot
     * guarantee that the logger will actually be created before the publisher
     * that wants to attach to it unless we wait to attach the publisher until
     * in the setup or loop function of the main program.  In reality, it is
     * very unlikely that this is necessary.
     *
     * @param baseLogger The logger supplying the data to be published
     */
    void begin(Logger& baseLogger);


    /**
     * @brief Get the destination for published data - generally the host name
     * of the data receiver.
     *
     * @return **String** The URL or HOST to receive published data
     */
    virtual String getEndpoint(void) = 0;


    /**
     * @brief Open a socket to the correct receiver and sends out the formatted
     * data.
     *
     * This depends on an internet connection already having been made and a
     * client being available.
     *
     * @param outClient An Arduino client instance to use to print data to.
     * Allows the use of any type of client and multiple clients tied to a
     * single TinyGSM modem instance
     * @return **int16_t** The result of publishing data.  May be an http
     * response code or a result code from PubSubClient.
     */
    virtual int16_t publishData(Client* outClient) = 0;
    /**
     * @brief Open a socket to the correct receiver and send out the formatted
     * data.
     *
     * This depends on an internet connection already having been made and
     * either a client having been linked to the publisher or a logger modem
     * having been linked to the logger linked to the publisher.
     *
     * @return **int16_t** The result of publishing data.  May be an http
     * response code or a result code from PubSubClient.
     */
    virtual int16_t publishData();

    /**
     * @brief Retained for backwards compatibility; use publishData(Client*
     * outClient) in new code.
     *
     * @m_deprecated_since{0,22,5}
     *
     * @param outClient An Arduino client instance to use to print data to.
     * Allows the use of any type of client and multiple clients tied to a
     * single TinyGSM modem instance
     * @return **int16_t** The result of publishing data.  May be an http
     * response code or a result code from PubSubClient.
     */
    virtual int16_t sendData(Client* outClient);
    /**
     * @brief Retained for backwards compatibility; use publishData() in new
     * code.
     *
     * @m_deprecated_since{0,22,5}
     *
     * @return **int16_t** The result of publishing data.  May be an http
     * response code or a result code from PubSubClient.
     */
    virtual int16_t sendData();

    /**
     * @brief Translate a PubSubClient code into a String with the code
     * explanation.
     *
     * @param state A result code returned by a PubSubClient action
     * @return **String** The meaning of the code
     */
    String parseMQTTState(int state);


 protected:
    /**
     * @brief The internal pointer to the logger instance to be used.
     */
    Logger* _baseLogger = nullptr;
    /**
     * @brief The internal pointer to the client instance to be used.
     */
    Client* _inClient = nullptr;

    /**
     * @brief A buffer for outgoing data.
     */
    static char txBuffer[MS_SEND_BUFFER_SIZE];
    /**
     * @brief Get the number of empty spots in the buffer.
     *
     * @return **int** The number of available characters in the buffer
     */
    static int bufferFree(void);
    /**
     * @brief Fill the TX buffer with nulls ('\0').
     */
    static void emptyTxBuffer(void);
    /**
     * @brief Write the TX buffer to a stream and also to the debugging
     * port.
     *
     * @param stream A pointer to an Arduino Stream instance to use to print
     * data
     * @param addNewLine True to add a new line character ("\n") at the end of
     * the print
     */
    static void printTxBuffer(Stream* stream, bool addNewLine = false);

    /**
     * @brief Unimplemented; intended for future use to enable caching and bulk
     * publishing.
     */
    uint8_t _sendEveryX = 1;
    /**
     * @brief Unimplemented; intended for future use to enable publishing data
     * at a time slightly delayed from when it is collected.
     */
    uint8_t _sendOffset = 0;

    // Basic chunks of HTTP
    /**
     * @brief the text "GET "
     */
    static const char* getHeader;
    /**
     * @brief the text "POST "
     */
    static const char* postHeader;
    /**
     * @brief the text " HTTP/1.1"
     */
    static const char* HTTPtag;
    /**
     * @brief the text "\r\nHost: "
     */
    static const char* hostHeader;
};

#endif  // SRC_DATAPUBLISHERBASE_H_
