CIROH-Snow/snow_sensing/code/arduino_libraries/EnviroDIY_GPRSBee/src/GPRSbee.h

#ifndef GPRSBEE_H_
#define GPRSBEE_H_
/*
 * Copyright (c) 2013-2015 Kees Bakker.  All rights reserved.
 *
 * This file is part of GPRSbee.
 *
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
 * You should have received a copy of the GNU Lesser General Public
 * License along with GPRSbee.  If not, see
 * <http://www.gnu.org/licenses/>.
 */

#include <stdint.h>
#include <Arduino.h>
#include <Stream.h>

// Comment this line, or make it an undef to disable
// diagnostic
#define ENABLE_GPRSBEE_DIAG     1

/*!
 * \def SIM900_DEFAULT_BUFFER_SIZE
 *
 * The GPRSbee class uses an internal buffer to read lines from
 * the SIMx00. The buffer is allocated in .init() and the default
 * size is what this define is set to.
 *
 * The function .readline() is the only function that writes to this
 * internal buffer.
 *
 * Other functions (such as receiveLineTCP) can make use of .readline
 * and sometimes it is necessary that the buffer is much bigger. Please
 * be aware that the buffer is allocated once and never freed.
 *
 * You can make it allocate a bigger buffer by calling .setBufSize()
 * before doing the .init()
 */
#define SIM900_DEFAULT_BUFFER_SIZE      64

/*
 * \brief A class to store clock values
 */
class SIMDateTime
{
public:
  SIMDateTime(uint32_t ts=0);
  SIMDateTime(uint8_t y, uint8_t m, uint8_t d, uint8_t hh, uint8_t mm, uint8_t ss, int8_t tz=0);
  SIMDateTime(const char * cclk);

  enum _WEEK_DAYS_ {
    SUNDAY,
    MONDAY,
    TUESDAY,
    WEDNESDAY,
    THURSDAY,
    FRIDAY,
    SATURDAY
  };

  uint16_t      year() { return _yOff + 2000; }
  uint8_t       month() { return _m + 1; }
  uint8_t       day() { return _d + 1; }
  uint8_t       hour() { return _hh; }
  uint8_t       minute() { return _mm; }
  uint8_t       second() { return _ss; }

  // 32-bit number of seconds since Unix epoch (1970-01-01)
  uint32_t getUnixEpoch() const;
  // 32-bit number of seconds since Y2K epoch (2000-01-01)
  uint32_t getY2KEpoch() const;

  void addToString(String & str) const;

private:
  uint8_t       conv1d(const char * txt);
  uint8_t       conv2d(const char * txt);

  uint8_t       _yOff;          // Year value minus 2000
  uint8_t       _m;             // month (0..11)
  uint8_t       _d;             // day (0..30)
  uint8_t       _hh;            // hour (0..23)
  uint8_t       _mm;            // minute (0..59)
  uint8_t       _ss;            // second (0..59)
  int8_t        _tz;            // timezone (multiple of 15 minutes)
};

class GPRSbeeClass
{
public:
  void init(Stream &stream, int ctsPin, int powerPin,
      int bufferSize=SIM900_DEFAULT_BUFFER_SIZE);
  void initNdogoSIM800(Stream &stream, int pwrkeyPin, int vbatPin, int statusPin,
      int bufferSize=SIM900_DEFAULT_BUFFER_SIZE);
  bool on();
  bool off();
  void setPowerSwitchedOnOff(bool x) { _onoffMethod = onoff_mbili_jp2; }
  void setDiag(Stream &stream) { _diagStream = &stream; }
  void setDiag(Stream *stream) { _diagStream = stream; }

  void setSkipCGATT(bool x=true)        { _skipCGATT = x; _changedSkipCGATT = true; }

  void setMinSignalQuality(int q) { _minSignalQuality = q; }
  uint8_t getLastCSQ() const { return _lastCSQ; }
  uint8_t getCSQtime() const { return _CSQtime; }

  void addHTTPHeaders(const String headers) { _HTTPHeaders = headers; }
  void addContentType(const String content) { _contentType = content; }

  bool doHTTPPOST(const char *apn, const char *url, const char *postdata, size_t pdlen);
  bool doHTTPPOST(const char *apn, const String & url, const char *postdata, size_t pdlen);
  bool doHTTPPOST(const char *apn, const char *apnuser, const char *apnpwd,
      const char *url, const char *postdata, size_t pdlen);
  bool doHTTPPOSTmiddle(const char *url, const char *postdata, size_t pdlen);
  bool doHTTPPOSTmiddleWithReply(const char *url, const char *postdata, size_t pdlen, char *buffer, size_t len);

  bool doHTTPPOSTWithReply(const char *apn, const char *url, const char *postdata, size_t pdlen, char *buffer, size_t len);
  bool doHTTPPOSTWithReply(const char *apn, const String & url, const char *postdata, size_t pdlen, char *buffer, size_t len);
  bool doHTTPPOSTWithReply(const char *apn, const char *apnuser, const char *apnpwd,
      const char *url, const char *postdata, size_t pdlen, char *buffer, size_t len);

  bool doHTTPGET(const char *apn, const char *url, char *buffer, size_t len);
  bool doHTTPGET(const char *apn, const String & url, char *buffer, size_t len);
  bool doHTTPGET(const char *apn, const char *apnuser, const char *apnpwd,
      const char *url, char *buffer, size_t len);
  bool doHTTPGETmiddle(const char *url, char *buffer, size_t len);

  bool doHTTPREAD(char *buffer, size_t len);
  bool doHTTPACTION(char num);

  bool doHTTPprolog(const char *apn);
  bool doHTTPprolog(const char *apn, const char *apnuser, const char *apnpwd);
  void doHTTPepilog();

  bool openTCP(const char *apn, const char *server, int port, bool transMode=false);
  bool openTCP(const char *apn, const char *apnuser, const char *apnpwd,
      const char *server, int port, bool transMode=false);
  void closeTCP();
  bool isTCPConnected();
  bool sendDataTCP(const uint8_t *data, int data_len);
  bool receiveLineTCP(const char **buffer, uint16_t timeout=4000);

  bool openFTP(const char *apn, const char *server,
      const char *username, const char *password);
  bool openFTP(const char *apn, const char *apnuser, const char *apnpwd,
      const char *server, const char *username, const char *password);
  bool closeFTP();
  bool openFTPfile(const char *fname, const char *path);
  bool sendFTPdata(uint8_t *data, size_t size);
  bool sendFTPdata(uint8_t (*read)(), size_t size);
  bool closeFTPfile();

  bool sendSMS(const char *telno, const char *text);

  bool getIMEI(char *buffer, size_t buflen);
  bool getGCAP(char *buffer, size_t buflen);
  bool getCIMI(char *buffer, size_t buflen);
  bool getCLIP(char *buffer, size_t buflen);
  bool getCLIR(char *buffer, size_t buflen);
  bool getCOLP(char *buffer, size_t buflen);
  bool getCOPS(char *buffer, size_t buflen);
  bool setCCLK(const SIMDateTime & dt);
  bool getCCLK(char *buffer, size_t buflen);
  bool getCSPN(char *buffer, size_t buflen);
  bool getCGID(char *buffer, size_t buflen);
  bool setCIURC(uint8_t value);
  bool getCIURC(char *buffer, size_t buflen);
  bool setCFUN(uint8_t value);
  bool getCFUN(uint8_t * value);

  void enableCIURC();
  void disableCIURC();
  void enableLTS();
  void disableLTS();

  bool sendCommandWaitForOK(const char *cmd, uint16_t timeout=4000);
  bool sendCommandWaitForOK(const String & cmd, uint16_t timeout=4000);
  bool sendCommandWaitForOK_P(const char *cmd, uint16_t timeout=4000);

  // Using CCLK, get 32-bit number of seconds since Unix epoch (1970-01-01)
  uint32_t getUnixEpoch() const;
  // Using CCLK, get 32-bit number of seconds since Y2K epoch (2000-01-01)
  uint32_t getY2KEpoch() const;

private:
  void initProlog(Stream &stream, size_t bufferSize);
  void onToggle();
  void offToggle();
  void onSwitchMbiliJP2();
  void offSwitchMbiliJP2();
  void onSwitchNdogoSIM800();
  void offSwitchNdogoSIM800();
  bool isOn();
  void toggle();
  bool isAlive();
  void switchEchoOff();
  void flushInput();
  int readLine(uint32_t ts_max);
  int readBytes(size_t len, uint8_t *buffer, size_t buflen, uint32_t ts_max);
  bool waitForOK(uint16_t timeout=4000);
  bool waitForMessage(const char *msg, uint32_t ts_max);
  bool waitForMessage_P(const char *msg, uint32_t ts_max);
  int waitForMessages(const char *msgs[], size_t nrMsgs, uint32_t ts_max);
  bool waitForPrompt(const char *prompt, uint32_t ts_max);

  void sendCommandProlog();
  void sendCommandAdd(char c);
  void sendCommandAdd(int i);
  void sendCommandAdd(const char *cmd);
  void sendCommandAdd(const String & cmd);
  void sendCommandAdd_P(const char *cmd);
  void sendCommandEpilog();

  void sendCommand(const char *cmd);
  void sendCommand_P(const char *cmd);

  bool getIntValue(const char *cmd, const char *reply, int * value, uint32_t ts_max);
  bool getIntValue_P(const char *cmd, const char *reply, int * value, uint32_t ts_max);
  bool getStrValue(const char *cmd, const char *reply, char * str, size_t size, uint32_t ts_max);
  bool getStrValue_P(const char *cmd, const char *reply, char * str, size_t size, uint32_t ts_max);
  bool getStrValue(const char *cmd, char * str, size_t size, uint32_t ts_max);

  bool connectProlog();
  bool waitForSignalQuality();
  bool waitForCREG();
  bool setBearerParms(const char *apn, const char *user, const char *pwd);

  bool getPII(char *buffer, size_t buflen);
  void setProductId();

  // Small utility to see if we timed out
  bool isTimedOut(uint32_t ts) { return (long)(millis() - ts) >= 0; }

  const char * skipWhiteSpace(const char * txt);

  bool sendFTPdata_low(uint8_t *buffer, size_t size);
  bool sendFTPdata_low(uint8_t (*read)(), size_t size);

  enum onoffKind {
    onoff_toggle,
    onoff_mbili_jp2,
    onoff_ndogo_sim800,
  };
  char * _SIM900_buffer;
  size_t _bufSize;
  Stream *_myStream;
  Stream *_diagStream;
  int8_t _statusPin;
  int8_t _powerPin;
  int8_t _vbatPin;
  int _minSignalQuality;
  size_t _ftpMaxLength;
  bool _transMode;
  bool _echoOff;
  enum onoffKind _onoffMethod;
  bool _skipCGATT;
  bool _changedSkipCGATT;		// This is set when the user has changed it.
  uint8_t _lastCSQ;
  uint8_t _CSQtime;
  enum productIdKind {
    prodid_unknown,
    prodid_SIM900,
    prodid_SIM800,
  };
  enum productIdKind _productId;
  String _HTTPHeaders;
  String _contentType;
};

extern GPRSbeeClass gprsbee;

#endif /* GPRSBEE_H_ */
