CIROH-Snow/snow_sensing/code/arduino_libraries/Tally_Library/src/Tally_Library.h

/******************************************************************************
Tally_Library.h
Library for interfacing Tally event counter
Bobby Schulz @ Northern Widget LLC
1/22/2019
https://github.com/NorthernWidget-Skunkworks/Tally_Library

This library is used to interface to the Tally event counter module and allow for easy
reading and resetting of the device

"At each increase of knowledge, as well as on the contrivance of every new tool, human
labour becomes abridged." -Charles Babbage

Distributed as-is; no warranty is given.
******************************************************************************/

#ifndef TALLY_LIBRARY_H
#define TALLY_LIBRARY_H

#include "Tally.h"
#include "Tally_I2C.h"

#endif
