CIROH-Snow/snow_sensing/(commit log)

2024-11-08 Initial code commit
    This commit adds all the code for the station setup, including datalogger code, libraries, utilities, etc. It also includes the instrumentation breakdown in the hardware folder.
    [CPPLINT.cfg, InstrumentationCosts_11-9-2023_updated.xlsx, Y511-Turbidity-Calibrator.xlsx, Y520-Conductivity-Calibrator.xlsx, Y532-pH-Calibrator.xlsx, YosemiTech_Temperature_Calibration.xlsx, cpplint.cfg]
2024-11-15 First wave of initial updates
    This update contains many new README files, added guides, images, and some modifications and moving around of files for better organization. There is still a fair amount more to come, but I wanted to get all these updates off my local drive and into the repository in case something happened to my laptop.
    [Copy of InstrumentationCosts_11-9-2023_updated.xlsx]
2024-11-19 Update README.md
    Update link to arduino IDE download
2024-11-19 Update README.md
    Fixing arduino IDE link
2024-11-19 Remove one library and some mods
    I removed the XBee-Library-Arduino file from the arduino_libraries folder because I don't actually use that one. I thought I might originally, but I didn't end up using it. I also modified the central_station.ino code
    [satellite_station.ino]
2024-11-20 changed file names
    [hardware_spreadsheet_campbellsci.xlsx, hardware_spreadsheet_not_campbellsci.xlsx]
2024-11-20 Updated source code and satellite station sketch
    I updated the modular sensors library's code for the Apogee sensors so that you do not have to go into the source code for adjusting the calibration factors. Now you can just enter them as parameters in the object constructor in the satellite station code.
2024-11-26 Update soldering_guide.md - changing image extensions
2024-12-13 Added publishers and utility
    First iteration of HydroServer publishers added to the Modular Sensors library. An updated sonar sensor testing sketch was added to the utilities, and the satellite_station.ino file had some updates, such as being able to account for terrain slope in the snow depth measurement.
2024-12-30 updated hardware list
    I have updated the two spreadsheets that breakdown the costs for materials.
    [hardware_spreadsheet_campbellsci.xlsx, hardware_spreadsheet_not_campbellsci.xlsx]
2025-01-21 Added construction images and updated some hardware items in the spreadsheet
    [hardware_spreadsheet_not_campbellsci.xlsx]
2025-01-25 Added LTE station code
    [hardware_spreadsheet_campbellsci.xlsx, hardware_spreadsheet_not_campbellsci.xlsx]
2025-01-27 Added wiring images
2025-01-27 Added photos for guides and adjusted the price of the Solperk solar panel and charge controller on the cost spreadsheet
    [hardware_spreadsheet_not_campbellsci.xlsx]
2025-02-03 updated hardware spreadsheet
    [hardware_spreadsheet_campbellsci.xlsx]
2025-04-15 Reorganizing code folder and adding new spreadsheet
    I'm trying to structure the code folder in a more concise manner that doesn't confuse the user as to what is what.
    [hardware_spreadsheet_highend.xlsx]
2025-08-29 Update hardware_spreadsheet_not_campbellsci.xlsx
    Minor edits to non-CSI hardware spreadsheet to match the paper.
    [hardware_spreadsheet_not_campbellsci.xlsx]
2025-12-26 Updating soldering guide
    Reformatting, adding header links, etc.
2025-12-26 Update soldering_guide.md
    Small changes to formatting.
2025-12-27 Update wiring_guide.md
    Adding section headers, navigation links, etc.
2025-12-27 Update soldering_guide.md
    Changes to formatting
2025-12-27 Update hardware_purchase.md
    Adding sensor details
2025-12-29 Cleanup code of push_to_mayfly_lte
    Also correct the name of the file.
    [push_to_mayfly_lte.ino]
2025-12-29 Bulk update of arduino_libraries folder
