CIROH-Snow/snow_sensing/hardware/wiring_images/IMG_9265.JPG

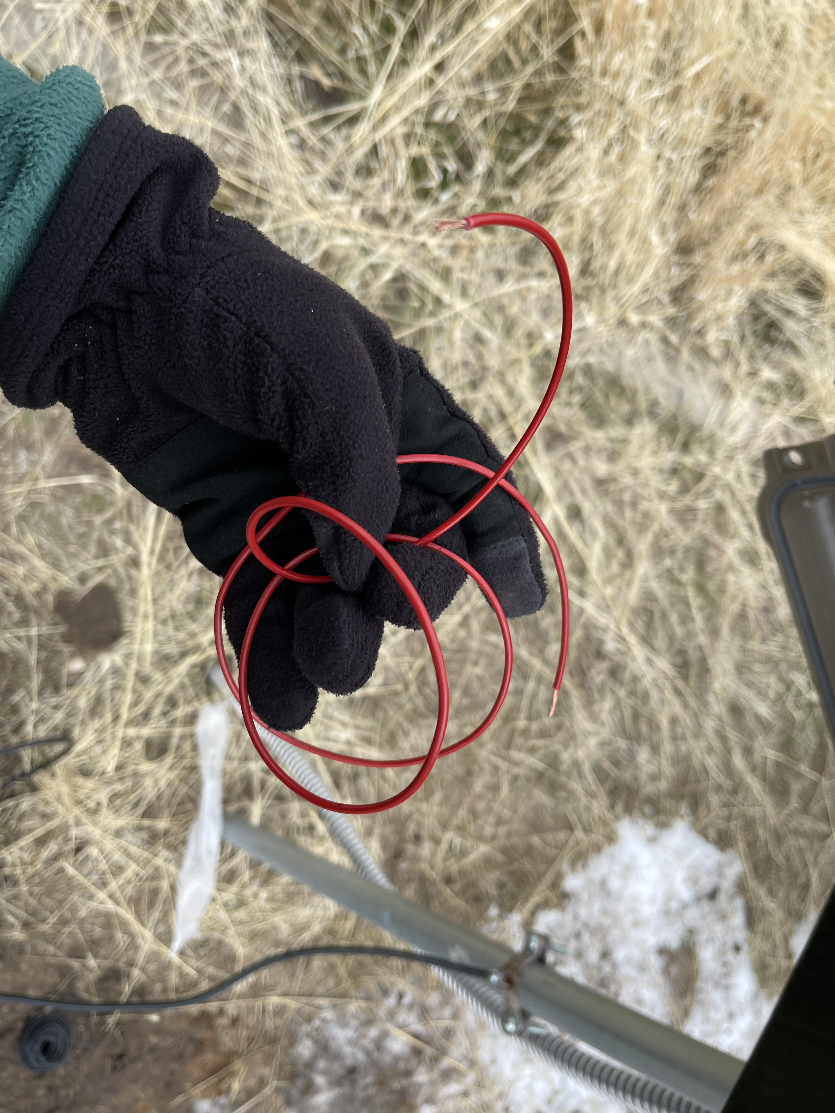
[picture p118: hardware/wiring_images/IMG_9265.JPG]
hardware/wiring_images/IMG_9265.JPG
