CIROH-Snow/snow_sensing/hardware/construction_images/IMG_9131.JPG

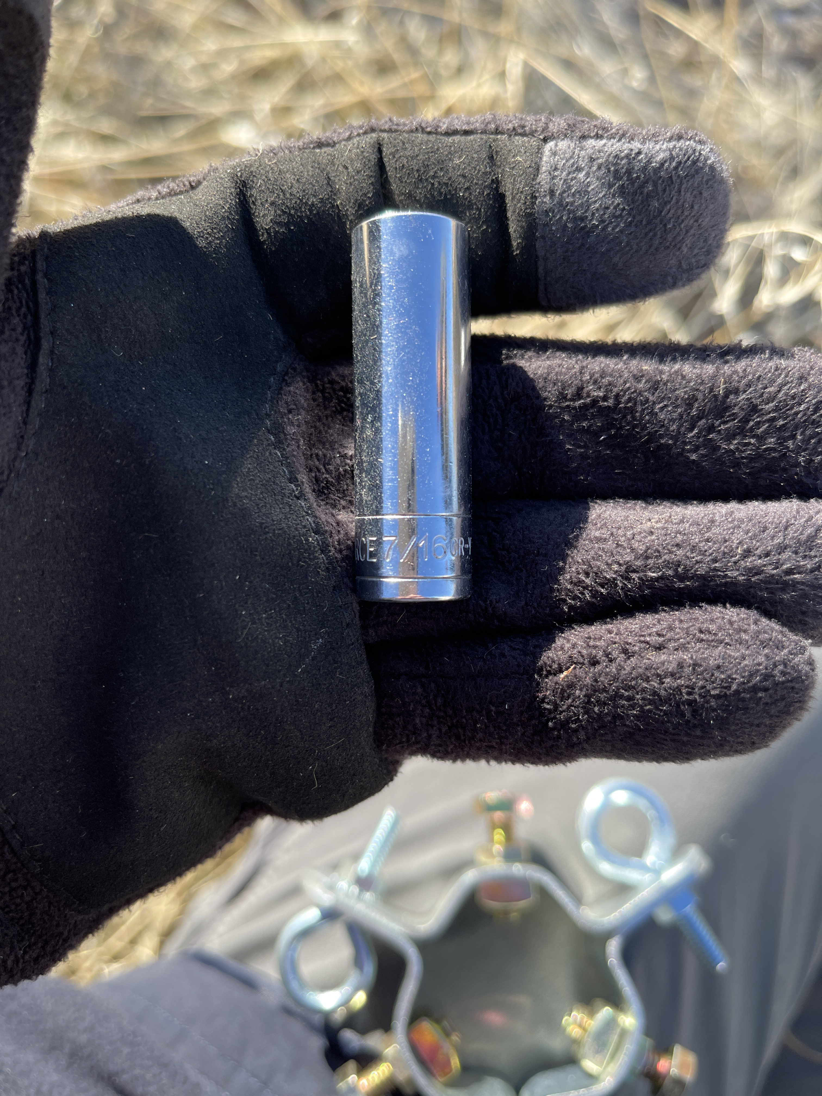
hardware/construction_images/IMG_9131.JPG
