CIROH-Snow/snow_sensing/hardware/construction_images/IMG_9256.JPG

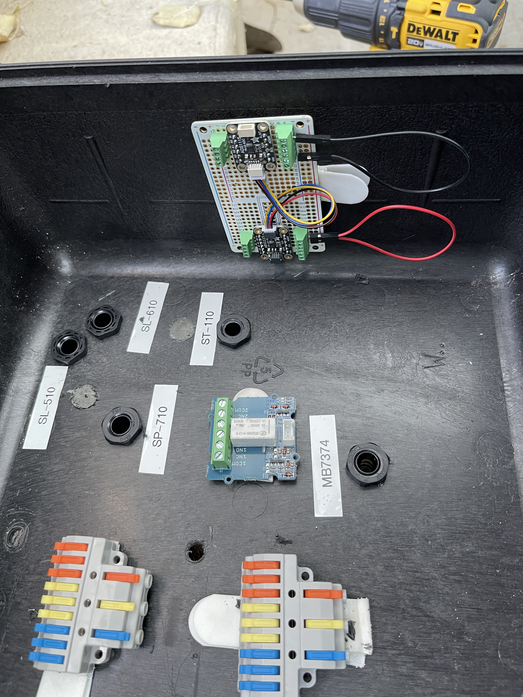
hardware/construction_images/IMG_9256.JPG
